vtmkhoi/Muscular-Atrophy-Measurement-System/docs/meetings/Chart.pptx

DDS
(AD9834)

Sin-wave generator

V_tissue

V_ref

Tetrapolar electrodes

Vp

Differential Amplifier

V_out

Single-Ended

LPF + HPF

V(sin_filt)

Voltage Controlled Current Source
(VCCS)

I(sin_filt)

Vn

SPI

MCU
STM32F411

DAC

Vmag_DC~ |Z|

Gain/Phase Detector
(AD8302 )

Vphs_DC

LOAD

## Power block

12V battery
input

+5V_Pre

Output +3v3 for MCLK and DVDD AD9834

ADP2303-5.0

ADP7118-3.3

TPS7A2033

ADP5070

MCU power

-5V Raw

ADP7182

-5V Analog

ADP7142-5.0

+5V_Analog

## Slide 3

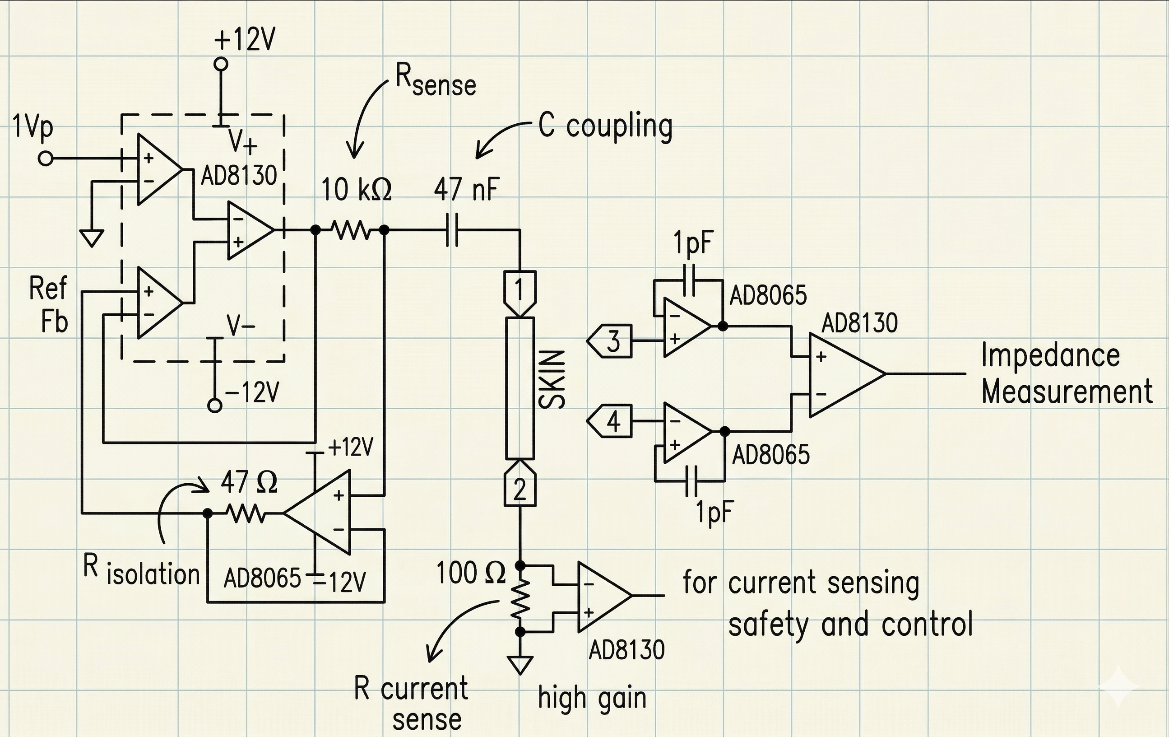
[picture p1: figure]

## Slide 4
