vtmkhoi/Muscular-Atrophy-Measurement-System/docs/meetings/weekly-meeting_29-03-2026.pptx

## BÁO CÁO TIẾN ĐỘ

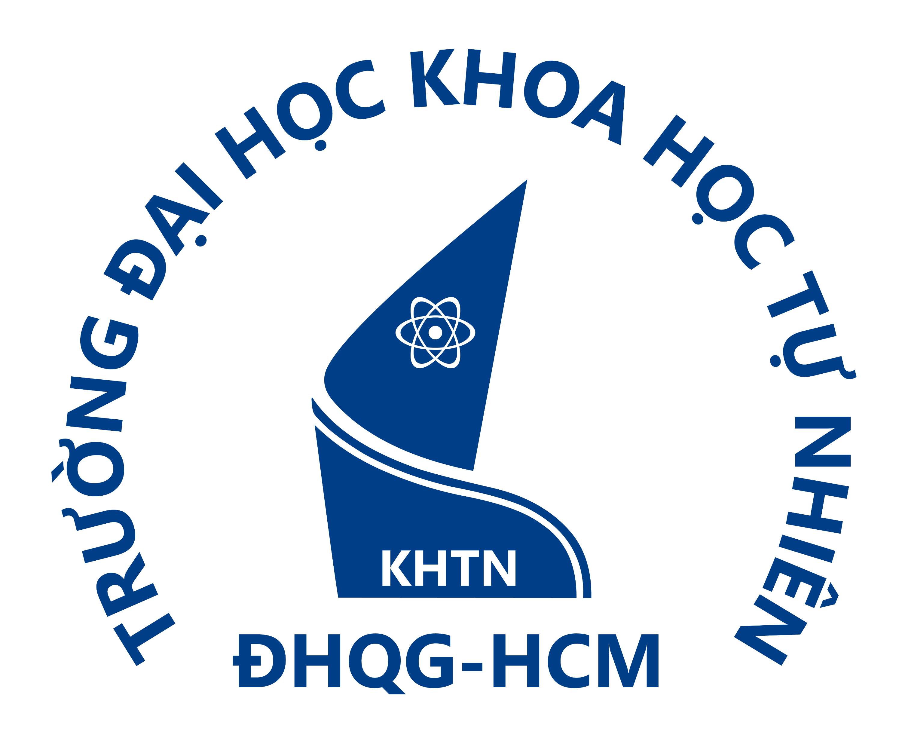
[picture p2: figure]

ĐẠI HỌC QUỐC GIA THÀNH PHỐ HỒ CHÍ MINH
ĐẠI HỌC KHOA HỌC TỰ NHIÊN

Khoa Điện tử - Viễn thông

CBHD: PGS. TS. Nguyễn Văn Hiếu
TS. Phan Thiện Luân
HVCH: Võ Tấn Minh Khôi

TP. HỒ CHÍ MINH, 2026

## Tiến độ

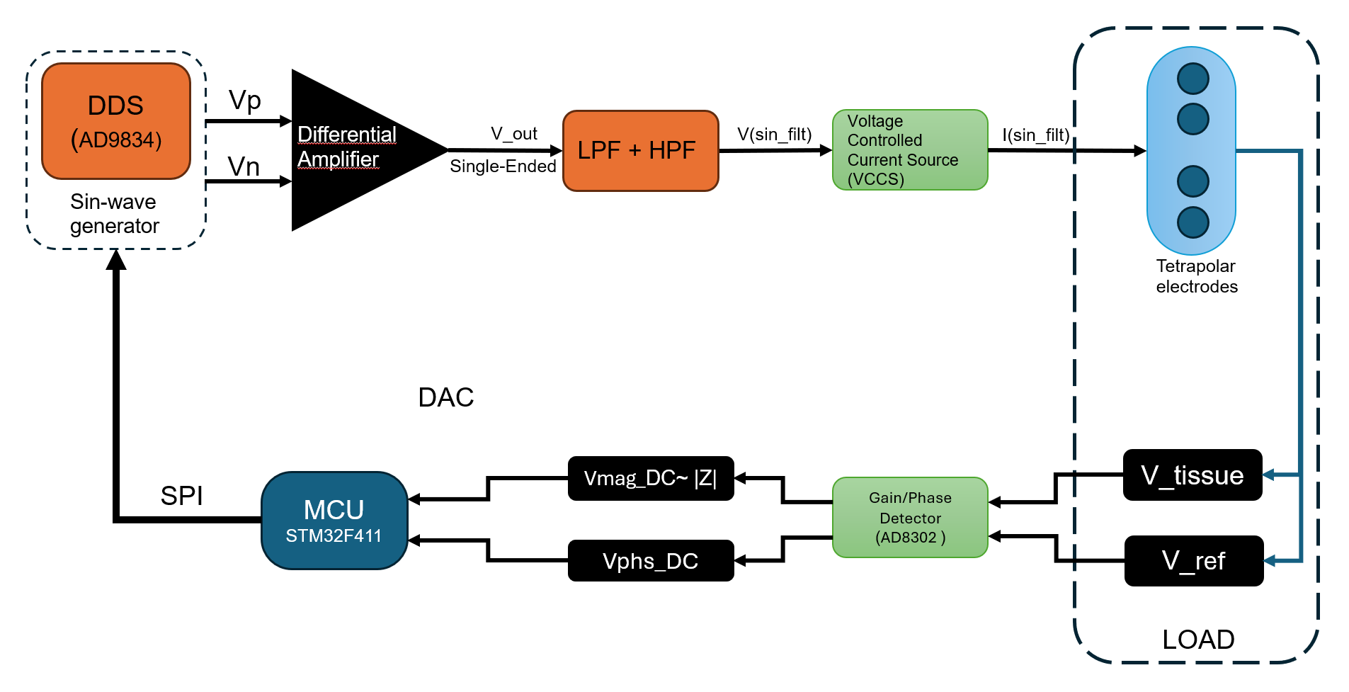
[picture p3: figure]

## Tiến độ

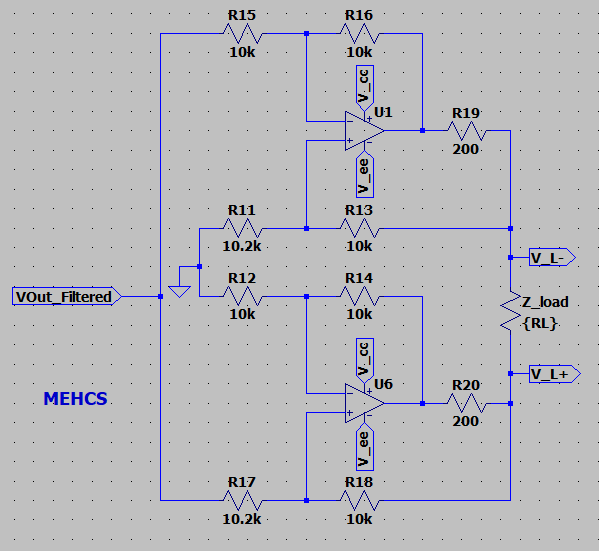
[picture p4: figure]
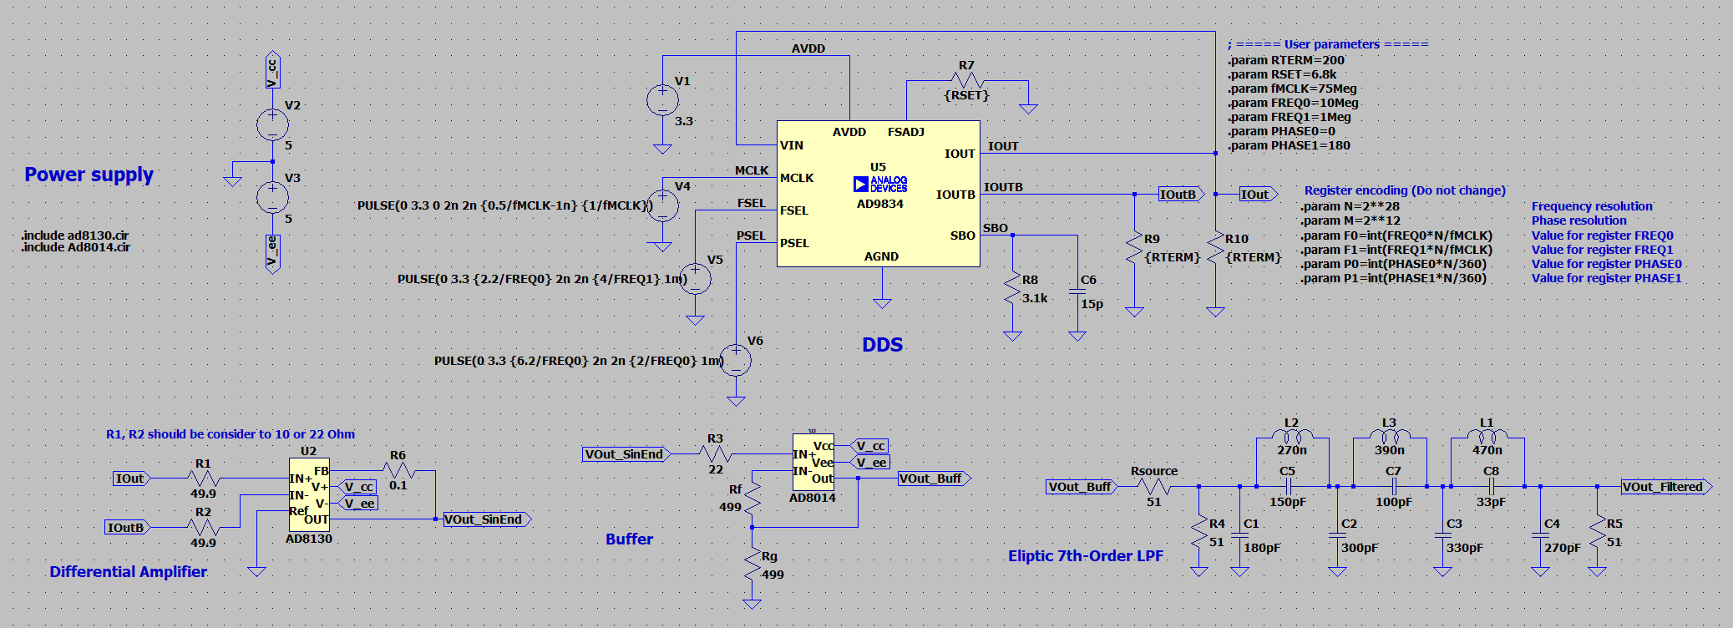
[picture p5: figure]

## Tiến độ

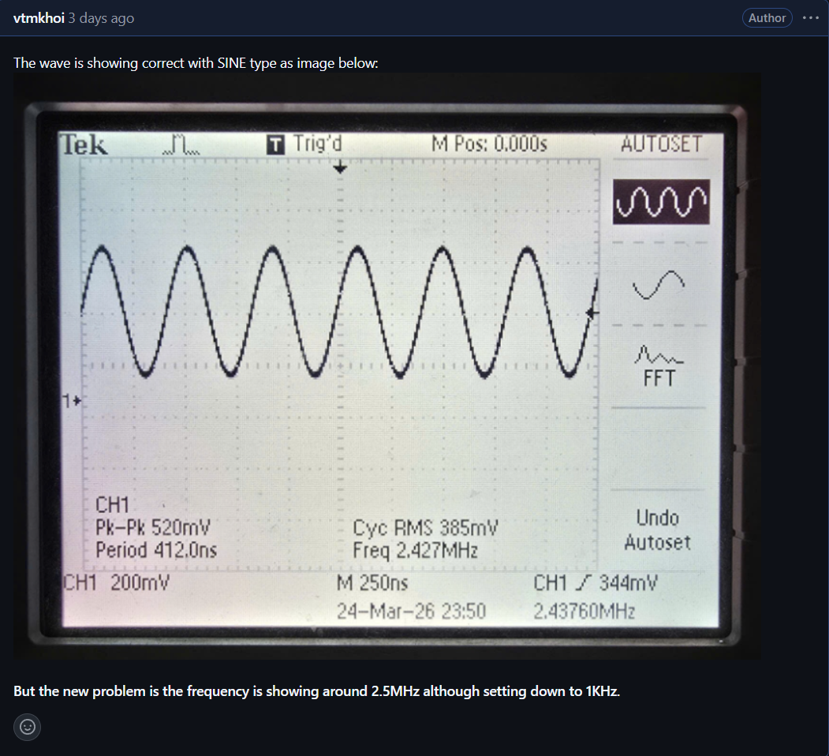
[picture p6: figure]
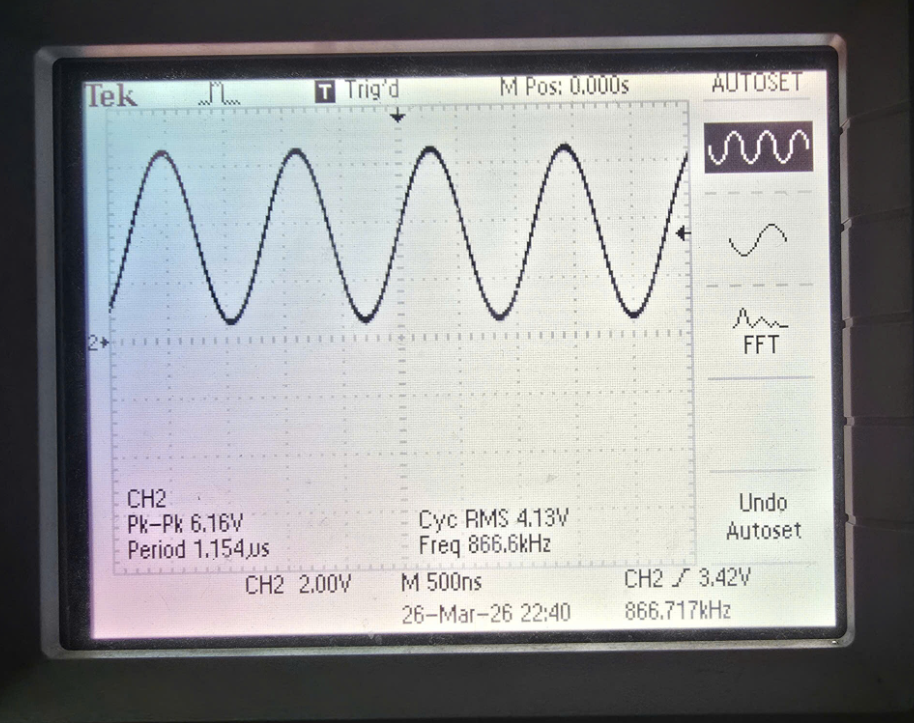
[picture p7: figure]

Analyze output Sine wave from prototype · MAMS (https://github.com/users/vtmkhoi/projects/1/views/1?pane=issue&itemId=168317257)

## Tiến độ

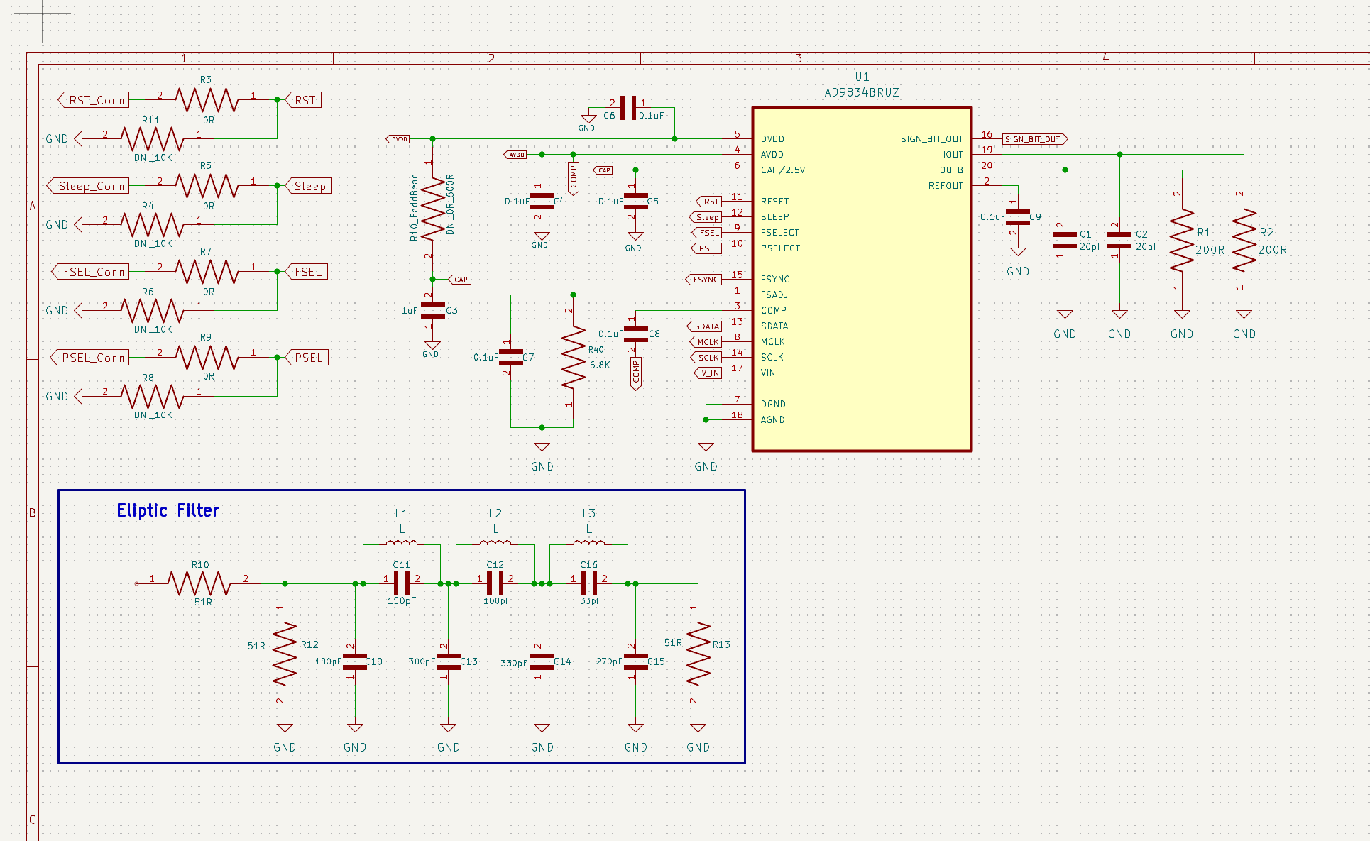
[picture p8: figure]

## Kế hoạch

- Hoàn thiện Schematic
- Layout PCB
- Mua lại module AD9834 để test waveform
