vtmkhoi/Muscular-Atrophy-Measurement-System/docs/AD9834 to AD8130 Differential-to-Single Interface for a 1–15 MHz EIM Signal Source.pdf

# AD9834 to AD8130 Differential-to-Single Interface for a 1–15 MHz EIM Signal Source

## Executive summary

For a 1–15 MHz Electrical Impedance Measurement (EIM) thesis signal source, the most robust, reference-backed way to connect AD9834 (DDS) to AD8130 (diff→single receiver amp) is to treat the AD9834 outputs exactly as a complementary current-output DAC and apply the same principles used in AN-1214 (AD8130 as receiver) and CN-0304 (AD9834 reconstruction filter + buffer) in a single chain.

The key implementation decisions are:

Convert AD9834 IOUT/IOUTB to two matched voltages with load resistors placed at the pins: AD9834 explicitly recommends 200 Ω from IOUT→AGND and preferably 200 Ω from IOUTB→AGND, plus ~20 pF to AGND to suppress clock feedthrough.
Use AD8130 as a true differential receiver: feed the two voltages into +IN (Pin 1) and −IN (Pin 8); set gain with RF/RG and set output common-mode with REF (Pin 4). The datasheet explicitly states gain is G = 1 + RF/RG, unity gain uses RF = 0 and remove RG.
Prefer ± rails for the AD8130 stage if possible: AD8130 supports wide total supply (down to ±2.25 V total, up to ±12.6 V total) and gives wide common-mode range on split supplies (e.g., ±5 V). This avoids the complexity of input level shifting.
Don’t drive the 50 Ω terminated elliptic LC filter directly from AD8130 at high swing: AD8130 guidance warns against directly driving heavy loads at high supply voltages and recommends a second stage where needed. Add a buffer/driver after AD8130.
Use a proven anti-imaging LPF: CN-0304’s 7th-order elliptic, 50 Ω terminated, −3 dB ≈ 18 MHz filter is validated for 15 MHz output and suppresses the largest image at 60 MHz by ~52 dB.
Add an HPF / AC-coupling stage before the VCCS to remove DC for electrode safety and to prevent DC offsets from biasing the current source.
Simulation is still worth doing even if the full AD8130 model is missing: you can import the official AD8130 macro-model from Analog Devices (license-gated), or use a behavioral diff-amp fallback to validate gain/filters.

## Primary sources and authoritative references

Prioritized primary sources (use these first)

AD9834 data sheet (pin-level requirements for IOUT/IOUTB loading, compliance, decoupling, grounding).
AD8129/AD8130 data sheet (true differential receiver behavior, gain networks, common-mode limits, layout rules around FB node).

•

1 (https://www.analog.com/media/en/technical-documentation/data-sheets/ad9834.pdf)
•

2 (https://www.analog.com/media/en/technical-documentation/data-sheets/ad8129_8130.pdf)
•
3 (https://www.analog.com/media/en/technical-documentation/data-sheets/ad8129_8130.pdf) | 4 (https://www.analog.com/media/en/technical-documentation/data-sheets/ad8129_8130.pdf)

•

5 (https://www.analog.com/media/en/technical-documentation/data-sheets/ad8129_8130.pdf)
•

6 (https://www.analog.com/media/en/reference-design-documentation/reference-designs/cn0304.pdf)
•

•

7
8 (https://www.analog.com/en/products/ad8130.html)

•

9 (https://www.analog.com/media/en/technical-documentation/data-sheets/ad9834.pdf)
•

10 (https://www.analog.com/media/en/technical-documentation/data-sheets/ad8129_8130.pdf)

AN-1214 (authoritative ADI reference showing AD8130 used specifically for complementary current-output DAC → single-ended conversion; includes input series resistors guidance and gain examples).

CN-0304 (authoritative end-to-end DDS output conditioning for bioimpedance/impedance spectroscopy use case; includes validated LPF values + measured image suppression).
Supporting, highly relevant references

UG-266 (EVAL-CN0304): shows AD9834 used in biomedical/impedance contexts and points to board-level practices and evaluation approach.
MT-085 (DDS fundamentals and image behavior) – referenced by CN-0304.
MT-031 / MT-101 (grounding mixed-signal converters + decoupling techniques) – explicitly cited by CN-0304 and consistent with AD9834 layout guidance.
TI SBOA436 (“Improved” Howland current pump) + TI AN-1515 (high-impedance VCCS fundamentals + stability/resistor-matching/reactive-load cautions that matter at MHz). User-uploaded copies (same primary documents, local to this chat)

AD9834 datasheet (uploaded).
AD8129/AD8130 datasheet (uploaded).
EVAL-CN0304 user guide (uploaded).

## Electrical interface: converting AD9834 IOUT/IOUTB into a clean differential voltage

What AD9834 expects at IOUT/IOUTB

AD9834’s DAC outputs are high-impedance current sources. The datasheet is unusually explicit about the recommended termination:

IOUT: connect a ~200 Ω load resistor to AGND.
IOUTB: preferably also connect ~200 Ω to AGND (or it may be tied directly to AGND if unused).
Add ~20 pF to AGND to reduce clock feedthrough.

This recommendation is reinforced by CN-0304, which uses RSET = 6.8 kΩ to set full-scale current near 3 mA, then chooses 200 Ω to stay inside compliance and produce about 0.6 V at full-scale.

RSET and amplitude math (why 200 Ω is “right” for AD9834)

AD9834 defines the full-scale DAC current as:

IOUT_FS = 18 × (FSADJUST / RSET) with FSADJUST ≈ 1.15 V and RSET ≈ 6.8 kΩ typical.

CN-0304 computes the same: IFS ≈ 3 mA, and with 200 Ω you get ~0.6 V output without exceeding DAC compliance.

The AD9834 specification table also indicates typical IOUT full scale ≈ 3.0 mA, VOUT max ≈ 0.6 V, and output compliance ≈ 0.8 V (so larger RLOAD risks distortion).

•

11 (https://www.analog.com/media/en/technical-documentation/app-notes/an-1214.pdf)
•

12 (https://www.analog.com/media/en/reference-design-documentation/reference-designs/cn0304.pdf)

•

13 (https://www.analog.com/media/en/technical-documentation/user-guides/ug-266.pdf)
- 14 (https://www.analog.com/media/en/training-seminars/tutorials/MT-085.pdf)
•

15 (https://www.analog.com/media/en/training-seminars/tutorials/MT-031.pdf)
•

16 (https://www.ti.com/lit/pdf/sboa436)

•
•
•

•
•
- 17 (https://www.analog.com/media/en/technical-documentation/data-sheets/ad9834.pdf)

18 (https://www.analog.com/media/en/reference-design-documentation/reference-designs/cn0304.pdf)

- 19 (https://www.analog.com/media/en/technical-documentation/data-sheets/ad9834.pdf)

20 (https://www.analog.com/media/en/reference-design-documentation/reference-designs/cn0304.pdf)

21 (https://www.analog.com/media/en/technical-documentation/data-sheets/ad9834.pdf)

Creating differential voltage for the AD8130 inputs

With two 200 Ω resistors to AGND:

Node Vp = IOUT × 200 Ω
Node Vn = IOUTB × 200 Ω

Because the currents are complementary, these voltages are approximately 180° out of phase, and the differential input to the AD8130 is:

Vdiff = Vp − Vn, which is about 2× the single-ended amplitude (minus any mismatch / DAC nonidealities).

This is exactly the mechanism described in AN-1214 for a complementary current-output DAC: each output develops a voltage across its load resistor that is opposing phase and forms a differential input for the AD8130.

Placement, matching, and parasitics (critical at 10–15 MHz)

At 10–15 MHz, the “small” details determine whether you get clean spectra and stable gain:

Place RLOAD and the 20 pF capacitors right at the AD9834 IOUT pins (short return to AGND). AD9834’s own grounding/decoupling section emphasizes close placement of decoupling and careful mixed-signal layout.
Match the two channels: use the same package size for both RLOAD and both Cfeedthrough; keep traces from IOUT and IOUTB to the load components symmetric in length and geometry.
Use low-parasitic passives: CN-0304 warns that at these frequencies passive components must have low parasitics and low tolerances to match simulated response.
If you will later measure phase precisely (EIM), even small mismatches create phase skew. That becomes “measurement error,” not just “signal conditioning error.”
DC biasing and AC-coupling options

You have two viable philosophies; choose based on your available power rails.

Option A: use split supplies at AD8130 (simplest, best fidelity)
- Keep AD9834 load resistors to AGND as recommended.
- Run AD8130 on ±2.5 V to ±5 V (total supply meets spec).
- Tie REF (Pin 4) = 0 V to generate a ground-referenced single-ended output (then later you can AC-couple before electrodes).
This avoids any input level shifting and keeps the AD9834 output compliance referenced correctly to AGND.

Option B: single +5 V only (works, but requires AC coupling into AD8130)
AD8130’s common-mode range on single supply is limited (example shown in specs).
Because AD9834’s output voltage sits near ground (0–0.6 V typical), the clean approach is: - Keep AD9834 loads to AGND (compliance-safe).
- AC-couple Vp and Vn into AD8130 inputs, then bias both inputs to mid-supply (2.5 V) with equal resistors.
- Set REF = 2.5 V so the output is biased mid-supply.

•
•

•

22 (https://www.analog.com/media/en/technical-documentation/app-notes/an-1214.pdf)

•

23 (https://www.analog.com/media/en/technical-documentation/data-sheets/ad9834.pdf)
•

•

24 (https://www.analog.com/media/en/reference-design-documentation/reference-designs/cn0304.pdf)
•

25 (https://www.analog.com/media/en/technical-documentation/data-sheets/ad9834.pdf)
26

4 (https://www.analog.com/media/en/technical-documentation/data-sheets/ad8129_8130.pdf)

A practical starting point (for 1 MHz minimum): - CIN+ = CIN− = 100 pF to 1 nF (C0G/NP0)
- RBIAS+ = RBIAS− = 10 kΩ to VREF = 2.5 V
This yields fc between ~160 kHz (100 pF & 10 kΩ) and ~16 kHz (1 nF & 10 kΩ), comfortably below 1 MHz while avoiding huge bias resistors.

## AD8130 hookup details and a complete recommended chain

AD8130 pins you will actually use

From the AD8129/AD8130 datasheet pin diagram:

Pin 1: +IN
Pin 8: −IN
Pin 4: REF (output reference / level shifting) Pin 5: FB (feedback node for gain setting) Pin 6: OUT
Pin 7: +VS, Pin 2: −VS
Pin 3: PD (power-down control)

Power-down thresholds are specified relative to +VS (VIH ≈ +VS − 1.5 V, VIL ≈ +VS − 2.5 V).

Core topology (recommended for AD9834 differential drive)

Use the datasheet Basic Gain Circuit (Figure 132), which explicitly supports differential input and states:

“The input signal can be applied either differentially or in a single-ended fashion—all that matters is the magnitude of the differential signal between the two inputs.”

Gain is:

G = 1 + RF/RG, with unity gain achieved by RF = 0 and remove RG.

Recommended values (two practical gain targets)

Gain = 1 (unity, best linearity and stability margin in many layouts) - RF = 0 Ω (short OUT→FB)
- RG omitted
This exactly matches datasheet guidance for AD8130 unity gain.

Gain ≈ 3.5 (use when you need to overcome 50 Ω filter insertion loss and still drive VCCS) - Option 1 (E96-friendly): RG = 499 Ω, RF = 1.24 kΩ → G ≈ 1 + 1240/499 ≈ 3.49
- Option 2 (common values): RG = 402 Ω, RF = 1.00 kΩ → G ≈ 3.49

AN-1214 provides a canonical mid-level example for Gain = 2 using RF = RG = 499 Ω, which validates this resistor scale for high-speed use.

•
•
•
•
•
•
- 27

3 (https://www.analog.com/media/en/technical-documentation/data-sheets/ad8129_8130.pdf)

•

28 (https://www.analog.com/media/en/technical-documentation/data-sheets/ad8129_8130.pdf)

- 2

2 (https://www.analog.com/media/en/technical-documentation/data-sheets/ad8129_8130.pdf)

29 (https://www.analog.com/media/en/technical-documentation/app-notes/an-1214.pdf)

Input series resistors (strongly recommended)

AN-1214 explicitly states that series resistors at the AD8130 input pins improve distortion performance (they used 49.9 Ω).

For AD9834, start with: - RIN+ = RIN− = 49.9 Ω (0402/0603, 1%) placed at the AD8130 pins.

If you are fighting amplitude loss or bandwidth peaking, you can sweep 10–49.9 Ω in lab.

REF pin usage (level shifting)

With ± rails, use REF = 0 V for a ground-referenced output.
With single-supply, use REF = VREF = mid-supply (e.g., 2.5 V).

The datasheet provides multiple “output offset/level translator” examples showing that the REF pin controls output level.

Why you should add a buffer/driver after AD8130

CN-0304’s architecture is DDS → buffer → 50 Ω terminated LC LPF because: - DDS current output and compliance are limited, and the buffer provides isolation and converts the loaded DDS impedance to 50 Ω for a terminated filter.

Similarly, AD8130 is a fast receiver but its datasheet cautions that at high supply voltages and heavy load it is better to use a second stage, and that some gain can be shifted to this stage.

So, treat AD8130 primarily as your diff→SE + gain/level stage, then use a dedicated driver to: - drive the reactive LC filter, - provide a known source impedance (50 Ω environment), - protect AD8130’s FB node from load-induced instability.

Full end-to-end chain wiring (explicit values + rationale)

The following chain is “thesis-safe” because every stage is supported by a primary reference design or datasheet rule.

Download the one-page schematic diagram (PNG)

Stage 1 — AD9834 DAC outputs to voltage

RSET = 6.8 kΩ (FS current setpoint; typical).
RLOAD_IOUT = 200 Ω to AGND.
RLOAD_IOUTB = 200 Ω to AGND (preferred).
CFT_IOUT = 20 pF to AGND; CFT_IOUTB = 20 pF to AGND (clock feedthrough suppression).

22 (https://www.analog.com/media/en/technical-documentation/app-notes/an-1214.pdf)

•
•

30 (https://www.analog.com/media/en/technical-documentation/data-sheets/ad8129_8130.pdf)

31 (https://www.analog.com/media/en/reference-design-documentation/reference-designs/cn0304.pdf)

5 (https://www.analog.com/media/en/technical-documentation/data-sheets/ad8129_8130.pdf)

One-page chain schematic

- 32 (https://www.analog.com/media/en/technical-documentation/data-sheets/ad9834.pdf)
- 25 (https://www.analog.com/media/en/technical-documentation/data-sheets/ad9834.pdf)
- 17 (https://www.analog.com/media/en/technical-documentation/data-sheets/ad9834.pdf)
- 17 (https://www.analog.com/media/en/technical-documentation/data-sheets/ad9834.pdf)

Rationale: This keeps the DAC within its compliance limits and yields a predictable amplitude (~0.6 V scale) validated in CN-0304.

Stage 2 — AD8130 differential receiver (diff→single + gain)

RIN+ = RIN− = 49.9 Ω series into +IN and −IN (distortion aid).
Gain network:
Unity: RF = 0, RG omitted.
Gain≈3.49: RG=499 Ω, RF=1.24 kΩ (or RG=402 Ω, RF=1.00 kΩ). Gain law is from datasheet. REF (Pin 4):
± rails: REF = 0 V
single-supply: REF = 2.5 V (filtered Vref node).
Output: start with ROUT = 22 Ω in series at the AD8130 output before the driver input (stability/edge control).

Supply notes: - AD8130 supports from single +5 V up to ±12 V class supplies.
- Its common-mode range depends on supply; check your chosen mode.

Layout notes: - Keep ground away from FB (Pin 5) to reduce stray capacitance and preserve gain flatness; bypass supplies with 0.01–0.1 µF close and 10 µF farther.

Stage 3 — Buffer/driver (choose one)

Baseline choice (closest to CN-0304): AD8014
CN-0304 uses AD8014 as the buffer to drive a high-quality 50 Ω filter, operating AD8014 on +4.5 V while AD9834 is on +3.3 V.

For single-supply drivers, use the same biasing idea as CN-0304 (AC coupling + mid-supply bias) and the single-supply biasing principles from AN-581.

Alternative driver options (all credible at 15 MHz; pick based on supply/current/noise needs): - AD8057 (VFB): wide supply range and high-speed VFB option.
- OPA695 (CFB): extremely high bandwidth and high output current, can serve as a strong 50 Ω driver.
- LMH6702 (CFB): designed as a wideband low-distortion driver/buffer.

Rationale: CN-0304 explicitly justifies using a buffer to provide isolation and 50 Ω drive for a terminated filter.

Stage 4 — 7th-order elliptic 50 Ω LPF (anti-imaging)

Use the exact CN-0304 LC network (validated at 15 MHz output with 75 MSPS clock):

Terminations: R22 = 51 Ω, R24 = 51 Ω
L1 = 270 nH, C18 = 180 pF, C19 = 150 pF
C21 = 300 pF, L2 = 390 nH, C17 = 100 pF
C22 = 330 pF, L3 = 470 nH, C23 = 33 pF, C24 = 270 pF

33 (https://www.analog.com/media/en/reference-design-documentation/reference-designs/cn0304.pdf)

- 34 (https://www.analog.com/media/en/technical-documentation/app-notes/an-1214.pdf)
•
- 2 (https://www.analog.com/media/en/technical-documentation/data-sheets/ad8129_8130.pdf)
- 2 (https://www.analog.com/media/en/technical-documentation/data-sheets/ad8129_8130.pdf)
•
•
•
•

35
4

36 (https://www.analog.com/media/en/technical-documentation/data-sheets/ad8129_8130.pdf)

37

38 (https://www.analog.com/media/en/reference-design-documentation/reference-designs/cn0304.pdf)

39 (https://www.analog.com/media/en/technical-documentation/data-sheets/ad8057_8058.pdf)
40 (https://www.ti.com/lit/ds/symlink/opa695.pdf)
41 (https://www.ti.com/lit/gpn/LMH6702)

42 (https://www.analog.com/media/en/reference-design-documentation/reference-designs/cn0304.pdf)

•
•
•
- 43 (https://www.analog.com/media/en/reference-design-documentation/reference-designs/cn0304.pdf)

What you should expect if implemented correctly: - −3 dB bandwidth ≈ 18 MHz,
- passband loss ≈ 6 dB due to source/load termination,
- image at 60 MHz suppressed by ~52 dB vs unfiltered (CN-0304 measurement).

Stage 5 — HPF / AC coupling before VCCS

Place this after the LPF and before the VCCS:

Example: CAC = 47 pF, RBIAS = 10 kΩ → fc ≈ 1/(2π·10k·47p) ≈ 339 kHz (well below 1 MHz).

Rationale: removes DC offsets and helps keep electrode injection safe and repeatable.

Stage 6 — VCCS (Improved Howland) to electrodes

At 1–15 MHz this is typically the hardest block. Two authoritative cautions apply:

Resistor mismatch reduces CMRR and causes gain error; reactive loads need special precautions.

Stability and output impedance trimming are practical issues even at low frequencies; at MHz they become dominant.

If your VCCS op-amp cannot sustain loop gain at 15 MHz into a capacitive electrode model, you’ll see current droop and/or oscillation regardless of how perfect the DDS chain is.

## Simulation approach in LTspice

Using the official AD8130 macro-model

The official AD8130 product page provides an “AD8130 SPICE Macro Model” download under Tools & Simulations.
It is license-gated when accessed directly.
LTspice import workflow (recommended) 1. Download the macro-model ( | ad8130.cir | ) from the
AD8130 page (accept license).
2. Follow ADI’s official LTspice guide for importing third-party | .SUBCKT | models.
3. Open the | .cir | file and find the | .SUBCKT AD8130 ... | line; the pin order listed there is the netlist
order you must match (either by building a custom symbol or mapping pins correctly). 4. In your
schematic, add: - a SPICE directive: | .include ad8130.cir | - a symbol using Prefix = X (subcircuit call)
referencing the correct subckt name.

ADI’s LTspice guidance emphasizes that intrinsic symbols can only be reused if the pin/port order matches
the | .SUBCKT | definition.

Behavioral model fallback (when you only need architecture validation)

If your goal is to validate: - amplitude vs frequency, - LPF image suppression, - gross stability of the chain,

44
45 (https://www.analog.com/media/en/reference-design-documentation/reference-designs/cn0304.pdf)

•

•

16 (https://www.ti.com/lit/pdf/sboa436)
•

46 (https://www.ti.com/lit/pdf/snoa474)

47 (https://www.analog.com/en/products/ad8130.html)
48 (https://www.analog.com/media/en/simulation-models/spice-models/ad8130.cir)

49 (https://www.analog.com/en/products/ad8130.html)
50 (https://www.analog.com/en/resources/technical-articles/ltspice-how-to-import-third-party-models.html)

51 (https://www.analog.com/en/resources/technical-articles/ltspice-using-an-intrinsic-symbol-for-a-third-party-model.html)

you can use a simplified behavioral differential amplifier:

Vout = Vref + G·(Vp − Vn)
Add a single-pole rolloff near 150–250 MHz to approximate bandwidth limits (AD8130 is ~270 MHz at small output).

Example LTspice-style snippet (conceptual):

* Behavioral AD8130 (simplified)
.subckt AD8130_BEH VP VN VMIN REF FB OUT VPLUS PD .param G=3.49
* ideal diff gain + reference
BID n_id 0 V = { V(REF) + G*(V(VP)-V(VN)) }
* 1-pole bandwidth limit (e.g., 200 MHz)
EOUT OUT 0 LAPLACE {V(n_id)} = { 1 / (1 + s/(2*pi*200Meg)) }
.ends

This will not match distortion or overload recovery, but it is enough to decide: - whether your gain plan is correct, - whether the elliptic filter values meet the 15 MHz passband, - whether you have enough headroom into the VCCS load model.

Recommended simulation sequence for your thesis chain

AC analysis: From AD8130 output → through driver → through elliptic LPF, verify −3 dB ≈ 18 MHz and observe stopband attenuation near 60 MHz. CN-0304’s measured vs simulated response is your benchmark.
Transient + FFT at 15 MHz: Confirm image locations (DDS is sampled-data; requires anti-imaging).

Step through 1 MHz → 15 MHz: track amplitude flatness and phase shift.
Add electrode load model (R || C) and validate VCCS stability per TI guidance (reactive load precautions).

## PCB/layout best practices, failure modes, and verification plan

PCB/layout practices that matter most at 10–15 MHz

Grounding and planes - AD9834 recommends strong decoupling and careful AGND/DGND strategy (connect at a single point / star near the device in multi-device systems).
- For AD8130, use a solid ground plane but pull back copper around FB to reduce stray capacitance.

Decoupling - AD9834: decouple both analog and digital supplies, keep caps close; use AVDD supply strategy if shared.
- AD8130: 0.01–0.1 µF close per rail, 10 µF farther per rail.

Symmetry - Route IOUT and IOUTB networks symmetrically: equal trace lengths, same via count, same component packages. This directly improves phase accuracy for EIM.

•
•

52 (https://www.analog.com/media/en/technical-documentation/data-sheets/ad8129_8130.pdf)

•

53 (https://www.analog.com/media/en/reference-design-documentation/reference-designs/cn0304.pdf)
•

54 (https://www.analog.com/media/en/reference-design-documentation/reference-designs/cn0304.pdf)
•
•

16 (https://www.ti.com/lit/pdf/sboa436)

23 (https://www.analog.com/media/en/technical-documentation/data-sheets/ad9834.pdf)
36 (https://www.analog.com/media/en/technical-documentation/data-sheets/ad8129_8130.pdf)

55 (https://www.analog.com/media/en/technical-documentation/data-sheets/ad9834.pdf)
36 (https://www.analog.com/media/en/technical-documentation/data-sheets/ad8129_8130.pdf)

Test points - Add test nodes (or u.FL/SMA) at: - Vp and Vn (after 200 Ω loads), - AD8130 output, - driver output, - LPF output, - VCCS output current-sense resistor.

Common failure modes to watch at 10–15 MHz

DAC compliance violation (RLOAD too large or bias shifted incorrectly) → heavy distortion/spurs.

AD8130 FB node parasitics → peaking/flatness loss/oscillation; datasheet warns FB node stray C must be minimized.
Trying to drive the LC filter directly from AD8130 at large swing → thermals/stability; datasheet suggests using a second stage in heavy-load cases.
Reactive VCCS load instability (electrodes are not pure resistors) → oscillation or current droop; TI explicitly warns special precautions are needed for reactive loads in Howland pumps.
Measurement and verification plan (bench)

A practical thesis verification sequence:

Step 1: verify AD9834 output amplitude and symmetry

Measure Vp and Vn (after the 200 Ω loads). Expect complementary waveforms with amplitude consistent with RSET and compliance.

Step 2: verify AD8130 diff→single conversion

Confirm gain = 1 + RF/RG and output reference set by REF.

Sweep amplitude to ensure no clipping; compare to differential clipping guidance.

Step 3: confirm LPF frequency response

If you have access to a network analyzer, reproduce CN-0304’s key targets: ~18 MHz −3 dB, ~6 dB passband loss in 50 Ω environment.

Step 4: spectral image suppression at 15 MHz output

Measure spectrum at LPF output. CN-0304 reports the 60 MHz image is reduced ~52 dB relative to unfiltered output. Your pass/fail target should be “same order,” assuming proper layout and component Q.

Step 5: VCCS verification with dummy loads

Use resistor and resistor||capacitor loads before electrodes; verify current amplitude flatness and check for oscillation. TI Howland references highlight resistor mismatch and reactive-load risk.

•

21 (https://www.analog.com/media/en/technical-documentation/data-sheets/ad9834.pdf)
•

36 (https://www.analog.com/media/en/technical-documentation/data-sheets/ad8129_8130.pdf)
•

5 (https://www.analog.com/media/en/technical-documentation/data-sheets/ad8129_8130.pdf)
•

16 (https://www.ti.com/lit/pdf/sboa436)

•

•

56 (https://www.analog.com/media/en/technical-documentation/data-sheets/ad9834.pdf)

•

- 57 (https://www.analog.com/media/en/technical-documentation/data-sheets/ad8129_8130.pdf)
- 4 (https://www.analog.com/media/en/technical-documentation/data-sheets/ad8129_8130.pdf)

•

•

53 (https://www.analog.com/media/en/reference-design-documentation/reference-designs/cn0304.pdf)

•

•

45 (https://www.analog.com/media/en/reference-design-documentation/reference-designs/cn0304.pdf)

•

•

16 (https://www.ti.com/lit/pdf/sboa436)

## Comparison table of recommended values and parts (with procurement links)

Stage Item

Recommended
value

Suggested MPN

(package) | Why / notes | Example
link
DDS | DDS IC | —

AD9834BRUZ
(TSSOP-20)

AD9834 complete
DDS; outputs
require proper
loading/filters

DDS→V

Load resistors
(x2)

200 Ω, 1%
(0402/0603)

Any low-parasitic
200 Ω (thick film
or thin film)

Per AD9834, 200 Ω
keeps compliance
& provides
amplitude

DDS→V

Feedthrough
caps (x2)

20 pF C0G

Any 20 pF NP0/
C0G

Per AD9834:
suppress clock
feedthrough
Diff→SE | Receiver amp | —

AD8130ARZ
(SOIC-8) or
AD8130ARMZ
(MSOP-8)

Differential
receiver; high
CMRR; gain set by
RF/RG

Diff→SE

Input series
resistors (x2)

49.9 Ω Any 49.9 Ω 1%

AN-1214: series
resistors improve
distortion
Diff→SE | Gain set | RF/RG

RG=499 Ω,
RF=1.24 kΩ →
G≈3.49

G=1+RF/RG per
datasheet

Driver
(option)
CFB buffer | —

AD8014ARZ
(SOIC-8)

CN-0304 proven as
DDS buffer to drive
50 Ω filter

Driver
(option)
VFB buffer | —

AD8057ARZ
(SOIC-8)

Alternative high-speed VFB
amplifier

Driver
(option)

Ultra-
wideband CFB | —

OPA695 (various
packages)

Very high
bandwidth/current
for 50 Ω driving

Driver
(option)

Wideband low
distortion | —

LMH6702 (various
packages)

High-fidelity
wideband driver/
buffer

58 (https://www.digikey.com/en/products/detail/analog-devices-inc/AD9834BRUZ/621882)

25

17 (https://www.analog.com/media/en/technical-documentation/data-sheets/ad9834.pdf)

59 (https://www.digikey.com/en/products/detail/analog-devices-inc/AD8130ARZ/751140)

60 (https://www.analog.com/media/en/technical-documentation/app-notes/an-1214.pdf)

2 (https://www.analog.com/media/en/technical-documentation/data-sheets/ad8129_8130.pdf)

61 (https://www.digikey.com/en/products/detail/analog-devices-inc/AD8014ARZ/620459)

62 (https://www.digikey.com/en/products/detail/analog-devices-inc/AD8057ARZ/620675)

63 (https://www.ti.com/lit/ds/symlink/opa695.pdf)

64 (https://www.ti.com/lit/gpn/LMH6702)

Stage Item

Recommended
value

Suggested MPN

(package) | Why / notes | Example link

LPF

Elliptic filter

values | (see list) | L/C high-Q RF
| | passives

CN-0304 validated:
fc≈18 MHz, image
suppression

VCCS

Howland

reference | — | (depends on your
| | VCCS op-amp
| | choice)

Match resistors;
reactive loads
need precautions

Practical implementation checklist for your thesis build

Implement exactly the AD9834 output loading rule (200 Ω + 20 pF at the pins).
Build AD8130 as Figure 132 “basic gain circuit,” drive it differentially, and obey FB-node layout rules.

Use a dedicated driver stage before the 50 Ω elliptic LPF; CN-0304’s buffer+filter is the correct “known-good” reference for 15 MHz.
Validate LPF response + image suppression on the bench before integrating the VCCS, using CN-0304’s measured results as acceptance targets.
Treat the VCCS as a separate high-speed control-loop problem; include reactive load models and follow Howland stability cautions.

AD9834 (Rev. D)
https://www.analog.com/media/en/technical-documentation/data-sheets/ad9834.pdf
https://www.analog.com/media/en/technical-documentation/data-sheets/ad8129_8130.pdf
https://www.analog.com/media/en/technical-documentation/data-sheets/ad8129_8130.pdf
CN-0304
https://www.analog.com/media/en/reference-design-documentation/reference-designs/cn0304.pdf
https://www.analog.com/en/products/ad8130.html
https://www.analog.com/en/products/ad8130.html
AN-1214 (Rev. A)
https://www.analog.com/media/en/technical-documentation/app-notes/an-1214.pdf
UG-266 (Rev.C)
https://www.analog.com/media/en/technical-documentation/user-guides/ug-266.pdf
https://www.analog.com/media/en/training-seminars/tutorials/MT-085.pdf
https://www.analog.com/media/en/training-seminars/tutorials/MT-085.pdf
https://www.analog.com/media/en/training-seminars/tutorials/MT-031.pdf
https://www.analog.com/media/en/training-seminars/tutorials/MT-031.pdf
https://www.ti.com/lit/pdf/sboa436
https://www.ti.com/lit/pdf/sboa436

65 (https://www.analog.com/media/en/reference-design-documentation/reference-designs/cn0304.pdf)

16 (https://www.ti.com/lit/pdf/sboa436)

- 17 (https://www.analog.com/media/en/technical-documentation/data-sheets/ad9834.pdf)
•

66 (https://www.analog.com/media/en/technical-documentation/data-sheets/ad8129_8130.pdf)
•

67 (https://www.analog.com/media/en/reference-design-documentation/reference-designs/cn0304.pdf)
•

45 (https://www.analog.com/media/en/reference-design-documentation/reference-designs/cn0304.pdf)
•

16 (https://www.ti.com/lit/pdf/sboa436)

1 (https://www.analog.com/media/en/technical-documentation/data-sheets/ad9834.pdf) | 9 (https://www.analog.com/media/en/technical-documentation/data-sheets/ad9834.pdf) | 17 (https://www.analog.com/media/en/technical-documentation/data-sheets/ad9834.pdf) 19 (https://www.analog.com/media/en/technical-documentation/data-sheets/ad9834.pdf) 21 (https://www.analog.com/media/en/technical-documentation/data-sheets/ad9834.pdf) 23 (https://www.analog.com/media/en/technical-documentation/data-sheets/ad9834.pdf) 25 (https://www.analog.com/media/en/technical-documentation/data-sheets/ad9834.pdf) 32 (https://www.analog.com/media/en/technical-documentation/data-sheets/ad9834.pdf) 55 (https://www.analog.com/media/en/technical-documentation/data-sheets/ad9834.pdf) 56 (https://www.analog.com/media/en/technical-documentation/data-sheets/ad9834.pdf)
2 (https://www.analog.com/media/en/technical-documentation/data-sheets/ad8129_8130.pdf) | 3 (https://www.analog.com/media/en/technical-documentation/data-sheets/ad8129_8130.pdf) | 4 (https://www.analog.com/media/en/technical-documentation/data-sheets/ad8129_8130.pdf) | 5 (https://www.analog.com/media/en/technical-documentation/data-sheets/ad8129_8130.pdf) | 10 (https://www.analog.com/media/en/technical-documentation/data-sheets/ad8129_8130.pdf) 26 (https://www.analog.com/media/en/technical-documentation/data-sheets/ad8129_8130.pdf) 27 (https://www.analog.com/media/en/technical-documentation/data-sheets/ad8129_8130.pdf) 28 (https://www.analog.com/media/en/technical-documentation/data-sheets/ad8129_8130.pdf) 30 (https://www.analog.com/media/en/technical-documentation/data-sheets/ad8129_8130.pdf) 35 (https://www.analog.com/media/en/technical-documentation/data-sheets/ad8129_8130.pdf) 36 (https://www.analog.com/media/en/technical-documentation/data-sheets/ad8129_8130.pdf) 52 (https://www.analog.com/media/en/technical-documentation/data-sheets/ad8129_8130.pdf) 57 (https://www.analog.com/media/en/technical-documentation/data-sheets/ad8129_8130.pdf) 66 (https://www.analog.com/media/en/technical-documentation/data-sheets/ad8129_8130.pdf)
6 (https://www.analog.com/media/en/reference-design-documentation/reference-designs/cn0304.pdf) | 12 (https://www.analog.com/media/en/reference-design-documentation/reference-designs/cn0304.pdf) 18 (https://www.analog.com/media/en/reference-design-documentation/reference-designs/cn0304.pdf) 20 (https://www.analog.com/media/en/reference-design-documentation/reference-designs/cn0304.pdf) 24 (https://www.analog.com/media/en/reference-design-documentation/reference-designs/cn0304.pdf) 31 (https://www.analog.com/media/en/reference-design-documentation/reference-designs/cn0304.pdf) 33 (https://www.analog.com/media/en/reference-design-documentation/reference-designs/cn0304.pdf) 37 (https://www.analog.com/media/en/reference-design-documentation/reference-designs/cn0304.pdf) 38 (https://www.analog.com/media/en/reference-design-documentation/reference-designs/cn0304.pdf) 42 (https://www.analog.com/media/en/reference-design-documentation/reference-designs/cn0304.pdf) 43 (https://www.analog.com/media/en/reference-design-documentation/reference-designs/cn0304.pdf) 44 (https://www.analog.com/media/en/reference-design-documentation/reference-designs/cn0304.pdf) 45 (https://www.analog.com/media/en/reference-design-documentation/reference-designs/cn0304.pdf) 53 (https://www.analog.com/media/en/reference-design-documentation/reference-designs/cn0304.pdf) 54 (https://www.analog.com/media/en/reference-design-documentation/reference-designs/cn0304.pdf) 65 (https://www.analog.com/media/en/reference-design-documentation/reference-designs/cn0304.pdf) 67 (https://www.analog.com/media/en/reference-design-documentation/reference-designs/cn0304.pdf)
7 (https://www.analog.com/en/products/ad8130.html) | 8 (https://www.analog.com/en/products/ad8130.html) | 47 (https://www.analog.com/en/products/ad8130.html) 49 (https://www.analog.com/en/products/ad8130.html)

11 (https://www.analog.com/media/en/technical-documentation/app-notes/an-1214.pdf) 22 (https://www.analog.com/media/en/technical-documentation/app-notes/an-1214.pdf) 29 (https://www.analog.com/media/en/technical-documentation/app-notes/an-1214.pdf) 34 (https://www.analog.com/media/en/technical-documentation/app-notes/an-1214.pdf) 60 (https://www.analog.com/media/en/technical-documentation/app-notes/an-1214.pdf)

13 (https://www.analog.com/media/en/technical-documentation/user-guides/ug-266.pdf)

14 (https://www.analog.com/media/en/training-seminars/tutorials/MT-085.pdf)

15 (https://www.analog.com/media/en/training-seminars/tutorials/MT-031.pdf)

16 (https://www.ti.com/lit/pdf/sboa436)

https://www.analog.com/media/en/technical-documentation/data-sheets/ad8057_8058.pdf
https://www.analog.com/media/en/technical-documentation/data-sheets/ad8057_8058.pdf
https://www.ti.com/lit/ds/symlink/opa695.pdf
https://www.ti.com/lit/ds/symlink/opa695.pdf
https://www.ti.com/lit/gpn/LMH6702
https://www.ti.com/lit/gpn/LMH6702
https://www.ti.com/lit/pdf/snoa474
https://www.ti.com/lit/pdf/snoa474
https://www.analog.com/media/en/simulation-models/spice-models/ad8130.cir
https://www.analog.com/media/en/simulation-models/spice-models/ad8130.cir
https://www.analog.com/en/resources/technical-articles/ltspice-how-to-import-third-party-models.html
https://www.analog.com/en/resources/technical-articles/ltspice-how-to-import-third-party-models.html
https://www.analog.com/en/resources/technical-articles/ltspice-using-an-intrinsic-symbol-for-a-third-party-model.html
https://www.analog.com/en/resources/technical-articles/ltspice-using-an-intrinsic-symbol-for-a-third-party-model.html
https://www.digikey.com/en/products/detail/analog-devices-inc/AD9834BRUZ/621882
https://www.digikey.com/en/products/detail/analog-devices-inc/AD9834BRUZ/621882
https://www.digikey.com/en/products/detail/analog-devices-inc/AD8130ARZ/751140
https://www.digikey.com/en/products/detail/analog-devices-inc/AD8130ARZ/751140
https://www.digikey.com/en/products/detail/analog-devices-inc/AD8014ARZ/620459
https://www.digikey.com/en/products/detail/analog-devices-inc/AD8014ARZ/620459
https://www.digikey.com/en/products/detail/analog-devices-inc/AD8057ARZ/620675
https://www.digikey.com/en/products/detail/analog-devices-inc/AD8057ARZ/620675

39 (https://www.analog.com/media/en/technical-documentation/data-sheets/ad8057_8058.pdf)

40 (https://www.ti.com/lit/ds/symlink/opa695.pdf) | 63 (https://www.ti.com/lit/ds/symlink/opa695.pdf)
41 (https://www.ti.com/lit/gpn/LMH6702) | 64 (https://www.ti.com/lit/gpn/LMH6702)

46 (https://www.ti.com/lit/pdf/snoa474)

48 (https://www.analog.com/media/en/simulation-models/spice-models/ad8130.cir)

50 (https://www.analog.com/en/resources/technical-articles/ltspice-how-to-import-third-party-models.html)

51 (https://www.analog.com/en/resources/technical-articles/ltspice-using-an-intrinsic-symbol-for-a-third-party-model.html)

58 (https://www.digikey.com/en/products/detail/analog-devices-inc/AD9834BRUZ/621882)

59 (https://www.digikey.com/en/products/detail/analog-devices-inc/AD8130ARZ/751140)

61 (https://www.digikey.com/en/products/detail/analog-devices-inc/AD8014ARZ/620459)

62 (https://www.digikey.com/en/products/detail/analog-devices-inc/AD8057ARZ/620675)
