vtmkhoi/Muscular-Atrophy-Measurement-System/hardware/pins-configuration.xlsx

STT | Port-Pin | Mapping | Description | Module
1 | PE11 | AD9833_FSYNC |  | EIM
2 | PE12 | SPI4_SCK |  | EIM
3 | PE14 | SPI4_MOSI |  | EIM
