vtmkhoi/Muscular-Atrophy-Measurement-System/docs/presentation.pdf

TỔNG QUAN ĐỀ TÀI:
THIẾT KẾ VÀ CHẾ TẠO THIẾT BỊ ĐÁNH GIÁ CƠ BẮP ĐA THÔNG SỐ ỨNG DỤNG TRONG ĐO ĐỘ DÀY, ĐỘ XƠ VÀ ĐỘ CỨNG CƠ ĐỂ PHÁT HIỆN SỚM BỆNH LÝ THẦN KINH - CƠ
1. GIỚI THIỆU CHUNG
Bệnh lý về cơ, đặc biệt là các bệnh lý thần kinh-cơ và chứng teo cơ do lão hóa/bất động, đang ngày càng gia tăng, gây ảnh hưởng nghiêm trọng đến chất lượng cuộc sống. Việc chẩn đoán sớm và theo dõi khách quan sự tiến triển của bệnh là vô cùng quan trọng. Các phương pháp lâm sàng hiện tại thường tập trung vào một thông số hoặc có tính xâm lấn/chi phí cao. Đề tài này đề xuất thiết kế và chế tạo một thiết bị đa thông số cầm tay, không xâm lấn, tích hợp bốn công nghệ đo lường cốt lõi để cung cấp một bức tranh toàn diện và định lượng về tình trạng cơ bắp.
2. MỤC TIÊU VÀ PHẠM VI ĐỀ TÀI
* Mục tiêu tổng quát: Chế tạo thành công một thiết bị đo lường đa thông số, có khả năng tích hợp và xử lý dữ liệu từ bốn đầu dò (Siêu âm, NIR, EIM, Indentometer) để đánh giá đồng thời các chỉ số sinh học của cơ.
* Mục tiêu cụ thể:
* Đo lường định lượng: Cung cấp các giá trị chính xác về Độ dày cơ (mm), Độ xơ cơ (trở kháng/phổ NIR) và Độ cứng cơ (N/mm).
* Phát triển thuật toán: Xây dựng mô hình xử lý và tích hợp dữ liệu (ví dụ: Học máy) để phân loại và cảnh báo nguy cơ bệnh lý cơ dựa trên sự kết hợp của các thông số.
* Thẩm định: Kiểm tra tính chính xác và độ tin cậy của thiết bị so với các tiêu chuẩn vàng lâm sàng.
3. CƠ SỞ KỸ THUẬT VÀ NGUYÊN LÝ HOẠT ĐỘNG
Thiết bị được cấu thành từ bốn module cảm biến chính, mỗi module tập trung vào một khía cạnh sinh lý của cơ:
Module cảm biến | Thông số đo | Ý nghĩa sinh học
Siêu âm | Độ dày cơ | Khối lượng cơ và cấu trúc cơ học
Cận hồng ngoại | Phổ hấp thụ ánh sáng | Thành phần cơ mỡ, nồng độ oxi, sức khỏe chuyển hóa
Điện trở kháng cơ | Trở kháng điện môcơ | Độ sơ hóa phụ nề và tính toàn vẹn tế bào

Indentometer | Lực/Độ sâu lún | Độ cứng cơ liên quan đến sơ hóa và trương lực

* Nguyên lý tích hợp: Tất cả các đầu dò sẽ được thiết kế để có thể lấy dữ liệu từ cùng một khu vực cơ bắp một cách nhanh chóng. Dữ liệu thô được truyền về một Bộ xử lý trung tâm (MCU/SBC), nơi các thuật toán lọc nhiễu, chuẩn hóa và tổng hợp sẽ tạo ra một Chỉ số Sức khỏe Cơ bắp Tổng thể (Overall Muscle Health Index).
4. Ý NGHĨA KHOA HỌC VÀ ỨNG DỤNG
Đề tài có ý nghĩa đột phá trong chẩn đoán và theo dõi bệnh cơ, cụ thể:
* Y học Lâm sàng: Cung cấp một công cụ không xâm lấn, di động và chi phí thấp thay thế hoặc bổ sung cho các phương pháp đắt tiền (như MRI, sinh thiết cơ) trong việc sàng lọc và theo dõi.
* Độ dày cơ (Siêu âm): Phục vụ theo dõi teo cơ trong bệnh lý thần kinh-cơ (ví dụ: ALS, Dystrophy).
* Độ xơ cơ (EIM, NIR): Đánh giá định lượng sự tích tụ mô xơ, dấu hiệu của bệnh cơ mãn tính.
* Độ cứng (Indentometer): Cung cấp thông tin về trương lực và tính đàn hồi của cơ, quan trọng trong phục hồi chức năng.
* Khoa học Thể thao & Dinh dưỡng: Giúp vận động viên, người cao tuổi theo dõi hiệu quả tập luyện và tình trạng dinh dưỡng cơ bắp.
* Tiềm năng phát triển: Nền tảng thiết bị này có thể mở rộng để tích hợp thêm các cảm biến khác (ví dụ: nhiệt độ bề mặt, EMG) và kết nối không dây (IoT) để theo dõi sức khỏe cơ từ xa.
5. PHƯƠNG PHÁP THỰC HIỆN
