vtmkhoi/Muscular-Atrophy-Measurement-System/docs/BOM_MAMS.xlsx

Sheet: KhoiVTM
No. | DigiKey Part Number | Manufacturer Product Number | Description | Link DigiKey | Qty | Price per Unit ($) | Total Price ($) | Total Price (VND) | Value | Unit | Tolerance (%) | Package | Category | status | System | Note
1 | AD9834BRUZ-REEL7TR-ND | AD9834BRUZ-REEL7 | IC DDS 50MHZ 10BIT 20TSSOP | https://www.digikey.com/en/products/detail/analog-devices-inc/AD9834BRUZ-REEL7/994992 | 4 | $17.9200 | $71.6800 | 1877299.2 ₫ | NaN | N/A | NaN | 20-TSSOP | IC | Done | EIM |  | Total cost USDT | $823.4228
2 | 505-AD8302ARUZ-ND | AD8302ARUZ | IC RF DETECT 2.7GHZ 14TSSOP | https://www.mouser.vn/ProductDetail/Analog-Devices/AD8302ARUZ-RL7?qs=%2FtpEQrCGXCxf7u2FSUHSPQ%3D%3D | 4 | $34.6400 | $138.5600 | 3628886.4 ₫ | NaN | N/A | NaN | 14-TSSOP | IC | Done | EIM |  | Tocal Cost VND | 21505204.82 ₫
3 | 497-14909-ND | STM32F411RET6 | IC MCU 32BIT 512KB FLASH 64LQFP | https://www.digikey.com/en/products/detail/stmicroelectronics/STM32F411RET6/4935722 | 2 | $6.6900 | $13.3800 | 350422.2 ₫ | NaN | N/A |  | 64-LQFP | uC | Done | EIM |  | Total Cost Taiwan | ¥26044.86158
4 | 505-AD8130ARMZ-REELTR-ND | AD8130ARMZ-REEL | IC OPAMP DIFF 1 CIRCUIT 8MSOP | https://www.digikey.com/en/products/detail/analog-devices-inc/AD8130ARMZ-REEL/994072 | 6 | $5.1800 | $31.0800 | 813985.2 ₫ | NaN | N/A | NaN | 8-TSSOP | IC | Done | EIM
5 | 541-3194-2-ND | TNPW06036K80BEEA | RES 6.8K OHM 0.1% 0.21W 0603 | https://www.digikey.com/en/products/detail/vishay-dale/TNPW06036K80BEEA/1606862 | 25 | $0.2300 | $5.7500 | 150592.5 ₫ | 6.8K | Ohm (Ω) | 0.1% | 0603 | Resistor | Done | EIM
6 | 541-3049-2-ND | TNPW0603200RBEEA | RES 200 OHM 0.1% 0.21W 0603 | https://www.digikey.com/en/products/detail/vishay-dale/TNPW0603200RBEEA/1606685 | 25 | $0.2300 | $5.7500 | 150592.5 ₫ | 200 | Ohm (Ω) | 0.1% | 0603 | Resistor | Done | EIM
7 | 541-3634-2-ND | TNPW0603280RBEEA | RES 280 OHM 0.1% 0.21W 0603 | https://www.digikey.com/en/products/detail/vishay-dale/tnpw0603280rbeea/1606702 | 25 | $0.2300 | $5.7500 | 150592.5 ₫ | 280 | Ohm (Ω) | 0.1% | 0603 | Resistor | Done | EIM
8 | TNPW06031K00BEEA | TNP1.00KAATR-ND | RES 1K OHM 0.1% 0.21W 0603 | https://www.digikey.com/en/products/detail/vishay-dale/TNPW06031K00BEEA/1606767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 | 25 | $0.2300 | $5.7500 | 150592.5 ₫ | 1K | Ohm (Ω) | 0.1% | 0603 | Resistor | Done | EIM
9 | 311-22.0HRTR-ND | RC0603FR-0722RL | RES 22 OHM 1% 1/10W 0603 | https://www.digikey.com/en/products/detail/yageo/RC0603FR-0722RL/727055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 | 25 | $0.1000 | $2.5000 | 65475 ₫ | 22 | Ohm (Ω) | 1% | 0603 | Resistor | Done | EIM
10 | RC0603JR-070RL | RC0603JR-070RL | RES 0 OHM JUMPER 1/10W 0603 | https://www.digikey.com/en/products/detail/yageo/RC0603JR-070RL/726675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 | 25 | $0.1000 | $2.5000 | 65475 ₫ | 0 | Ohm (Ω) | N/A | 0603 | Resistor | Done | EIM
11 | 541-2030-2-ND | TNPW0603499RBEEA | RES 499 OHM 0.1% 0.21W 0603 | https://www.digikey.com/en/products/detail/vishay-dale/tnpw0603499rbeea/1606732 | 25 | $0.2300 | $5.7500 | 150592.5 ₫ | 499 | Ohm (Ω) | 0.1% | 0603 | Resistor | Done | EIM
12 | TNPW06031K78BEEA | 541-TNPW06031K78BEEATR-ND | RES 1.78K OHM 0.1% 0.21W 0603 | https://www.digikey.cn/en/products/detail/vishay-dale/tnpw06031k78beea/1606793 | 25 | $0.2300 | $5.7500 | 150592.5 ₫ | 1.78K | Ohm (Ω) | 0.1% | 0603 | Resistor | Done | EIM
13 | 311-510HRTR-ND | RC0603FR-07510RL | RES 510 OHM 1% 1/10W 0603 | https://www.digikey.com/en/products/detail/yageo/rc0603fr-07510rl/727285 | 25 | $0.1000 | $2.5000 | 65475 ₫ | 510 | Ohm (Ω) | 1% | 0603 | Resistor | Done | EIM
14 | 2266-RC0603FR-072K67LTR-ND | RC0603FR-072K67L | RES 2.67K OHM 1% 0.1W, 1/10W 0603 | https://www.digikey.com/en/products/detail/yageo-america/rc0603fr-072k67l/22283163 | 25 | $0.0020 | $0.0500 | 1309.5 ₫ | 2.67K | Ohm (Ω) | 1% | 0603 | Resistor | Done | EIM
15 | 311-51.0HRTR-ND | RC0603FR-0751RL | RES 51 OHM 1% 1/10W 0603 | https://www.digikey.com/en/products/detail/yageo/rc0603fr-0751rl/727281 | 25 | $0.1000 | $2.5000 | 65475 ₫ | 51 | Ohm (Ω) | 1% | 0603 | Resistor | Done | EIM
16 | 311-10.0KHRTR-ND | RC0603FR-0710KL | RES 10K OHM 1% 1/10W 0603 | https://www.digikey.com/en/products/detail/yageo/rc0603fr-0710kl/726880 | 25 | $0.1000 | $2.5000 | 65475 ₫ | 10K | Ohm (Ω) | 1% | 0603 | Resistor | Done | EIM
17 | TNP10.0AATR-ND | TNPW060310R0BEEA | RES 10 OHM 0.1% 0.21W 0603 | https://www.digikey.com/en/products/detail/vishay-dale/tnpw060310r0beea/1606539 | 25 | $0.3100 | $7.7500 | 202972.5 ₫ | 10 | Ohm (Ω) | 0.1% | 0603 | Resistor | Done | EIM
18 | 490-1410-2-ND | GRM1885C1H200JA01D | CAP CER 20PF 50V C0G/NP0 0603 | https://www.digikey.com/en/products/detail/murata-electronics/GRM1885C1H200JA01D/586920 | 25 | $0.1200 | $3.0000 | 78570 ₫ | 20P | Farad (F) |  | 0603 | Capacitor | Done | EIM
19 | 490-10700-2-ND | GRM155R71H104KE14D | CAP CER 0.1UF 50V X7R 0603 | https://www.digikey.com/en/products/detail/kemet/C0603C104K5RACTU/1465594 | 25 | $0.0800 | $2.0000 | 52380 ₫ | 0.1U | Farad (F) |  | 0603 | Capacitor | Done | EIM
20 | 399-C0603C105K3RACTUTR-ND | C0603C105K3RACTU | CAP CER 1UF 25V X7R 0603 | https://www.digikey.com/en/products/detail/kemet/C0603C105K3RACTU/3317410 | 25 | $0.4100 | $10.2500 | 268447.5 ₫ | 1U | Farad (F) |  | 0603 | Capacitor | Done | EIM
21 | GRM1555C1H1R0WA01J-ND | GRM1555C1H1R0WA01J | CAP CER 1PF 50V C0G/NP0 0402 | https://www.digikey.com/en/products/detail/murata-electronics/grm1555c1h1r0wa01j/4904825 | 25 | $0.0148 | $0.3700 | 9690.3 ₫ | 1P | Farad (F) |  | 0402 | Capacitor | Done | EIM
22 | 311-1873-2-ND | CC0805KKX5R9BB225 | CAP CER 2.2UF 50V X5R 0805 | https://www.digikey.com/en/products/detail/yageo/CC0805KKX5R9BB225/5195775 | 25 | $0.0250 | $0.6250 | 16368.75 ₫ | 2.2U | Farad (F) |  | 0805 | Capacitor | Done | EIM
23 | 490-16772-2-ND | GRM1885C1H181JA01J | CAP CER 180PF 50V C0G/NP0 0603 | https://www.digikey.com/en/products/detail/murata-electronics/grm1885c1h181ja01j/2611094 | 25 | $0.0182 | $0.4555 | 11929.545 ₫ | 180P | Farad (F) |  | 0603 | Capacitor | Done | EIM
24 | 490-1438-2-ND | GRM1885C1H301JA01D | CAP CER 300PF 50V C0G/NP0 0603 | https://www.digikey.com/en/products/detail/murata-electronics/grm1885c1h301ja01d/586964 | 25 | $0.1300 | $3.2500 | 85117.5 ₫ | 300P | Farad (F) |  | 0603 | Capacitor | Done | EIM
25 | 490-16776-2-ND | GRM1885C1H331JA01J | CAP CER 330PF 50V C0G/NP0 0603 | https://www.digikey.com/en/products/detail/murata-electronics/grm1885c1h331ja01j/2611160 | 25 | $0.1100 | $2.7500 | 72022.5 ₫ | 330P | Farad (F) |  | 0603 | Capacitor | Done | EIM
26 | 490-11457-2-ND | GRM1885C1H271JA01J | CAP CER 270PF 50V C0G/NP0 0603 | https://www.digikey.com/en/products/detail/murata-electronics/grm1885c1h271ja01j/2611130 | 25 | $0.0250 | $0.6252 | 16375.2975 ₫ | 270P | Farad (F) |  | 0603 | Capacitor | Done | EIM
27 | 490-1419-2-ND | GRM1885C1H470JA01D | CAP CER 47PF 50V C0G/NP0 0603 | https://www.digikey.com/en/products/detail/murata-electronics/GRM1885C1H470JA01D/586904 | 25 | $0.1200 | $3.0000 | 78570 ₫ | 47P | Farad (F) |  | 0603 | Capacitor | Done | EIM
28 | 490-3285-2-ND | GRM188R72A104KA35D | CAP CER 0.1UF 100V X7R 0603 | https://www.digikey.com/en/products/detail/murata-electronics/GRM188R72A104KA35D/702826 | 25 | $0.1400 | $3.5000 | 91665 ₫ | 0.1U | Farad (F) |  | 0603 | Capacitor | Done | EIM
29 | 490-GRM188R72A103KA01DTR-ND | GRM188R72A103KA01D | CAP CER 10000PF 100V X7R 0603 | https://www.digikey.com/en/products/detail/murata-electronics/GRM188R72A103KA01D/3845635 | 25 | $0.1000 | $2.5000 | 65475 ₫ | 10000P | Farad (F) |  | 0603 | Capacitor | Done | EIM
30 | P49.9HTR-ND | ERJ-3EKF49R9V | RES SMD 49.9 OHM 1% 1/10W 0603 | ERJ-3EKF49R9V Panasonic Electronic Components | Resistors | DigiKey (https://www.digikey.com/en/products/detail/panasonic-electronic-components/ERJ-3EKF49R9V/196378) | 25 | $0.1000 | $2.5000 | 65475 ₫ | 49.9 | Ohm (Ω) | 1% | 0603 | Resistor | Done | EIM
31 | 505-AD8014ARZ-ND | AD8014ARZ | IC OPAMP CFA 1 CIRCUIT 8SOIC | https://www.digikey.com/en/products/detail/analog-devices-inc/ad8014arz/620459 | 4 | $4.5900 | $18.3600 | 480848.4 ₫ | NaN | N/A | NaN | 8SOIC | IC | Done | EIM
32 | 490-1181-1-ND | LQW18ANR27J00D | FIXED IND 270NH 0603 (Murata LQW18, high-Q) | https://www.digikey.com/en/products/detail/murata-electronics/LQW18ANR27J00D/584389 | 25 | $0.1100 | $2.7500 | 72022.5 ₫ | 270n | Henry (H) |  | 0603 | Inductor | Done | EIM
33 | 490-1183-1-ND | LQW18ANR39J00D | FIXED IND 390NH 0603 (Murata LQW18, high-Q) | https://www.digikey.com/en/products/detail/murata-electronics/LQW18ANR39J00D/584391 | 25 | $0.1100 | $2.7500 | 72022.5 ₫ | 390n | Henry (H) |  | 0603 | Inductor | Done | EIM
34 | 490-1184-1-ND | LQW18ANR47J00D | FIXED IND 470NH 0603 (Murata LQW18, high-Q) | https://www.digikey.com/en/products/detail/murata-electronics/LQW18ANR47J00D/584392 | 25 | $0.1100 | $2.7500 | 72022.5 ₫ | 470n | Henry (H) |  | 0603 | Inductor | Done | EIM
35 | 535-11201-1-ND | ASDMB-75.000MHZ-LY-T | MEMS OSC XO 75.0000MHZ LVCMOS (AD9834 MCLK) | https://www.digikey.com/en/products/detail/abracon-llc/ASDMB-75-000MHZ-LY-T/2624314 | 4 | $3.8500 | $15.4000 | 403326 ₫ | 75M | Hertz (Hz) |  | 4-SMD | Ocsillator | Done | EIM
36 | 296-50411-1-ND | TLV75533PDBVR | IC REG LINEAR 3.3V 500MA | https://www.digikey.com/en/products/detail/texas-instruments/TLV75533PDBVR/9356541 | 10 | $0.2500 | $2.5000 | 65475 ₫ | NaN | N/A | NaN | SOT-23-5 | IC-Power | Done | EIM
37 | F3733CT-ND | 1206L050/15YR | PTC RESET FUSE 15V 500MA 1206 (input protection) | https://www.digikey.com/en/products/detail/littelfuse-inc/1206L050-15YR/1211396 | 10 | $0.4260 | $4.2600 | 111569.4 ₫ | NaN | N/A |  | 1206 | FUSE | Done | EIM
38 | 4878-SMF5.0ACT-ND | SMF5.0A | TVS DIODE 5VWM 9.2VC SOD-123F (5V rail surge/ESD) | https://www.digikey.com/en/products/detail/diotec-semiconductor/SMF5-0A/13163545 | 10 | $0.2500 | $2.5000 | 65475 ₫ |  |  |  | SOD-123F | Diode | Done | EIM
40 | 1801-SS24CT-ND | SS24 | DIODE SCHOTTKY 40V 2A DO214AA | https://www.digikey.sg/en/products/detail/taiwan-semiconductor-corporation/SS24/7369395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 | 10 | $0.3460 | $3.4600 | 90617.4 ₫ |  |  |  |  | Diode | Done | EIM
41 | 490-5313-1-ND | GRM32ER71E226KE15L | CAP CER 22UF 25V X7R 1210 | https://www.digikey.sg/en/products/detail/murata-electronics/grm32er71e226ke15l/2039040 | 10 | $1.0000 | $10.0000 | 261900 ₫ | 22U | Farad (F) |  | 1210 | Capacitor | Done | EIM
42 | 490-10700-1-ND | GRM155R71H104KE14D | CAP CER 0.1UF 50V X7R 0402 | https://www.digikey.sg/en/products/detail/murata-electronics/grm155r71h104ke14d/4906220 | 30 | $0.1400 | $4.2000 | 109998 ₫ | 0.1U | Farad (F) |  | 0402 | Capacitor | Done | EIM
43 | 505-ADP5070AREZ-ND | ADP5070AREZ | IC REG BST SEPIC ADJ DL 20TSSOP | https://www.digikey.sg/en/products/detail/analog-devices-inc/ADP5070AREZ/5408965 | 4 | $10.7500 | $43.0000 | 1126170 ₫ |  | N/A | NaN |  | IC-Power | Done | EIM
44 | DFLS240-7DICT-ND | DFLS240-7 | DIODE SCHOTTK 40V 2A POWERDI 123 | https://www.digikey.sg/en/products/detail/diodes-incorporated/DFLS240-7/1934953 | 30 | $0.4760 | $14.2800 | 373993.2 ₫ |  |  |  |  | Diode | Done | EIM
45 | 1712-CPF0603B604KE1CT-ND | CPF0603B604KE1 | RES 604 KOHM 0.1% 1/16W 0603 | https://www.digikey.sg/en/products/detail/te-connectivity-passive-product/CPF0603B604KE1/7493601 | 30 | $0.2400 | $7.2000 | 188568 ₫ | 604 | Ohm (Ω) | 0.1% | 0603 | Resistor | Done | EIM
46 | 311-100KHRCT-ND | RC0603FR-07100KL | RES 100K OHM 1% 1/10W 0603 | https://www.digikey.sg/en/products/detail/vishay-dale/TNPW0603100KBEEN/1610202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 | 30 | $0.1000 | $3.0000 | 78570 ₫ | 100K | Ohm (Ω) | 1% | 0603 | Resistor | Done | EIM
47 | 311-649KHRCT-ND | RC0603FR-07649KL | RES 649K OHM 1% 1/10W 0603 | https://www.digikey.sg/en/products/detail/yageo/rc0603fr-07649kl/727346 | 30 | $0.1000 | $3.0000 | 78570 ₫ | 649K | Ohm (Ω) | 1% | 0603 | Resistor | Done | EIM
48 | 490-3886-1-ND | GRM21BR61C106KE15L | CAP CER 10UF 16V X5R 0805 | https://www.digikey.sg/en/products/detail/murata-electronics/GRM21BR61C106KE15L/965900 | 30 | $0.1200 | $3.6000 | 94284 ₫ | 10U | Farad (F) |  | 0805 | Capacitor | Done | EIM
49 | 311-12.0KHRCT-ND | RC0603FR-0712KL | RES 12K OHM 1% 1/10W 0603 | https://www.digikey.sg/en/products/detail/yageo/rc0603fr-0712kl/726913 | 30 | $0.1000 | $3.0000 | 78570 ₫ | 12K | Ohm (Ω) | 1% | 0603 | Resistor | Done | EIM
50 | 490-5854-1-ND | GCJ188R71H473KA12D | CAP CER 0.047UF 50V X7R 0603 | https://www.digikey.sg/en/products/detail/murata-electronics/GCJ188R71H473KA12D/2785873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 | 30 | $0.1300 | $3.9000 | 102141 ₫ | 0.047U | Farad (F) | 10.00% | 0603 | Capacitor | Done | EIM
51 | 311-15.0KHRCT-ND | RC0603FR-0715KL | RES 15K OHM 1% 1/10W 0603 | https://www.digikey.sg/en/products/detail/yageo/RC0603FR-0715KL/726953 | 30 | $0.1000 | $3.0000 | 78570 ₫ | 15K | Ohm (Ω) | 1% | 0603 | Resistor | Done | EIM
52 | 490-5799-1-ND | GCJ188R71H683KA12D | CAP CER 0.068UF 50V X7R 0603 | https://www.digikey.sg/en/products/detail/murata-electronics/gcj188r71h683ka12d/2783812 | 30 | $0.1500 | $4.5000 | 117855 ₫ | 0.068U | Farad (F) |  | 0603 | Capacitor | Done | EIM
53 | 490-1427-1-ND | GRM1885C1H101JA01D | CAP CER 100PF 50V C0G/NP0 0603 | https://www.digikey.sg/en/products/detail/murata-electronics/grm1885c1h101ja01d/586921 | 30 | $0.0800 | $2.4000 | 62856 ₫ | 100P | Farad (F) |  | 0603 | Capacitor | Done | EIM
54 | 505-ADP7142AUJZ-5.0-R7CT-ND | ADP7142AUJZ-5.0-R7 | IC REG LINEAR 5V 200MA TSOT-23-5 | https://www.digikey.sg/en/products/detail/analog-devices-inc/adp7142aujz-5-0-r7/5056896 | 4 | $4.0500 | $16.2000 | 424278 ₫ | NaN | N/A | NaN |  | IC-Power | Done | EIM
55 | 505-ADP7182AUJZ-5.0-R7CT-ND | ADP7182AUJZ-5.0-R7 | IC REG LINEAR -5V 200MA TSOT-23-5 | https://www.digikey.sg/en/products/detail/analog-devices-inc/adp7182aujz-5-0-r7/4901224 | 4 | $5.0500 | $20.2000 | 529038 ₫ | NaN | N/A | NaN |  | IC-Power | Done | EIM
56 | 296-TPS7A2033PDBVRCT-ND | TPS7A2033PDBVR | IC REG LINEAR 3.3V 300MA SOT23-5 | https://www.digikey.sg/en/products/detail/texas-instruments/tps7a2033pdbvr/13566866 | 10 | $0.3200 | $3.2000 | 83808 ₫ | NaN | N/A | NaN |  | IC-Power | Done | EIM
57 | 296-50411-1-ND | TLV75533PDBVR | IC REG LINEAR 3.3V 500MA SOT23-5 | https://www.digikey.sg/en/products/detail/texas-instruments/tlv75533pdbvr/9356541 | 10 | $0.3600 | $3.6000 | 94284 ₫ | NaN | N/A | NaN |  | IC-Power | Done | EIM
58 | 490-5258-1-ND | BLM18KG601SN1D | FERRITE BEAD 600 OHM 0603 1LN | https://www.digikey.sg/en/products/detail/murata-electronics/blm18kg601sn1d/1982766 | 25 | $0.1000 | $2.5000 | 65475 ₫ | 600 | Ohm (Ω) |  | 0603 | Ferrite bead | Done | EIM
59 | 490-1543-1-ND | GRM188R61A105KA61D | CAP CER 1UF 10V X5R 0603 | https://www.digikey.sg/en/products/detail/murata-electronics/GRM188R61A105KA61D/587071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 | 30 | $0.1100 | $3.3000 | 86427 ₫ | 1U | Farad (F) |  | 0603 | Capacitor | Done | EIM
60 | 541-2.61KHCT-ND | CRCW06032K61FKEA | RES SMD 2.61K OHM 1% 1/8W 0603 | https://www.digikey.com/en/products/detail/vishay-dale/CRCW06032K61FKEA/1174713 | 25 | $0.1000 | $2.5000 | 65475 ₫ | 2.61K | Ohm (Ω) | 1% | 0603 | Resistor | Done | EIM
61 | 399-C0402C151K5RACTUCT-ND | C0402C151K5RACTU | CAP CER 150PF 50V X7R 0402 | https://www.digikey.com/en/products/detail/kemet/C0402C151K5RACTU/1933627 | 25 | $0.3400 | $8.5000 | 222615 ₫ | 150P | Farad (F) |  | 0402 | Capacitor | Done | EIM
62 | 1276-1070-1-ND | CL10C330JB8NNNC | CAP CER 33PF 50V C0G/NP0 0603 | https://www.digikey.com/en/products/detail/samsung-electro-mechanics/CL10C330JB8NNNC/3886728 | 25 | $0.1000 | $2.5000 | 65475 ₫ | 33P | Farad (F) |  | 0603 | Capacitor | Done | EIM
63 | 738-RNCF0603TKY49R9CT-ND | RNCF0603TKY49R9 | RES 49.9 OHM 0.01% 1/10W 0603 | https://www.digikey.com/en/products/detail/stackpole-electronics-inc/RNCF0603TKY49R9/4072345 | 12 | $1.1760 | $14.1120 | 369593.28 ₫ | 49.9 | Ohm (Ω) | 0.01% | 0603 | Resistor | Ordering | EIM
64 | RNCF0603TKY1K00CT-ND | RNCF0603TKY1K00 | RES SMD 1K OHM 0.01% 1/10W 0603 | https://www.digikey.com/en/products/detail/stackpole-electronics-inc/RNCF0603TKY1K00/2269697 | 10 | $1.1760 | $11.7600 | 307994.4 ₫ | 1K | Ohm (Ω) | 0.01% | 0603 | Resistor | Ordering | EIM
65 | 738-RNCF0603TKY499RCT-ND | RNCF0603TKY499R | RES SMD 499 OHM 0.01% 1/10W 0603 | https://www.digikey.com/en/products/detail/stackpole-electronics-inc/RNCF0603TKY499R/4072346 | 10 | $1.1760 | $11.7600 | 307994.4 ₫ | 499 | Ohm (Ω) | 0.01% | 0603 | Resistor | Ordering | EIM
66 | RG20N51WCT-ND | RG2012N-510-W-T1 | RES SMD 51 OHM 0.05% 1/8W 0805 | https://www.digikey.com/en/products/detail/susumu/RG2012N-510-W-T1/600657 | 10 | $0.4816 | $4.8160 | 126131.04 ₫ | 51 | Ohm (Ω) | 0.05% | 0805 | Resistor | Ordering | EIM
67 | P100KBECT-ND | ERA-3ARW104V | RES SMD 100K OHM 0.05% 1/10W 0603 | https://www.digikey.com/en/products/detail/panasonic-industry/ERA-3ARW104V/3073685 | 10 | $0.3412 | $3.4120 | 89360.28 ₫ | 100K | Ohm (Ω) | 0.05% | 0603 | Resistor | Ordering | EIM
68 | 408-RG1608N-103-W-T5CT-ND | RG1608N-103-W-T5 | RES SMD 10K OHM 0.05% 1/10W 0603 | https://www.digikey.com/en/products/detail/susumu/RG1608N-103-W-T5/1257543 | 20 | $0.4208 | $8.4160 | 220415.04 ₫ | 10K | Ohm (Ω) | 0.05% | 0603 | Resistor | Ordering | EIM
69 | RG16N47WCT-ND | RG1608N-470-W-T1 | RES SMD 47 OHM 0.05% 1/10W 0603 | https://www.digikey.com/en/products/detail/susumu/RG1608N-470-W-T1/600565 | 10 | $0.4404 | $4.4040 | 115340.76 ₫ | 47 | Ohm (Ω) | 0.05% | 0603 | Resistor | Ordering | EIM
70 | RNCF0603AKT10R0CT-ND | RNCF0603AKT10R0 | RES SMD 10 OHM 0.05% 1/10W 0603 | https://www.digikey.com/en/products/detail/stackpole-electronics-inc/RNCF0603AKT10R0/4928378 | 15 | $0.6500 | $9.7500 | 255352.5 ₫ | 10 | Ohm (Ω) | 0.05% | 0603 | Resistor | Ordering | EIM
71 | 490-16342-1-ND | GRM1885C1H1R0WA01D | CAP CER 1PF 50V C0G/NP0 0603 | https://www.digikey.com/en/products/detail/murata-electronics/GRM1885C1H1R0WA01D/7363086 | 25 | $0.1090 | $2.7250 | 71367.75 ₫ | 1P | Farad (F) | 5.00% | 0603 | Capacitor | Ordering | EIM
72 | 505-AD8066ARZ-R7CT-ND | AD8066ARZ-R7 | IC VOLTAGE FEEDBACK 2 CIRC 8SOIC | https://www.digikey.com/en/products/detail/analog-devices-inc/AD8066ARZ-R7/654014 | 4 | $8.0100 | $32.0400 | 839127.6 ₫ | NaN | N/A | NaN | 8SOIC | IC | Ordering | EIM
73 | 505-ADP2303ARDZ-5.0-R7CT-ND | ADP2303ARDZ-5.0-R7 | IC REG BUCK 5V 3A 8SOIC | https://www.digikey.com/en/products/detail/analog-devices-inc/ADP2303ARDZ-5-0-R7/2606549 | 3 | $4.1900 | $12.5700 | 329208.3 ₫ | NaN | N/A | NaN |  | IC-Power | Ordering | EIM
74 | 505-ADP7118AUJZ-3.3-R7CT-ND | ADP7118AUJZ-3.3-R7 | IC REG LIN 3.3V 200MA TSOT-23-5 | https://www.digikey.com/en/products/detail/analog-devices-inc/ADP7118AUJZ-3-3-R7/5056890 | 3 | $2.9400 | $8.8200 | 230995.8 ₫ | NaN | N/A | NaN |  | IC-Power | Ordering | EIM
75 | 478-KGM15ACG1H102FTCT-ND | KGM15ACG1H102FT | CAP CER 1000PF 50V C0G/NP0 0603 | https://www.digikey.com/en/products/detail/kemet/c0402c102k5ractu/411034 | 10 | $0.0260 | $0.2600 | 6809.4 ₫ | 1000P | Farad (F) | 1.00% | 0603 | Capacitor | Ordering | EIM
76 | 2019-RN73R1JTTD22R0B25CT-ND | RN73R1JTTD22R0B25 | RES 22 OHM 0.1% 1/10W 0603 | https://www.digikey.com/en/products/detail/koa-speer-electronics-inc/RN73R1JTTD22R0B25/10013029 | 10 | $0.0700 | $0.7000 | 18333 ₫ | 22 | Ohm (Ω) | 0.1% | 0603 | Resistor | Ordering | EIM
77 | 490-GCM1885C2A561FA16DCT-ND | GCM1885C2A561FA16D | CAP CER 560PF 100V C0G/NP0 0603 | https://www.digikey.com/en/products/detail/murata-electronics/GCM1885C2A561FA16D/11618566 | 25 | $0.0820 | $2.0500 | 53689.5 ₫ | 560P | Farad (F) | 1.00% | 0603 | Capacitor | Ordering | EIM | Replace 720p
78 | 399-14491-1-ND | C0603C161F5GACTU | CAP CER 160PF 50V C0G/NP0 0603 | https://www.digikey.com/en/products/detail/kemet/C0603C161F5GACTU/2200035 | 20 | $0.7130 | $14.2600 | 373469.4 ₫ | 160P | Farad (F) | 1.00% | 0603 | Capacitor | Ordering | EIM
79 | 311-3897-1-ND | CC0603FRNPO9BN390 | CAP CER 39PF 50V C0G/NPO 0603 | https://www.digikey.sg/en/products/detail/yageo/CC0603FRNPO9BN390/5883506 | 10 | $0.1180 | $1.1800 | 30904.2 ₫ | 39P | Farad (F) | 1.00% | 0603 | Capacitor | Ordering | EIM
80 | 399-C0603C681F5GACTUCT-ND | C0603C681F5GACTU | CAP CER 680PF 50V C0G/NP0 0603 | https://www.digikey.com/en/products/detail/kemet/C0603C681F5GACTU/2201080 | 10 | $0.5920 | $5.9200 | 155044.8 ₫ | 680P | Farad (F) | 1.00% | 0603 | Capacitor | Ordering | EIM
81 | 445-MLF1608A1R0JT000CT-ND | MLF1608A1R0JT000 | FIXED IND 1UH 50MA 500 MOHM SMD | https://www.digikey.com/en/products/detail/tdk/MLF1608A1R0JT000/612989 | 10 | $0.1150 | $1.1500 | 30118.5 ₫ | 1u | Henry (H) | 5.00% | 0603 | Inductor | Ordering | EIM
82 | 445-175367-1-ND | MLF1608A1R5JT000 | FIXED IND 1.5UH 50MA 700 MOHM | https://www.digikey.com/en/products/detail/tdk/MLF1608A1R5JT000/612991 | 10 | $0.1150 | $1.1500 | 30118.5 ₫ | 1.5u | Henry (H) | 5.00% | 0603 | Inductor | Ordering | EIM
83 | 445-MLF1608A1R8JT000CT-ND | MLF1608A1R8JT000 | FIXED IND 1.8UH 50MA 850 MOHM | https://www.digikey.com/en/products/detail/tdk/MLF1608A1R8JT000/612992 | 10 | $0.1150 | $1.1500 | 30118.5 ₫ | 1.8u | Henry (H) | 5.00% | 0603 | Inductor | Ordering | EIM
84 | 13-CC0603FRNPO9BN201CT-ND | CC0603FRNPO9BN201 | CAP CER 200PF 50V C0G/NPO 0603 | https://www.digikey.com/en/products/detail/yageo/CC0603FRNPO9BN201/11490449 | 10 | $0.1360 | $1.3600 | 35618.4 ₫ | 200P | Farad (F) | 1.00% | 0603 | Capacitor | Ordering | EIM
85 | 399-C0603C391F5GACTUCT-ND | C0603C391F5GACTU | CAP CER 390PF 50V C0G/NP0 0603 | https://www.digikey.com/en/products/detail/kemet/C0603C391F5GACTU/2200659 | 5 | $1.1400 | $5.7000 | 149283 ₫ | 390P | Farad (F) | 1.00% | 0603 | Capacitor | Ordering | EIM | Replace 400pF
86 | 1276-1069-1-ND | CL10C100CB8NNNC | CAP CER 10PF 50V C0G/NP0 0603 | https://www.digikey.com/en/products/detail/samsung-electro-mechanics/CL10C100CB8NNNC/3886727 | 50 | $0.0192 | $0.9600 | 25142.4 ₫ | 10P | Farad (F) | 0.25% | 0603 | Capacitor | Ordering | EIM
87 | 490-8120-1-ND | GQM1875C2E120GB12D | CAP CER 12PF 250V C0G/NP0 0603 | https://www.digikey.com/en/products/detail/murata-electronics/GQM1875C2E120GB12D/2593381 | 10 | $0.23 | $2.30 | 60,237 ₫ | 12P | Farad (F) | 2.00% | 603 | Capacitor | Ordering | EIM | Replace 132pF
88 | 399-C0603C121F5GACTUCT-ND | C0603C121F5GACTU | CAP CER 120PF 50V C0G/NP0 0603 | https://www.digikey.com/en/products/detail/kemet/c0603c121f5gactu/2199842 | 10 | $1.0100 | $10.1000 | 264519 ₫ | 120P | Farad (F) | 1.00% | 0603 | Capacitor | Ordering | EIM
89 | 311-3906-1-ND | CC0603FRNPO9BN820 | CAP CER 82PF 50V C0G/NPO 0603 | https://www.digikey.com/en/products/detail/yageo/CC0603FRNPO9BN820/5883518 | 10 | $0.0860 | $0.8600 | 22523.4 ₫ | 82P | Farad (F) | 1.00% | 0603 | Capacitor | Ordering | EIM
90 | 478-KGM15ACG1H221FTCT-ND | KGM15ACG1H221FT | CAP CER 220PF 50V C0G/NP0 0603 | https://www.digikey.sg/en/products/detail/kyocera-avx/KGM15ACG1H221FT/1116245 | 10 | $0.3220 | $3.2200 | 84331.8 ₫ | 220P | Farad (F) | 1.00% | 0603 | Capacitor | Ordering | EIM
91 | 399-C0805C473J3GACTUCT-ND | C0805C473J3GACTU | CAP CER 0.047UF 25V C0G/NP0 0805 | https://www.digikey.com/en/products/detail/kemet/C0805C473J3GACTU/2212853 | 10 | $0.7700 | $7.7000 | 201663 ₫ | 0.047U | Farad (F) | 1.00% | 0805 | Capacitor | Ordering | EIM
92 | RNCF0603TKY100RCT-ND | RNCF0603TKY100R | RES SMD 100 OHM 0.01% 1/10W 0603 | https://www.digikey.com/en/products/detail/stackpole-electronics-inc/RNCF0603TKY100R/2269696 | 10 | $1.3340 | $13.3400 | 349374.6 ₫ | 100 | Ohm (Ω) | 0.01% | 0603 | Resistor | Ordering | EIM
93 | 712-QSCP251Q1R0A1GV001TCT-ND | QSCP251Q1R0A1GV001T | CAP CER 1PF 250V NP0 0603 | https://www.digikey.com/en/products/detail/johanson-technology-inc/QSCP251Q1R0A1GV001T/1919340 | 25 | $0.2220 | $5.5500 | 145354.5 ₫ | 1P | Farad (F) | 0.05% | 0603 | Capacitor | Ordering | EIM
94 | 490-GRT1885C1E103FA02DCT-ND | GRT1885C1E103FA02D | CAP CER 10000PF 25V C0G/NP0 0603 | https://www.digikey.com/en/products/detail/murata-electronics/GRT1885C1E103FA02D/16033576 | 10 | $0.1270 | $1.2700 | 33261.3 ₫ | 10000P | Farad (F) | 1% | 0603 | Capacitor | Ordering | EIM | 0.01uF
95 | P2.0KBECT-ND | ERA-3ARW202V | RES SMD 2K OHM 0.05% 1/10W 0603 | https://www.digikey.com/en/products/detail/panasonic-industry/ERA-3ARW202V/3073698 | 10 | $0.3892 | $3.8920 | 101931.48 ₫ | 2K | Ohm (Ω) | 0.05% | 0603 | Resistor | Ordering | EIM
96 | 10-ERA-3AEB52R3VCT-ND | ERA-3AEB52R3V | RES SMD 52.3 OHM 0.1% 1/10W 0603 | https://www.digikey.sg/en/products/detail/panasonic-industry/ERA-3AEB52R3V/2026633 | 25 | $0.0888 | $2.2200 | 58141.8 ₫ | 52.3 | Ohm (Ω) | 0.1% | 0603 | Resistor | Ordering | EIM
97 | 490-GCM31C5C1H104FA16LCT-ND | GCM31C5C1H104FA16L | CAP CER 0.1UF 50V C0G/NP0 1206 | https://www.digikey.com/en/products/detail/murata-electronics/GCM31C5C1H104FA16L/11618865 | 10 | $0.6700 | $6.7000 | 175473 ₫ | 0.1U | Farad (F) | 1% | 1206 | Capacitor | Ordering | EIM | C44, C54, C4, C1, C9
98 | RMCF0805FT60K4CT-ND | RMCF0805FT60K4 | RES 60.4K OHM 1% 1/8W 0805 | https://www.digikey.com/en/products/detail/texas-instruments/TLV75533PDBVR/9356541 | 10 | $0.2580 | $2.5800 | 67570.2 ₫ | 60.4K | Ohm (Ω) | 1% | 0805 | Resistor | Ordering | EIM
99 | 311-24.3KCRCT-ND | RC0805FR-0724K3L | RES 24.3K OHM 1% 1/8W 0805 | https://www.digikey.sg/en/products/detail/yageo/RC0805FR-0724K3L/727758 | 25 | $0.0440 | $1.1000 | 28809 ₫ | 24.3K | Ohm (Ω) | 1% | 0805 | Resistor | Ordering | EIM
100 | RMCF0805FT150KCT-ND | RMCF0805FT150K | RES 150K OHM 1% 1/8W 0805 | https://www.digikey.sg/en/products/detail/stackpole-electronics-inc/RMCF0805FT150K/1760472 | 25 | $0.0370 | $0.9250 | 24225.75 ₫ | 150K | Ohm (Ω) | 1% | 0805 | Resistor | Ordering | EIM
101 | 1276-1040-1-ND | CL10A225KO8NNNC | CAP CER 2.2UF 16V X5R 0603 | https://www.digikey.sg/en/products/detail/samsung-electro-mechanics/CL10A225KO8NNNC/3886698 | 20 | $0.0660 | $1.3200 | 34570.8 ₫ | 2.2U | Farad (F) | 10% | 0603 | Capacitor | Ordering | EIM
102 | 490-3886-1-ND | GRM21BR61C106KE15L | CAP CER 10UF 16V X5R 0805 | https://www.digikey.sg/en/products/detail/murata-electronics/GRM21BR61C106KE15L/965900 | 15 | $0.1200 | $1.8000 | 47142 ₫ | 10U | Farad (F) |  | 0805 | Capacitor | Ordering | EIM
103 | 399-C0603C223K5RACTUCT-ND | 399-C0603C223K5RACTUCT-ND | CAP CER 0.022UF 50V X7R 0603 | https://www.digikey.com/en/products/detail/kemet/C0603C223K5RACTU/416043 | 15 | $0.0470 | $0.7050 | 18463.95 ₫ | 0.022U | Farad (F) |  | 0603 | Capacitor | Ordering | EIM
104 | 490-6508-1-ND | GRM31CR60J476KE19L | CAP CER 47UF 6.3V X5R 1206 | https://www.digikey.sg/en/products/detail/murata-electronics/GRM31CR60J476KE19L/2548176 | 10 | $0.2940 | $2.9400 | 76998.6 ₫ | 47U | Farad (F) | 20% | 1206 | Capacitor | Ordering | EIM
105 | SMBJ12A-E3/52GICT-ND | SMBJ12A-E3/52 | TVS DIODE 12VWM 19.9VC DO214AA | https://www.digikey.com/en/products/detail/vishay-general-semiconductor-diodes-division/smbj12a-e3-52/1091513 | 4 | $0.5000 | $2.0000 | 52380 ₫ | NaN | N/A | NaN | DO-214AA | Diode | Ordering | EIM
106 | SMBJ8.5ALFCT-ND | SMBJ8.5A | TVS DIODE 8.5VWM 14.4V DO214AA | https://www.digikey.com/en/products/detail/littelfuse-inc/smbj8-5a/688268 | 4 | $0.4900 | $1.9600 | 51332.4 ₫ | NaN | N/A | NaN | DO-214AA | Diode | Ordering | EIM
107 | SK54A-LTPMSCT-ND | SK54A-LTP | DIODE SCHOTTKY 40V 5A DO214AC | https://www.digikey.com/en/products/detail/mcc-micro-commercial-components/SK54A-LTP/5114132 | 4 | $0.5700 | $2.2800 | 59713.2 ₫ | NaN | N/A | NaN | DO-214AC | Diode | Ordering | EIM
108 | SK34A-LTPMSCT-ND | SK34A-LTP | DIODE SCHOTTKY 40V 3A DO214AC | https://www.digikey.com/en/products/detail/mcc-micro-commercial-components/SK34A-LTP/2642021 | 4 | $0.4300 | $1.7200 | 45046.8 ₫ | NaN | N/A | NaN | DO-214AC | Diode | Ordering | EIM
109 | SRR1260-4R7YCT-ND | SRR1260-4R7Y | FIXED IND 4.7UH 6.8A 15.5 MOHM | https://www.digikey.com/en/products/detail/bourns-inc/SRR1260-4R7Y/2352901 | 4 | $1.0500 | $4.2000 | 109998 ₫ | NaN | N/A | NaN | SMD | Inductor | Ordering | EIM
110 | 490-18407-1-ND | DFE322520FD-4R7M=P2 | FIXED IND 4.7UH 2A 98 MOHM SMD | https://www.digikey.com/en/products/detail/murata-electronics/DFE322520FD-4R7M-P2/10135198 | 4 | $0.7400 | $2.9600 | 77522.4 ₫ | NaN | N/A | NaN | 1210 | Inductor | Ordering | EIM
111 | 587-3462-1-ND | NRS5030T6R8MMGJ | FIXED IND 6.8UH 2.3A 52 MOHM SMD | https://www.digikey.com/en/products/detail/taiyo-yuden/NRS5030T6R8MMGJ/4157850 | 10 | $0.2040 | $2.0400 | 53427.6 ₫ | NaN | N/A | NaN |  | Inductor | Ordering | EIM
112 | AD8130ARMZ-REEL7CT-ND | AD8130ARMZ-REEL7 | IC OPAMP DIFF 1 CIRCUIT 8MSOP | https://www.digikey.com/en/products/detail/analog-devices-inc/AD8130ARMZ-REEL7/996145 | 2 | $5.3400 | $10.6800 | 279709.2 ₫ | NaN | N/A | NaN | 8MSOP | IC | Ordering | EIM

Sheet: EIM_Tracker
No. (1st sheet) | MPN | Description | Value | Package | Qty Ordered | Qty Required | Qty Used | Remaining (= Ordered − Used) | Category | Status | Remarks / Notes | Validate with order | Validate with schematic
1 | AD9834BRUZ-REEL7 | IC DDS 50MHZ 10BIT 20TSSOP | — | 20-TSSOP | 4 | 1 | 0 | 4 | Other | Done |  | Partial
2 | AD8302ARUZ | IC RF DETECT 2.7GHZ 14TSSOP | — | 14-TSSOP | 4 | 1 | 0 | 4 | Other | Done |  | Partial
3 | STM32F411RET6 | IC MCU 32BIT 512KB FLASH 64LQFP | — | 64-LQFP | 2 | 0 | 0 | 2 | Other | Done |  | Partial
4 | AD8130ARMZ-REEL | IC OPAMP DIFF 1 CIRCUIT 8MSOP | — | 8-TSSOP | 6 | 4 | 0 | 6 | Other | Ordering |  | Partial
5 | TNPW06036K80BEEA | RES 6.8K OHM 0.1% 0.21W 0603 | 6.8K | 0603 | 25 | 1 | 0 | 25 | Resistor | Done |  | Match
6 | TNPW0603200RBEEA | RES 200 OHM 0.1% 0.21W 0603 | 200 | 0603 | 25 | 2 | 0 | 25 | Resistor | Done |  | Match
7 | TNPW0603280RBEEA | RES 280 OHM 0.1% 0.21W 0603 | 280 | 0603 | 25 | 0 | 0 | 25 | Resistor | Done |  | Match
8 | TNP1.00KAATR-ND | RES 1K OHM 0.1% 0.21W 0603 | 1K | 0603 | 25 | 2 | 0 | 25 | Resistor | Done |  | Match
9 | RC0603FR-0722RL | RES 22 OHM 1% 1/10W 0603 | 22 | 0603 | 25 | 3 | 0 | 25 | Resistor | Done |  | Match
10 | RC0603JR-070RL | RES 0 OHM JUMPER 1/10W 0603 | 0 | 0603 | 25 | 6 | 0 | 25 | Resistor | Done |  | Match
11 | TNPW0603499RBEEA | RES 499 OHM 0.1% 0.21W 0603 | 499 | 0603 | 25 | 6 | 0 | 25 | Resistor | Done |  | Match
12 | 541-TNPW06031K78BEEATR-ND | RES 1.78K OHM 0.1% 0.21W 0603 | 1.78K | 0603 | 25 | 0 | 0 | 25 | Resistor | Done |  | Match
13 | RC0603FR-07510RL | RES 510 OHM 1% 1/10W 0603 | 510 | 0603 | 25 | 0 | 0 | 25 | Resistor | Done |  | Match
14 | RC0603FR-072K67L | RES 2.67K OHM 1% 0.1W, 1/10W 0603 | 2.67K | 0603 | 25 | 0 | 0 | 25 | Resistor | Done |  | Match
15 | RC0603FR-0751RL | RES 51 OHM 1% 1/10W 0603 | 51 | 0603 | 25 | 0 | 0 | 25 | Resistor | Done |  | Match
16 | RC0603FR-0710KL | RES 10K OHM 1% 1/10W 0603 | 10K | 0603 | 25 | 8 | 0 | 25 | Resistor | Done |  | Match
17 | TNPW060310R0BEEA | RES 10 OHM 0.1% 0.21W 0603 | 10 | 0603 | 25 | 0 | 0 | 25 | Resistor | Done |  | Match
18 | GRM1885C1H200JA01D | CAP CER 20PF 50V C0G/NP0 0603 | 20P | 0603 | 25 | 2 | 0 | 25 | Capacitor | Done |  | Match
19 | GRM155R71H104KE14D | CAP CER 0.1UF 50V X7R 0603 | 0.1U | 0603 | 25 | 27 | 0 | 25 | Capacitor | Done |  | Match
20 | C0603C105K3RACTU | CAP CER 1UF 25V X7R 0603 | 1U | 0603 | 25 | 0 | 0 | 25 | Capacitor | Done |  | Match
21 | GRM1555C1H1R0WA01J | CAP CER 1PF 50V C0G/NP0 0402 | 1P | 0402 | 25 | 0 | 0 | 25 | Capacitor | Done |  | Match
22 | CC0805KKX5R9BB225 | CAP CER 2.2UF 50V X5R 0805 | 2.2U | 0805 | 25 | 0 | 0 | 25 | Capacitor | Done |  | Match
23 | GRM1885C1H181JA01J | CAP CER 180PF 50V C0G/NP0 0603 | 180P | 0603 | 25 | 0 | 0 | 25 | Capacitor | Done |  | Match
24 | GRM1885C1H301JA01D | CAP CER 300PF 50V C0G/NP0 0603 | 300P | 0603 | 25 | 0 | 0 | 25 | Capacitor | Done |  | Match
25 | GRM1885C1H331JA01J | CAP CER 330PF 50V C0G/NP0 0603 | 330P | 0603 | 25 | 0 | 0 | 25 | Capacitor | Done |  | Match
26 | GRM1885C1H271JA01J | CAP CER 270PF 50V C0G/NP0 0603 | 270P | 0603 | 25 | 0 | 0 | 25 | Capacitor | Done |  | Match
27 | GRM1885C1H470JA01D | CAP CER 47PF 50V C0G/NP0 0603 | 47P | 0603 | 25 | 0 | 0 | 25 | Capacitor | Done |  | Match
28 | GRM188R72A104KA35D | CAP CER 0.1UF 100V X7R 0603 | 0.1U | 0603 | 25 | 27 | 0 | 25 | Capacitor | Done |  | Match
29 | GRM188R72A103KA01D | CAP CER 10000PF 100V X7R 0603 | 10000P | 0603 | 25 | 3 | 0 | 25 | Capacitor | Done |  | Match
30 | ERJ-3EKF49R9V | RES SMD 49.9 OHM 1% 1/10W 0603 | 49.9 | 0603 | 25 | 4 | 0 | 25 | Resistor | Done |  | Match
31 | AD8014ARZ | IC OPAMP CFA 1 CIRCUIT 8SOIC | — | 8SOIC | 4 | 1 | 0 | 4 | Other | Done |  | Partial
32 | LQW18ANR27J00D | FIXED IND 270NH 0603 (Murata LQW18, high-Q) | 270n | 0603 | 25 | 0 | 0 | 25 | Other | Done |  | Match
33 | LQW18ANR39J00D | FIXED IND 390NH 0603 (Murata LQW18, high-Q) | 390n | 603 | 25 | 0 | 0 | 25 | Other | Done |  | Match
34 | LQW18ANR47J00D | FIXED IND 470NH 0603 (Murata LQW18, high-Q) | 470n | 603 | 25 | 0 | 0 | 25 | Other | Done |  | Match
35 | ASDMB-75.000MHZ-LY-T | MEMS OSC XO 75.0000MHZ LVCMOS (AD9834 MCLK) | 75M | 4-SMD | 4 | 1 | 0 | 4 | Other | Done |  | Match
36 | TLV75533PDBVR | IC REG LINEAR 3.3V 500MA | — | SOT-23-5 | 10 | 0 | 0 | 10 | Other | Done |  | Partial
37 | 1206L050/15YR | PTC RESET FUSE 15V 500MA 1206 (input protection) | — | 1206 | 10 | 0 | 0 | 10 | Other | Done |  | Partial
38 | SMF5.0A | TVS DIODE 5VWM 9.2VC SOD-123F (5V rail surge/ESD) | — | SOD-123F | 10 | 0 | 0 | 10 | Other | Done |  | Partial
#REF! | #REF! | #REF! | — | — | #REF! | 0 | 0 | #REF! | #REF! | Removed |  | Not Found
40 | SS24 | DIODE SCHOTTKY 40V 2A DO214AA | — | — | 10 | 0 | 0 | 10 | Other | Done |  | Mismatch
41 | GRM32ER71E226KE15L | CAP CER 22UF 25V X7R 1210 | 22U | 1210 | 10 | 0 | 0 | 10 | Capacitor | Done |  | Match
42 | GRM155R71H104KE14D | CAP CER 0.1UF 50V X7R 0402 | 0.1U | 0402 | 30 | 0 | 0 | 30 | Capacitor | Done |  | Mismatch
43 | ADP5070AREZ | IC REG BST SEPIC ADJ DL 20TSSOP | — | — | 4 | 0 | 0 | 4 | Other | Done |  | Mismatch
44 | DFLS240-7 | DIODE SCHOTTK 40V 2A POWERDI 123 | — | — | 30 | 0 | 0 | 30 | Other | Done |  | Mismatch
45 | CPF0603B604KE1 | RES 604 KOHM 0.1% 1/16W 0603 | 604 | 0603 | 30 | 0 | 0 | 30 | Resistor | Done |  | Match
46 | RC0603FR-07100KL | RES 100K OHM 1% 1/10W 0603 | 100K | 0603 | 30 | 0 | 0 | 30 | Resistor | Done |  | Match
47 | RC0603FR-07649KL | RES 649K OHM 1% 1/10W 0603 | 649K | 0603 | 30 | 0 | 0 | 30 | Resistor | Done |  | Match
48 | GRM21BR61C106KE15L | CAP CER 10UF 16V X5R 0805 | 10U | 0805 | 30 | 19 | 0 | 30 | Capacitor | Done |  | Match
49 | RC0603FR-0712KL | RES 12K OHM 1% 1/10W 0603 | 12K | 0603 | 30 | 0 | 0 | 30 | Resistor | Done |  | Match
50 | GCJ188R71H473KA12D | CAP CER 0.047UF 50V X7R 0603 | 0.047U | 0603 | 30 | 0 | 0 | 30 | Capacitor | Done |  | Match
51 | RC0603FR-0715KL | RES 15K OHM 1% 1/10W 0603 | 15K | 0603 | 30 | 0 | 0 | 30 | Resistor | Done |  | Match
52 | GCJ188R71H683KA12D | CAP CER 0.068UF 50V X7R 0603 | 0.068U | 0603 | 30 | 0 | 0 | 30 | Capacitor | Done |  | Match
53 | GRM1885C1H101JA01D | CAP CER 100PF 50V C0G/NP0 0603 | 100P | 0603 | 30 | 1 | 0 | 30 | Capacitor | Done |  | Match
54 | ADP7142AUJZ-5.0-R7 | IC REG LINEAR 5V 200MA TSOT-23-5 | — | — | 4 | 0 | 0 | 4 | Other | Done |  | Mismatch
55 | ADP7182AUJZ-5.0-R7 | IC REG LINEAR -5V 200MA TSOT-23-5 | — | — | 4 | 0 | 0 | 4 | Other | Done |  | Mismatch
56 | TPS7A2033PDBVR | IC REG LINEAR 3.3V 300MA SOT23-5 | — | — | 10 | 0 | 0 | 10 | Other | Done |  | Mismatch
57 | TLV75533PDBVR | IC REG LINEAR 3.3V 500MA SOT23-5 | — | — | 10 | 0 | 0 | 10 | Other | Done |  | Mismatch
58 | BLM18KG601SN1D | FERRITE BEAD 600 OHM 0603 1LN | 600 | 603 | 25 | 0 | 0 | 25 | Other | Done |  | Match
59 | GRM188R61A105KA61D | CAP CER 1UF 10V X5R 0603 | 1U | 0603 | 30 | 0 | 0 | 30 | Capacitor | Done |  | Match
60 | CRCW06032K61FKEA | RES SMD 2.61K OHM 1% 1/8W 0603 | 2.61K | 0603 | 25 | 0 | 0 | 25 | Resistor | Done |  | Match
61 | C0402C151K5RACTU | CAP CER 150PF 50V X7R 0402 | 150P | 0402 | 25 | 0 | 0 | 25 | Capacitor | Done |  | Match
62 | CL10C330JB8NNNC | CAP CER 33PF 50V C0G/NP0 0603 | 33P | 0603 | 25 | 0 | 0 | 25 | Capacitor | Done |  | Match
63 | RNCF0603TKY49R9 | RES 49.9 OHM 0.01% 1/10W 0603 | 49.9 | 0603 | 12 | 4 | 0 | 12 | Resistor | Ordering |  | Match
64 | RNCF0603TKY1K00 | RES SMD 1K OHM 0.01% 1/10W 0603 | 1K | 0603 | 10 | 2 | 0 | 10 | Resistor | Ordering |  | Match
65 | RNCF0603TKY499R | RES SMD 499 OHM 0.01% 1/10W 0603 | 499 | 0603 | 10 | 6 | 0 | 10 | Resistor | Ordering |  | Match
66 | RG2012N-510-W-T1 | RES SMD 51 OHM 0.05% 1/8W 0805 | 51 | 0805 | 10 | 3 | 0 | 10 | Resistor | Ordering |  | Match
67 | ERA-3ARW104V | RES SMD 100K OHM 0.05% 1/10W 0603 | 100K | 0603 | 10 | 0 | 0 | 10 | Resistor | Ordering |  | Match
68 | RG1608N-103-W-T5 | RES SMD 10K OHM 0.05% 1/10W 0603 | 10K | 0603 | 20 | 8 | 0 | 20 | Resistor | Ordering |  | Match
69 | RG1608N-470-W-T1 | RES SMD 47 OHM 0.05% 1/10W 0603 | 47 | 0603 | 10 | 1 | 0 | 10 | Resistor | Ordering |  | Match
70 | RNCF0603AKT10R0 | RES SMD 10 OHM 0.05% 1/10W 0603 | 10 | 0603 | 15 | 0 | 0 | 15 | Resistor | Ordering |  | Match
71 | GRM1885C1H1R0WA01D | CAP CER 1PF 50V C0G/NP0 0603 | 1P | 0603 | 25 | 0 | 0 | 25 | Capacitor | Ordering |  | Match
72 | AD8066ARZ-R7 | IC VOLTAGE FEEDBACK 2 CIRC 8SOIC | — | — | 4 | 3 | 0 | 4 | Other | Ordering |  | Mismatch
73 | ADP2303ARDZ-5.0-R7 | IC REG BUCK 5V 3A 8SOIC | — | — | 3 | 0 | 0 | 3 | Other | Ordering |  | Mismatch
74 | ADP7118AUJZ-3.3-R7 | IC REG LIN 3.3V 200MA TSOT-23-5 | — | — | 3 | 0 | 0 | 3 | Other | Ordering |  | Mismatch
75 | KGM15ACG1H102FT | CAP CER 1000PF 50V C0G/NP0 0603 | 1000P | 0603 | 10 | 3 | 0 | 10 | Capacitor | Ordering |  | Match
76 | RN73R1JTTD22R0B25 | RES 22 OHM 0.1% 1/10W 0603 | 22 | 0603 | 10 | 3 | 0 | 10 | Resistor | Ordering |  | Match
77 | GCM1885C2A561FA16D | CAP CER 560PF 100V C0G/NP0 0603 | 560P | 0603 | 25 | 0 | 0 | 25 | Capacitor | Ordering | Replace 720p | Match
78 | C0603C161F5GACTU | CAP CER 160PF 50V C0G/NP0 0603 | 160P | 0603 | 20 | 0 | 0 | 20 | Capacitor | Ordering |  | Match
79 | CC0603FRNPO9BN390 | CAP CER 39PF 50V C0G/NPO 0603 | 39P | 0603 | 10 | 1 | 0 | 10 | Capacitor | Ordering |  | Match
80 | C0603C681F5GACTU | CAP CER 680PF 50V C0G/NP0 0603 | 680P | 0603 | 10 | 2 | 0 | 10 | Capacitor | Ordering |  | Match
81 | MLF1608A1R0JT000 | FIXED IND 1UH 50MA 500 MOHM SMD | 1u | 603 | 10 | 1 | 0 | 10 | Other | Ordering |  | Match
82 | MLF1608A1R5JT000 | FIXED IND 1.5UH 50MA 700 MOHM | 1.5u | 603 | 10 | 1 | 0 | 10 | Other | Ordering |  | Match
83 | MLF1608A1R8JT000 | FIXED IND 1.8UH 50MA 850 MOHM | 1.8u | 603 | 10 | 1 | 0 | 10 | Other | Ordering |  | Match
84 | CC0603FRNPO9BN201 | CAP CER 200PF 50V C0G/NPO 0603 | 200P | 0603 | 10 | 1 | 0 | 10 | Capacitor | Ordering |  | Match
85 | C0603C391F5GACTU | CAP CER 390PF 50V C0G/NP0 0603 | 390P | 0603 | 5 | 1 | 0 | 5 | Capacitor | Ordering | Replace 400pF | Match
86 | CL10C100CB8NNNC | CAP CER 10PF 50V C0G/NP0 0603 | 10P | 0603 | 50 | 1 | 0 | 50 | Capacitor | Ordering |  | Match
87 | GQM1875C2E120GB12D | CAP CER 12PF 250V C0G/NP0 0603 | 12P | 0603 | 10 | 1 | 0 | 10 | Capacitor | Ordering | Replace 132pF | Match
88 | C0603C121F5GACTU | CAP CER 120PF 50V C0G/NP0 0603 | 120P | 0603 | 10 | 1 | 0 | 10 | Capacitor | Ordering |  | Match
89 | CC0603FRNPO9BN820 | CAP CER 82PF 50V C0G/NPO 0603 | 82P | 0603 | 10 | 1 | 0 | 10 | Capacitor | Ordering |  | Match
90 | KGM15ACG1H221FT | CAP CER 220PF 50V C0G/NP0 0603 | 220P | 0603 | 10 | 1 | 0 | 10 | Capacitor | Ordering |  | Match
91 | C0805C473J3GACTU | CAP CER 0.047UF 25V C0G/NP0 0805 | 0.047U | 0805 | 10 | 1 | 0 | 10 | Capacitor | Ordering |  | Match
92 | RNCF0603TKY100R | RES SMD 100 OHM 0.01% 1/10W 0603 | 100 | 0603 | 10 | 2 | 0 | 10 | Resistor | Ordering |  | Match
93 | QSCP251Q1R0A1GV001T | CAP CER 1PF 250V NP0 0603 | 1P | 0603 | 25 | 0 | 0 | 25 | Capacitor | Ordering |  | Match
94 | GRT1885C1E103FA02D | CAP CER 10000PF 25V C0G/NP0 0603 | 10000P | 0603 | 10 | 3 | 0 | 10 | Capacitor | Ordering | 0.01uF | Match
95 | ERA-3ARW202V | RES SMD 2K OHM 0.05% 1/10W 0603 | 2K | 0603 | 10 | 1 | 0 | 10 | Resistor | Ordering |  | Match
96 | ERA-3AEB52R3V | RES SMD 52.3 OHM 0.1% 1/10W 0603 | 52.3 | 0603 | 25 | 2 | 0 | 25 | Resistor | Ordering |  | Match
97 | GCM31C5C1H104FA16L | CAP CER 0.1UF 50V C0G/NP0 1206 | 0.1U | 1206 | 10 | 5 | 0 | 10 | Capacitor | Ordering |  | Match
98 | RMCF0805FT60K4 | RES 60.4K OHM 1% 1/8W 0805 |  |  | 10 |  | 0 | 10 | Resistor | Ordering |  | Mismatch
99 | RC0805FR-0724K3L | RES 24.3K OHM 1% 1/8W 0805 |  |  | 25 |  | 0 | 25 | Resistor | Ordering |  | Mismatch
100 | RMCF0805FT150K | RES 150K OHM 1% 1/8W 0805 |  |  | 25 |  | 0 | 25 | Resistor | Ordering |  | Mismatch
101 | CL10A225KO8NNNC | CAP CER 2.2UF 16V X5R 0603 |  |  | 20 |  | 0 | 20 | Capacitor | Ordering |  | Mismatch
102 | GRM21BR61C106KE15L | CAP CER 10UF 16V X5R 0805 |  |  | 15 |  | 0 | 15 | Capacitor | Ordering |  | Mismatch
103 | 399-C0603C223K5RACTUCT-ND | CAP CER 0.022UF 50V X7R 0603 |  |  | 15 |  | 0 | 15 | Capacitor | Ordering |  | Mismatch
104 | GRM31CR60J476KE19L | CAP CER 47UF 6.3V X5R 1206 |  |  | 10 |  | 0 | 10 | Capacitor | Ordering |  | Mismatch
105 | SMBJ12A-E3/52 | TVS DIODE 12VWM 19.9VC DO214AA |  |  | 4 |  | 0 | 4 | Other | Ordering |  | Mismatch
106 | SMBJ8.5A | TVS DIODE 8.5VWM 14.4V DO214AA |  |  | 4 |  | 0 | 4 | Other | Ordering |  | Mismatch
107 | SK54A-LTP | DIODE SCHOTTKY 40V 5A DO214AC |  |  | 4 |  | 0 | 4 | Other | Ordering |  | Mismatch

Sheet: Kicad_Extract
Reference | Value | Size | Qty | Description | DNP
C5,C8,C12,C13,C15,C17,C34,C36,C38,C39,C41,C43,C47,C48,C51,C52,C58,C59,C61,C68,C69,C70 | 0.1u | 0603 | 27 | Unpolarized capacitor, small symbol
C44, C54, C4, C1, C9 | 0.1u | 1206 | 5 | Unpolarized capacitor, small symbol
C2,C33 | 20p | 0603 | 2 | Unpolarized capacitor, small symbol | DNP
C3,C6,C7,C11,C14,C16,C18,C35,C37,C40,C42,C45,C46,C49,C50,C53,C55,C57,C62 | 10u | 0805 | 19 | Unpolarized capacitor, small symbol
C10,C66,C67 | 0.01u | 0603 | 3 | Unpolarized capacitor, small symbol
C19,C21 | 680p | 0603 | 2 | Unpolarized capacitor
C20 | 39p | 0603 | 1 | Unpolarized capacitor
C22,C26,C31 | 1n | 0603 | 3 | Unpolarized capacitor
C23 | 200p | 0603 | 1 | Unpolarized capacitor
C24 | 390p | 0603 | 1 | Unpolarized capacitor
C25 | 10p | 0603 | 1 | Unpolarized capacitor
C27 | 220p | 0603 | 1 | Unpolarized capacitor
C28 | 100p | 0603 | 1 | Unpolarized capacitor
C29 | 12p | 0603 | 1 | Unpolarized capacitor
C30 | 120p | 0603 | 1 | Unpolarized capacitor
C32 | 82p | 0603 | 1 | Unpolarized capacitor
C56 | 0.047u | 0805 | 1 | Unpolarized capacitor, small symbol | DNP
H1,H2,H3,H4 | M3 |  | 4
J1 | ADC |  | 1 | Generic connector, single row, 01x02, script generated (kicad-library-utils/schlib/autogen/connector/)
J2 | CURRENT_PUMP_2 |  | 1 | coaxial connector (BNC, SMA, SMB, SMC, Cinch/RCA, LEMO, ...)
J3 | VOLTAGE_MEASUREMENT_1 |  | 1 | coaxial connector (BNC, SMA, SMB, SMC, Cinch/RCA, LEMO, ...)
J4 | VOLTAGE_MEASUREMENT_2 |  | 1 | coaxial connector (BNC, SMA, SMB, SMC, Cinch/RCA, LEMO, ...)
J5 | PROG |  | 1 | Generic connector, double row, 02x04, odd/even pin numbering scheme (row 1 odd numbers, row 2 even numbers), script generated (kicad-library-utils/schlib/autogen/connector/)
J6 | Dual power supply |  | 1 | Generic connector, single row, 01x03, script generated
J7 | Single power supply |  | 1 | Generic connector, single row, 01x02, script generated
J8 | CURRENT_PUMP_1 |  | 1 | coaxial connector (BNC, SMA, SMB, SMC, Cinch/RCA, LEMO, ...)
L1 | 1.0uH | 0603 | 1 | Inductor
L2 | 1.5uH | 0603 | 1 | Inductor
L3 | 1.8uH | 0603 | 1 | Inductor
R1,R2 | 200 | 0603 | 2 | Resistor
R3,R8,R13,R24,R25,R26 | 499 | 0603 | 6 | Resistor | DNP
R4,R17,R19,R23,R29,R35 | 0 | 0603 | 6 | Resistor | DNP
R5,R6,R16,R21,R28,R31,R33,R34 | 10K | 0603 | 8 | Resistor
R7 | 6.8K | 0603 | 1 | Resistor
R9,R11,R36,R37 | 49.9 | 0603 | 4 | Resistor
R10,R12,R18 | 22 | 0603 | 3 | Resistor | DNP
R14,R15,R27 | 51 | 0805 | 3 | Resistor
R20,R22 | 1 | 0603 | 2 | Resistor | DNP
R30 | 47 | 0603 | 1 | Resistor | DNP
R32,R44 | 100 | 0603 | 2 | Resistor
R38,R39 | 52.3 | 0603 | 2 | Resistor
R40 | 2K | 0603 | 1 | Resistor
TP1 | TP_REFOUT |  | 1 | test point
TP2 | TP_IOUT |  | 1 | test point
TP3 | TP_IOUTB |  | 1 | test point
TP4 | TP_RESET |  | 1 | test point
TP5 | TP_SDATA |  | 1 | test point
TP6 | TP_SCLK |  | 1 | test point
TP7 | TP_FSYNC |  | 1 | test point
TP8 | TP_MCLK |  | 1 | test point
TP9,TP19,TP20,TP28,TP30,TP31 | TP_GND |  | 6 | test point
TP10 | TP_DIF_SIN |  | 1 | test point
TP11 | +3.3V_TP |  | 1 | test point
TP12 | +5V_TP |  | 1 | test point
TP13 | -5V_TP |  | 1 | test point
TP14,TP15 | GND_TP |  | 2 | test point
TP16,TP21,TP22 | VOUT_FILTERED |  | 3 | test point
TP17,TP23,TP26 | VOUT_BUFFER |  | 3 | test point
TP18,TP24,TP27 | VIN_DiffToSingle |  | 3 | test point
TP25 | GND |  | 1 | test point
U1 | AD9834BRUZ |  | 1
U2,U4,U6,U8 | AD8130ARZ |  | 4
U3 | AD8014ARZ |  | 1
U5,U7,U10 | AD8066ARZ-R7 |  | 3
U9 | AD8302ARUZ |  | 1
Y2 | 75MHz | 2.5x2.0mm | 1 | HCMOS Crystal Clock Oscillator, 2.5x2.0 mm SMD

Sheet: BienNH
No. | DigiKey Part Number | Manufacturer Product Number | Description | Link DigiKey | Quant. | Price per Unit ($) | Total Price ($) | Total Price (VND) | Value | Unit | Tolerance (%) | Package | Category | status | System | Note
1 | 475-SFH4253-RCT-ND | SFH 4253-R | TOPLED |  | 12 | 0.506 | 6.07 | 158973.3 ₫ |  |  |  |  |  | Ordering |  | Biên
2 | 732-150283FS73103CT-ND | 150283FS73103 | LED IR 730NM 3528 |  | 12 | 1.148 | 13.78 | 360898.2 ₫ |  |  |  |  |  | Ordering |  | Biên
3 | 535-9542-1-ND | ABS07-32.768KHZ-T | CRYSTAL 32.7680KHZ 12.5PF SMD |  | 6 | 0.61 | 3.66 | 95855.4 ₫ |  |  |  |  |  | Ordering |  | Biên
4 | 535-10630-1-ND | ABM3-8.000MHZ-D2Y-T | CRYSTAL 8.0000MHZ 18PF SMD |  | 6 | 0.67 | 4.02 | 105283.8 ₫ |  |  |  |  |  | Ordering |  | Biên
5 | 296-14273-1-ND | CD4052BPWR | IC SWITCH SP4TX2 240OHM 16TSSOP |  | 6 | 0.46 | 2.76 | 72284.4 ₫ |  |  |  |  |  | Ordering |  | Biên
6 | 296-11993-1-ND | CD4051BPWR | IC MUX 8:1 240OHM 16TSSOP |  | 6 | 0.46 | 2.76 | 72284.4 ₫ |  |  |  |  |  | Ordering |  | Biên
7 | 296-19547-1-ND | OPA333AIDCKR | IC OPAMP ZERO-DRIFT 1CIRC SC70-5 |  | 15 | 1.2624 | 37.87 | 991815.3 ₫ |  |  |  |  |  | Ordering |  | Biên
8 | 296-16859-5-ND | OPA380AID | IC TRANSIMPEDANCE 1 CIRC 8SOIC |  | 15 | 4.768 | 71.52 | 1873108.8 ₫ |  |  |  |  |  | Ordering |  | Biên
9 | 5399-AMS1117-3.3SOT-223CT-ND | AMS1117-3.3 SOT-223 | IC REG LINEAR 3.3V 1A SOT-223 |  | 10 | 0.054 | 0.54 | 14142.6 ₫ |  |  |  |  |  | Ordering |  | Biên
10 | 1276-2867-1-ND | CL10A226KQ8NRNE | CAP CER 22UF 6.3V X5R 0603 |  | 20 | 0.276 | 5.52 | 144568.8 ₫ |  |  |  |  |  | Ordering |  | Biên
11 | CR0603-FX-1002ELFCT-ND | CR0603-FX-1002ELF | RES SMD 10K OHM 1% 1/10W 0603 |  | 50 | 0.016 | 0.8 | 20952 ₫ |  |  |  |  |  | Ordering |  | Biên
12 | 13-RC0603FR-0733RLCT-ND | RC0603FR-0733RL | RES 33 OHM 1% 1/10W 0603 |  | 50 | 0.0138 | 0.69 | 18071.1 ₫ |  |  |  |  |  | Ordering |  | Biên
13 | RMCF0603FT10R0CT-ND | RMCF0603FT10R0 | RES 10 OHM 1% 1/10W 0603 |  | 50 | 0.012 | 0.6 | 15714 ₫ |  |  |  |  |  | Ordering |  | Biên
14 | RMCF0603FT4K70CT-ND | RMCF0603FT4K70 | RES 4.7K OHM 1% 1/10W 0603 |  | 50 | 0.012 | 0.6 | 15714 ₫ |  |  |  |  |  | Ordering |  | Biên
15 | RMCF0603FT1K00CT-ND | RMCF0603FT1K00 | RES 1K OHM 1% 1/10W 0603 |  | 50 | 0.012 | 0.6 | 15714 ₫ |  |  |  |  |  | Ordering |  | Biên
16 | 311-10.0KHRCT-ND | RC0603FR-0710KL | RES 10K OHM 1% 1/10W 0603 |  | 50 | 0.0138 | 0.69 | 18071.1 ₫ |  |  |  |  |  | Ordering |  | Biên
17 | 13-RC0603FR-0733RLCT-ND | RC0603FR-0733RL | RES 33 OHM 1% 1/10W 0603 |  | 50 | 0.0138 | 0.69 | 18071.1 ₫ |  |  |  |  |  | Ordering |  | Biên
18 | 13-CC0603FRNPO9BN200CT-ND | CC0603FRNPO9BN200 | CAP CER 20PF 50V C0G/NPO 0603 |  | 50 | 0.0778 | 3.89 | 101879.1 ₫ |  |  |  |  |  | Ordering |  | Biên
19 | 1276-1033-1-ND | CL10B104JB8NNNC | CAP CER 0.1UF 50V X7R 0603 |  | 50 | 0.0234 | 1.17 | 30642.3 ₫ |  |  |  |  |  | Ordering |  | Biên
20 | 490-3886-1-ND | GRM21BR61C106KE15L | CAP CER 10UF 16V X5R 0805 |  | 50 | 0.047 | 2.35 | 61546.5 ₫ |  |  |  |  |  | Ordering |  | Biên
21 | 311-3485-1-ND | CC0603JRX7R7BB105 | CAP CER 1UF 16V X7R 0603 |  | 50 | 0.0866 | 4.33 | 113402.7 ₫ |  |  |  |  |  | Ordering |  | Biên
22 | 13-PA0603FRP070R001LCT-ND | PA0603FRP070R001L | RES 0.001 OHM 1% 1/10W 0603 |  | 30 | 0.482 | 14.46 | 378707.4 ₫ |  |  |  |  |  | Ordering |  | Biên
23 | 1276-2867-1-ND | CL10A226KQ8NRNE | CAP CER 22UF 6.3V X5R 0603 |  | 20 | 0.276 | 5.52 | 144568.8 ₫ |  |  |  |  |  | Ordering |  | Biên
24 | 5407-ESP32-S3-WROOM-1-N8R2CT-ND | ESP32-S3-WROOM-1-N8R2 | SMD MODULE, ESP32-S3R2 WITH 2 MB |  | 5 | 5.88 | 17.64 | 461991.6 ₫ |  |  |  |  |  | Ordering |  | Biên
 |  |  |  |  |  | total (USD) | 202.53

Sheet: NgaDTL
No. | DigiKey Part Number | Manufacturer Product Number | Description | Link DigiKey | Quant. | Price per Unit ($) | Total Price ($) | Total Price (VND) | Value | Unit | Tolerance (%) | Package | Category | status | System | Note
1 | 505-LT8300IS5#TRMPBFCT-ND | LT8300IS5#TRMPBF | IC REG FLYBACK 260MA TSOT23-5 | https://www.digikey.tw/zh/products/detail/analog-devices-inc/lt8300is5-trmpbf/3676957 | 3 | 10.39 | $31.1700 | 816342.3 ₫ | NaN | N/A | NaN | TSOT23-5 | IC | Ordering
2 | TYS6045220M-10 | TYS6045220M-10 | FIXED IND 22UH 1.8A 89 MOHM SMD | https://www.digikey.tw/en/products/detail/laird-signal-integrity-products/TYS6045220M-10/4733498 | 10 | 0.43 | $4.3000 | 112617 ₫ | 22u | H | ±20% |  | Fixed Inductors | OOS
3 | 1727-PMEG100T10ELRXTR-ND | PMEG100T10ELRX | DIODE SCHOTTKY 100V 1A SOD123W | https://www.digikey.tw/en/products/detail/nexperia-usa-inc/PMEG100T10ELRX/15777950 | 10 | 0.46 | $4.6000 | 120474 ₫ | NaN | N/A | NaN | DO-214AC, SMA | Diode |  |  | SMA ??
4 | 2019-RK73G2ATTD1004FCT-ND | RK73G2ATTD1004F | 1 MOhms ±1% 0.125W, 1/8W Chip Resistor 0805 | https://www.digikey.tw/zh/products/detail/koa-speer-electronics-inc/RK73G2ATTD1004F/13576138 | 10 | 0.22 | $2.2000 | 57618 ₫ | 1M | Ohm | 1% | 0805 | Resistor | Ordering
5 | P20.5KDBCT-ND | ERA-3AEB2052V | RES SMD 20.5KOHM 0.1% 1/10W 0603 | https://www.digikey.tw/zh/products/detail/panasonic-industry/ERA-3AEB2052V/2026864 | 10 | 0.1 | $1.0000 | 26190 ₫ | 20.5k | Ohm | 0.1% | 0603 | Resistor
6 | TMK212AB7475KG-T | TMK212AB7475KG-T | CAP CER 4.7UF 25V X7R 0805 | https://www.digikey.tw/en/products/detail/taiyo-yuden/TMK212AB7475KG-T/2714168 | 10 | 0.1403 | $1.4030 | 36744.57 ₫ | 4.7u | F | ±10% | 0805 | Ceramic Capacitors
7 | 1276-1184-2-ND | CL10B105KA8NNNC | CAP CER 1UF 25V X7R 0603 | https://www.digikey.tw/en/products/detail/samsung-electro-mechanics/CL10B105KA8NNNC/3886842 | 10 | 0.1 | $1.0000 | 26190 ₫ | 1u | F | ±10% | 0603 | Ceramic Capacitors
8 | 478-KAM32LR72A475KUTR-ND | 12101C475K4T2A | CAP CER 4.7UF 100V X7R 1210 | https://www.digikey.tw/en/products/detail/kyocera-avx/12101C475K4T2A/9374708 | 10 | 0.59 | $5.9000 | 154521 ₫ | 4.7u | F | ±10% | 1210 | Ceramic Capacitors
9 | 1763-1206B104J101N-ND | 1206B104J101N | MLCC 1206 100V 100NF X7R | https://www.digikey.tw/en/products/detail/knowles-novacap/1206B104J101N/22208472 | 10 | 1.37 | $13.7000 | 358803 ₫ | 100n | F | ±5% | 1206 | Ceramic Capacitors
10 | 296-30203-2-ND | C0603C104K3RACTU | IC REG LIN POS ADJ 100MA 8HVSSOP | https://www.digikey.tw/en/products/detail/texas-instruments/TPS7A1601DGNR/2811171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 | 10 | 2.86 | $28.6000 | 749034 ₫
11 | RT0603BRD072K32L | RT0603BRD072K32L | RES SMD 2.32KOHM 0.1% 1/10W 0603 | https://www.digikey.tw/en/products/detail/yageo/RT0603BRD072K32L/1072431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 | 10 | 0.07 | $0.7000 | 18333 ₫ | 2.32 | Ohm | 0.1% | 0603 | Resistor
12 | RT0603BRD071KL | RT0603BRD071KL | RES SMD 1K OHM 0.1% 1/10W 0603 | https://www.digikey.tw/en/products/detail/yageo/RT0603BRD071KL/1072344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 | 10 | 0.07 | $0.7000 | 18333 ₫ | 1K | Ohm | 0.1% | 0603 | Resistor
13 | 1276-1184-2-ND | CL10B105KA8NNNC | CAP CER 1UF 25V X7R 0603 | https://www.digikey.tw/en/products/detail/samsung-electro-mechanics/CL10B105KA8NNNC/3886842 | 10 | 0.04 | $0.4000 | 10476 ₫ | 1u | F |  | 0603 | Ceramic Capacitors
14 | 490-GRM21BZ71E106KE15LTR-ND | GRM21BZ71E106KE15L | CAP CER 10UF 25V X7R 0805 | https://www.digikey.tw/en/products/detail/murata-electronics/GRM21BZ71E106KE15L/13904911 | 10 | 0.2 | $2.0000 | 52380 ₫ | 10u | F |  | 0805 | Ceramic Capacitors
15 | AMS1117-3.3 | AMS1117-3.3 | IC REG LINEAR 3.3V 1A SOT-223-3L | https://www.digikey.tw/en/products/detail/evvo/AMS1117-3-3/22482148 | 10 | 0.3 | $3.0000 | 78570 ₫
16 | GRM21BZ71A226ME15L | GRM21BZ71A226ME15L | CAP CER 22UF 10V X7R 0805 | https://www.digikey.tw/en/products/detail/murata-electronics/GRM21BZ71A226ME15L/13904953 | 10 | 0.2 | $2.0000 | 52380 ₫ | 22u | F |  | 0805 | Ceramic Capacitors
17 | LT6375AHMS#PBF | LT6375AHMS#PBF | Precision diff amp (Howland core) | https://www.digikey.tw/en/products/detail/analog-devices-inc/LT6375AHMS-PBF/5825341 | 3 | 15.25 | $45.7500 | 1198192.5 ₫
18 | LTC6090CS8E-5#PBF | LTC6090CS8E-5#PBF | High-voltage op-amp 140V | https://www.digikey.tw/en/products/detail/analog-devices-inc/LTC6090CS8E-5-PBF/4864140 | 3 | 10.7 | $32.1000 | 840699 ₫
19 | ERA-3AEB4990V | ERA-3AEB4990V | Resistor 499R 0.1% 0603 | https://www.digikey.tw/en/products/detail/panasonic-industry/ERA-3AEB4990V/2026721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 | 10 | 0.1 | $1.0000 | 26190 ₫ | 499 | Ohm | 0.1% | 0805 | Resistor
20 | GRM1885C1H103JA01D | GRM1885C1H103JA01D | Cap 10nF 50V C0G 0603 | https://www.digikey.tw/en/products/detail/murata-electronics/GRM1885C1H103JA01D/4421555 | 10 | 0.07 | $0.7000 | 18333 ₫ | 10n | F |  | 0805 | Ceramic Capacitors
21 | GRM1885C1H100JA01D | GRM1885C1H100JA01D | Cap 10pF 50V C0G 0603 | https://www.digikey.tw/en/products/detail/murata-electronics/GRM1885C1H100JA01D/586930 | 10 | 0.07 | $0.7000 | 18333 ₫ | 10p | F |  | 0805 | Ceramic Capacitors
22 | HIP4081AIBZ | HIP4081AIBZ | Full-bridge gate driver 80V | https://www.digikey.tw/en/products/detail/renesas-electronics-corporation/HIP4081AIBZ/821444 | 5 | 8.14 | $40.7000 | 1065933 ₫
23 | DMN6040SSD-13 | DMN6040SSD-13 | MOSFET 2N-CH 60V 5A 8SO | https://www.digikey.tw/en/products/detail/diodes-incorporated/DMN6040SSD-13/3481129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 | 10 | 1 | $10.0000 | 261900 ₫
24 | GRM188R71E104KA01D | C0603C104K3RACTU | CAP CER 0.1UF 25V X7R 0603 | https://www.digikey.tw/en/products/detail/kemet/C0603C104K3RACTU/416044 | 10 | 0.1 | $1.0000 | 26190 ₫ | 0.1u | F |  | 0603 | Ceramic Capacitors
25 | ERA-3AEB104V | ERA-3AEB104V | Resistor 100k 0.5% 0603 | https://www.digikey.tw/en/products/detail/panasonic-industry/ERA-3AEB104V/1465902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 | 10 | 0.1 | $1.0000 | 26190 ₫ | 100k | Ohm | 0.5% | 0603 | Resistor
26 | ERA-3AEB103V | ERA-3AEB103V | Resistor 10k 0.5% 0603 | https://www.digikey.tw/en/products/detail/panasonic-industry/ERA-3AEB103V/1465878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 | 10 | 0.1 | $1.0000 | 26190 ₫ | 10k | Ohm | 0.5% | 0603 | Resistor
27 | ESP32-WROOM-32E-N4 | ESP32-WROOM-32E-N4 | ESP32 module (has internal DAC) | https://www.digikey.tw/en/products/detail/espressif-systems/ESP32-WROOM-32E-N4/11613125 | 3 | 5 | $15.0000 | 392850 ₫
28 | ERA-3AEB472V | ERA-3AEB472V | RES SMD 4.7K OHM 0.1% 1/10W 0603 | https://www.digikey.tw/en/products/detail/panasonic-industry/ERA-3AEB472V/1465870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 | 10 | 0.1 | $1.0000 | 26190 ₫ | 4.7k | Ohm | 0.1% | 0603 | Resistor
29 | ERFSM050162RZ | ERFSM050162RZ | PTC polyfuse 500mA hold | https://www.digikey.tw/en/products/detail/excel-cell-electronic-co-ltd/ERFSM050162RZ/25813160 | 5 | 0.2 | $1.0000 | 26190 ₫
30 | SMAJ15CA | SMAJ15CA | TVS bidirectional 15V | https://www.digikey.tw/en/products/detail/littelfuse-inc/SMAJ15CA/762277 | 10 | 0.46 | $4.6000 | 120474 ₫
31 | ERJ-8ENF1001V | ERJ-8ENF1001V | Resistor 1k 1% 1/4W 1206 | https://www.digikey.tw/en/products/detail/panasonic-industry/ERJ-8ENF1001V/86206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 | 10 | 0.2 | $2.0000 | 52380 ₫ | 1k | Ohm | 1% | 1206 | Resistor
32 | RMCF0603FT27K4 | RMCF0603FT27K4 | RES 27.4K OHM 1% 1/10W 0603 | https://www.digikey.tw/en/products/detail/stackpole-electronics-inc/RMCF0603FT27K4/1760994 | 10 | 0.46 | $4.6000 | 120474 ₫ | 27.4k | Ohm | 0.1% | 0603 | Resistor
33 | ERA-3AEB101V | ERA-3AEB101V | RES SMD 100 OHM 0.1% 1/10W 0603 | https://www.digikey.tw/en/products/detail/panasonic-industry/ERA-3AEB101V/1465830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 | 10 | 0.1 | $1.0000 | 26190 ₫ | 100 | Ohm | 0.1% | 0603 | Resistor

Sheet: Order
No. | DigiKey Part Number | Manufacturer Product Number | Description | Link DigiKey | Qty | Price per Unit ($) | Total Price ($) | Total Price (VND) | Value | Unit | Tolerance (%) | Package | Category | status | System |  |  |  | Manufacturer Product Number
1 | 738-RNCF0603TKY49R9CT-ND | RNCF0603TKY49R9 | RES 49.9 OHM 0.01% 1/10W 0603 | https://www.digikey.com/en/products/detail/stackpole-electronics-inc/RNCF0603TKY49R9/4072345 | 12 | $1.1760 | $14.1120 | 369593.28 ₫ | 49.9 | Ohm (Ω) | 0.01% | 0603 | Resistor | Ordering | Khôi |  | Total cost USDT | $709.3870 | RNCF0603TKY49R9
2 | RNCF0603TKY1K00CT-ND | RNCF0603TKY1K00 | RES SMD 1K OHM 0.01% 1/10W 0603 | https://www.digikey.com/en/products/detail/stackpole-electronics-inc/RNCF0603TKY1K00/2269697 | 10 | $1.1760 | $11.7600 | 307994.4 ₫ | 1K | Ohm (Ω) | 0.01% | 0603 | Resistor | Ordering | Khôi |  | Tocal Cost VND | 18578845.53 ₫ | RNCF0603TKY1K00
3 | 738-RNCF0603TKY499RCT-ND | RNCF0603TKY499R | RES SMD 499 OHM 0.01% 1/10W 0603 | https://www.digikey.com/en/products/detail/stackpole-electronics-inc/RNCF0603TKY499R/4072346 | 10 | $1.1760 | $11.7600 | 307994.4 ₫ | 499 | Ohm (Ω) | 0.01% | 0603 | Resistor | Ordering | Khôi |  | Total Cost Taiwan | ¥22437.91081 | RNCF0603TKY499R
4 | RG20N51WCT-ND | RG2012N-510-W-T1 | RES SMD 51 OHM 0.05% 1/8W 0805 | https://www.digikey.com/en/products/detail/susumu/RG2012N-510-W-T1/600657 | 10 | $0.4816 | $4.8160 | 126131.04 ₫ | 51 | Ohm (Ω) | 0.05% | 0805 | Resistor | Ordering | Khôi |  |  |  | RG2012N-510-W-T1
5 | P100KBECT-ND | ERA-3ARW104V | RES SMD 100K OHM 0.05% 1/10W 0603 | https://www.digikey.com/en/products/detail/panasonic-industry/ERA-3ARW104V/3073685 | 10 | $0.3412 | $3.4120 | 89360.28 ₫ | 100K | Ohm (Ω) | 0.05% | 0603 | Resistor | Ordering | Khôi |  |  |  | ERA-3ARW104V
6 | 408-RG1608N-103-W-T5CT-ND | RG1608N-103-W-T5 | RES SMD 10K OHM 0.05% 1/10W 0603 | https://www.digikey.com/en/products/detail/susumu/RG1608N-103-W-T5/1257543 | 20 | $0.4208 | $8.4160 | 220415.04 ₫ | 10K | Ohm (Ω) | 0.05% | 0603 | Resistor | Ordering | Khôi |  |  |  | RG1608N-103-W-T5
7 | RG16N47WCT-ND | RG1608N-470-W-T1 | RES SMD 47 OHM 0.05% 1/10W 0603 | https://www.digikey.com/en/products/detail/susumu/RG1608N-470-W-T1/600565 | 10 | $0.4404 | $4.4040 | 115340.76 ₫ | 47 | Ohm (Ω) | 0.05% | 0603 | Resistor | Ordering | Khôi |  |  |  | RG1608N-470-W-T1
8 | RNCF0603AKT10R0CT-ND | RNCF0603AKT10R0 | RES SMD 10 OHM 0.05% 1/10W 0603 | https://www.digikey.com/en/products/detail/stackpole-electronics-inc/RNCF0603AKT10R0/4928378 | 15 | $0.6500 | $9.7500 | 255352.5 ₫ | 10 | Ohm (Ω) | 0.05% | 0603 | Resistor | Ordering | Khôi |  |  |  | RNCF0603AKT10R0
9 | 490-16342-1-ND | GRM1885C1H1R0WA01D | CAP CER 1PF 50V C0G/NP0 0603 | https://www.digikey.com/en/products/detail/murata-electronics/GRM1885C1H1R0WA01D/7363086 | 25 | $0.1090 | $2.7250 | 71367.75 ₫ | 1P | Farad (F) | 5.00% | 0603 | Capacitor | Ordering | Khôi |  |  |  | GRM1885C1H1R0WA01D
10 | 505-AD8066ARZ-R7CT-ND | AD8066ARZ-R7 | IC VOLTAGE FEEDBACK 2 CIRC 8SOIC | https://www.digikey.com/en/products/detail/analog-devices-inc/AD8066ARZ-R7/654014 | 4 | $8.0100 | $32.0400 | 839127.6 ₫ | NaN | N/A | NaN |  | IC | Ordering | Khôi |  |  |  | AD8066ARZ-R7
11 | 505-ADP2303ARDZ-5.0-R7CT-ND | ADP2303ARDZ-5.0-R7 | IC REG BUCK 5V 3A 8SOIC | https://www.digikey.com/en/products/detail/analog-devices-inc/ADP2303ARDZ-5-0-R7/2606549 | 3 | $4.1900 | $12.5700 | 329208.3 ₫ | NaN | N/A | NaN |  | IC-Power | Ordering | Khôi |  |  |  | ADP2303ARDZ-5.0-R7
12 | 505-ADP7118AUJZ-3.3-R7CT-ND | ADP7118AUJZ-3.3-R7 | IC REG LIN 3.3V 200MA TSOT-23-5 | https://www.digikey.com/en/products/detail/analog-devices-inc/ADP7118AUJZ-3-3-R7/5056890 | 3 | $2.9400 | $8.8200 | 230995.8 ₫ | NaN | N/A | NaN |  | IC-Power | Ordering | Khôi |  |  |  | ADP7118AUJZ-3.3-R7
13 | 478-KGM15ACG1H102FTCT-ND | KGM15ACG1H102FT | CAP CER 1000PF 50V C0G/NP0 0603 | https://www.digikey.com/en/products/detail/kemet/c0402c102k5ractu/411034 | 10 | $0.0260 | $0.2600 | 6809.4 ₫ | 1000P | Farad (F) | 1.00% | 0603 | Capacitor | Ordering | Khôi |  |  |  | KGM15ACG1H102FT
14 | 2019-RN73R1JTTD22R0B25CT-ND | RN73R1JTTD22R0B25 | RES 22 OHM 0.1% 1/10W 0603 | https://www.digikey.com/en/products/detail/koa-speer-electronics-inc/RN73R1JTTD22R0B25/10013029 | 10 | $0.0700 | $0.7000 | 18333 ₫ | 22 | Ohm (Ω) | 0.1% | 0603 | Resistor | Ordering | Khôi |  |  |  | RN73R1JTTD22R0B25
15 | 490-GCM1885C2A561FA16DCT-ND | GCM1885C2A561FA16D | CAP CER 560PF 100V C0G/NP0 0603 | https://www.digikey.com/en/products/detail/murata-electronics/GCM1885C2A561FA16D/11618566 | 25 | $0.0820 | $2.0500 | 53689.5 ₫ | 560P | Farad (F) | 1.00% | 0603 | Capacitor | Ordering | Khôi |  |  |  | GCM1885C2A561FA16D
16 | 399-14491-1-ND | C0603C161F5GACTU | CAP CER 160PF 50V C0G/NP0 0603 | https://www.digikey.com/en/products/detail/kemet/C0603C161F5GACTU/2200035 | 20 | $0.7130 | $14.2600 | 373469.4 ₫ | 160P | Farad (F) | 1.00% | 0603 | Capacitor | Ordering | Khôi |  |  |  | C0603C161F5GACTU
17 | 311-3897-1-ND | CC0603FRNPO9BN390 | CAP CER 39PF 50V C0G/NPO 0603 | https://www.digikey.sg/en/products/detail/yageo/CC0603FRNPO9BN390/5883506 | 10 | $0.1180 | $1.1800 | 30904.2 ₫ | 39P | Farad (F) | 1.00% | 0603 | Capacitor | Ordering | Khôi |  |  |  | CC0603FRNPO9BN390
18 | 399-C0603C681F5GACTUCT-ND | C0603C681F5GACTU | CAP CER 680PF 50V C0G/NP0 0603 | https://www.digikey.com/en/products/detail/kemet/C0603C681F5GACTU/2201080 | 10 | $0.5920 | $5.9200 | 155044.8 ₫ | 680P | Farad (F) | 1.00% | 0603 | Capacitor | Ordering | Khôi |  |  |  | C0603C681F5GACTU
19 | 445-MLF1608A1R0JT000CT-ND | MLF1608A1R0JT000 | FIXED IND 1UH 50MA 500 MOHM SMD | https://www.digikey.com/en/products/detail/tdk/MLF1608A1R0JT000/612989 | 10 | $0.1150 | $1.1500 | 30118.5 ₫ | 1u | Henry (H) | 5.00% | 0603 | Inductor | Ordering | Khôi |  |  |  | MLF1608A1R0JT000
20 | 445-175367-1-ND | MLF1608A1R5JT000 | FIXED IND 1.5UH 50MA 700 MOHM | https://www.digikey.com/en/products/detail/tdk/MLF1608A1R5JT000/612991 | 10 | $0.1150 | $1.1500 | 30118.5 ₫ | 1.5u | Henry (H) | 5.00% | 0603 | Inductor | Ordering | Khôi |  |  |  | MLF1608A1R5JT000
21 | 445-MLF1608A1R8JT000CT-ND | MLF1608A1R8JT000 | FIXED IND 1.8UH 50MA 850 MOHM | https://www.digikey.com/en/products/detail/tdk/MLF1608A1R8JT000/612992 | 10 | $0.1150 | $1.1500 | 30118.5 ₫ | 1.8u | Henry (H) | 5.00% | 0603 | Inductor | Ordering | Khôi |  |  |  | MLF1608A1R8JT000
22 | 13-CC0603FRNPO9BN201CT-ND | CC0603FRNPO9BN201 | CAP CER 200PF 50V C0G/NPO 0603 | https://www.digikey.com/en/products/detail/yageo/CC0603FRNPO9BN201/11490449 | 10 | $0.1360 | $1.3600 | 35618.4 ₫ | 200P | Farad (F) | 1.00% | 0603 | Capacitor | Ordering | Khôi |  |  |  | CC0603FRNPO9BN201
23 | 399-C0603C391F5GACTUCT-ND | C0603C391F5GACTU | CAP CER 390PF 50V C0G/NP0 0603 | https://www.digikey.com/en/products/detail/kemet/C0603C391F5GACTU/2200659 | 5 | $1.1400 | $5.7000 | 149283 ₫ | 390P | Farad (F) | 1.00% | 0603 | Capacitor | Ordering | Khôi |  |  |  | C0603C391F5GACTU
24 | 1276-1069-1-ND | CL10C100CB8NNNC | CAP CER 10PF 50V C0G/NP0 0603 | https://www.digikey.com/en/products/detail/samsung-electro-mechanics/CL10C100CB8NNNC/3886727 | 50 | $0.0192 | $0.9600 | 25142.4 ₫ | 10P | Farad (F) | 0.25% | 0603 | Capacitor | Ordering | Khôi |  |  |  | CL10C100CB8NNNC
25 | 490-8120-1-ND | GQM1875C2E120GB12D | CAP CER 12PF 250V C0G/NP0 0603 | https://www.digikey.com/en/products/detail/johanson-technology-inc/QSCP251Q120G1GV001T/1561602 | 10 | $0.1840 | $1.8400 | 48189.6 ₫ | 12P | Farad (F) | 1.00% | 0603 | Capacitor | Ordering | Khôi |  |  |  | GQM1875C2E120GB12D
26 | 399-C0603C121F5GACTUCT-ND | C0603C121F5GACTU | CAP CER 120PF 50V C0G/NP0 0603 | https://www.digikey.com/en/products/detail/kemet/c0603c121f5gactu/2199842 | 10 | $1.0100 | $10.1000 | 264519 ₫ | 120P | Farad (F) | 1.00% | 0603 | Capacitor | Ordering | Khôi |  |  |  | C0603C121F5GACTU
27 | 311-3906-1-ND | CC0603FRNPO9BN820 | CAP CER 82PF 50V C0G/NPO 0603 | https://www.digikey.com/en/products/detail/yageo/CC0603FRNPO9BN820/5883518 | 10 | $0.0860 | $0.8600 | 22523.4 ₫ | 82P | Farad (F) | 1.00% | 0603 | Capacitor | Ordering | Khôi |  |  |  | CC0603FRNPO9BN820
28 | 478-KGM15ACG1H221FTCT-ND | KGM15ACG1H221FT | CAP CER 220PF 50V C0G/NP0 0603 | https://www.digikey.sg/en/products/detail/kyocera-avx/KGM15ACG1H221FT/1116245 | 10 | $0.3220 | $3.2200 | 84331.8 ₫ | 220P | Farad (F) | 1.00% | 0603 | Capacitor | Ordering | Khôi |  |  |  | KGM15ACG1H221FT
29 | 399-C0805C473J3GACTUCT-ND | C0805C473J3GACTU | CAP CER 0.047UF 25V C0G/NP0 0805 | https://www.digikey.com/en/products/detail/kemet/C0805C473J3GACTU/2212853 | 10 | $0.7700 | $7.7000 | 201663 ₫ | 0.047U | Farad (F) | 1.00% | 0805 | Capacitor | Ordering | Khôi |  |  |  | C0805C473J3GACTU
30 | RNCF0603TKY100RCT-ND | RNCF0603TKY100R | RES SMD 100 OHM 0.01% 1/10W 0603 | https://www.digikey.com/en/products/detail/stackpole-electronics-inc/RNCF0603TKY100R/2269696 | 10 | $1.3340 | $13.3400 | 349374.6 ₫ | 100 | Ohm (Ω) | 0.01% | 0603 | Resistor | Ordering | Khôi |  |  |  | RNCF0603TKY100R
31 | 712-QSCP251Q1R0A1GV001TCT-ND | QSCP251Q1R0A1GV001T | CAP CER 1PF 250V NP0 0603 | https://www.digikey.com/en/products/detail/johanson-technology-inc/QSCP251Q1R0A1GV001T/1919340 | 25 | $0.2220 | $5.5500 | 145354.5 ₫ | 1P | Farad (F) | 0.05% | 0603 | Capacitor | Ordering | Khôi |  |  |  | QSCP251Q1R0A1GV001T
32 | 490-GRT1885C1E103FA02DCT-ND | GRT1885C1E103FA02D | CAP CER 10000PF 25V C0G/NP0 0603 | https://www.digikey.com/en/products/detail/murata-electronics/GRT1885C1E103FA02D/16033576 | 10 | $0.1270 | $1.2700 | 33261.3 ₫ | 10000P | Farad (F) | 1% | 0603 | Capacitor | Ordering | Khôi |  |  |  | GRT1885C1E103FA02D
33 | P2.0KBECT-ND | ERA-3ARW202V | RES SMD 2K OHM 0.05% 1/10W 0603 | https://www.digikey.com/en/products/detail/panasonic-industry/ERA-3ARW202V/3073698 | 10 | $0.3892 | $3.8920 | 101931.48 ₫ | 2K | Ohm (Ω) | 0.05% | 0603 | Resistor | Ordering | Khôi |  |  |  | ERA-3ARW202V
34 | 10-ERA-3AEB52R3VCT-ND | ERA-3AEB52R3V | RES SMD 52.3 OHM 0.1% 1/10W 0603 | https://www.digikey.sg/en/products/detail/panasonic-industry/ERA-3AEB52R3V/2026633 | 25 | $0.0888 | $2.2200 | 58141.8 ₫ | 52.3 | Ohm (Ω) | 0.1% | 0603 | Resistor | Ordering | Khôi |  |  |  | ERA-3AEB52R3V
35 | 490-GCM31C5C1H104FA16LCT-ND | GCM31C5C1H104FA16L | CAP CER 0.1UF 50V C0G/NP0 1206 | https://www.digikey.com/en/products/detail/murata-electronics/GCM31C5C1H104FA16L/11618865 | 10 | $0.6700 | $6.7000 | 175473 ₫ | 0.1U | Farad (F) | 1% | 1206 | Capacitor | Ordering | Khôi |  |  |  | GCM31C5C1H104FA16L
36 | RMCF0805FT60K4CT-ND | RMCF0805FT60K4 | RES 60.4K OHM 1% 1/8W 0805 | https://www.digikey.com/en/products/detail/texas-instruments/TLV75533PDBVR/9356541 | 10 | $0.2580 | $2.5800 | 67570.2 ₫ | 60.4K | Ohm (Ω) | 1% | 0805 | Resistor | Ordering | Khôi |  |  |  | RMCF0805FT60K4
37 | 311-24.3KCRCT-ND | RC0805FR-0724K3L | RES 24.3K OHM 1% 1/8W 0805 | https://www.digikey.sg/en/products/detail/yageo/RC0805FR-0724K3L/727758 | 25 | $0.0440 | $1.1000 | 28809 ₫ | 24.3K | Ohm (Ω) | 1% | 0805 | Resistor | Ordering | Khôi |  |  |  | RC0805FR-0724K3L
38 | RMCF0805FT150KCT-ND | RMCF0805FT150K | RES 150K OHM 1% 1/8W 0805 | https://www.digikey.sg/en/products/detail/stackpole-electronics-inc/RMCF0805FT150K/1760472 | 25 | $0.0370 | $0.9250 | 24225.75 ₫ | 150K | Ohm (Ω) | 1% | 0805 | Resistor | Ordering | Khôi |  |  |  | RMCF0805FT150K
39 | 1276-1040-1-ND | CL10A225KO8NNNC | CAP CER 2.2UF 16V X5R 0603 | https://www.digikey.sg/en/products/detail/samsung-electro-mechanics/CL10A225KO8NNNC/3886698 | 20 | $0.0660 | $1.3200 | 34570.8 ₫ | 2.2U | Farad (F) | 10% | 0603 | Capacitor | Ordering | Khôi |  |  |  | CL10A225KO8NNNC
40 | 490-3886-1-ND | GRM21BR61C106KE15L | CAP CER 10UF 16V X5R 0805 | https://www.digikey.sg/en/products/detail/murata-electronics/GRM21BR61C106KE15L/965900 | 15 | $0.1200 | $1.8000 | 47142 ₫ | 10U | Farad (F) |  | 0805 | Capacitor | Ordering | Khôi |  |  |  | GRM21BR61C106KE15L
41 | 399-C0603C223K5RACTUCT-ND | 399-C0603C223K5RACTUCT-ND | CAP CER 0.022UF 50V X7R 0603 | https://www.digikey.com/en/products/detail/kemet/C0603C223K5RACTU/416043 | 15 | $0.0470 | $0.7050 | 18463.95 ₫ | 0.022U | Farad (F) |  | 0603 | Capacitor | Ordering | Khôi |  |  |  | 399-C0603C223K5RACTUCT-ND
42 | 490-6508-1-ND | GRM31CR60J476KE19L | CAP CER 47UF 6.3V X5R 1206 | https://www.digikey.sg/en/products/detail/murata-electronics/GRM31CR60J476KE19L/2548176 | 10 | $0.2940 | $2.9400 | 76998.6 ₫ | 47U | Farad (F) | 20% | 1206 | Capacitor | Ordering | Khôi |  |  |  | GRM31CR60J476KE19L
43 | SMBJ12A-E3/52GICT-ND | SMBJ12A-E3/52 | TVS DIODE 12VWM 19.9VC DO214AA | https://www.digikey.com/en/products/detail/vishay-general-semiconductor-diodes-division/smbj12a-e3-52/1091513 | 4 | $0.5000 | $2.0000 | 52380 ₫ | NaN | N/A | NaN | DO-214AA | Diode | Ordering | Khôi |  |  |  | SMBJ12A-E3/52
44 | SMBJ8.5ALFCT-ND | SMBJ8.5A | TVS DIODE 8.5VWM 14.4V DO214AA | https://www.digikey.com/en/products/detail/littelfuse-inc/smbj8-5a/688268 | 4 | $0.4900 | $1.9600 | 51332.4 ₫ | NaN | N/A | NaN | DO-214AA | Diode | Ordering | Khôi |  |  |  | SMBJ8.5A
45 | SK54A-LTPMSCT-ND | SK54A-LTP | DIODE SCHOTTKY 40V 5A DO214AC | https://www.digikey.com/en/products/detail/mcc-micro-commercial-components/SK54A-LTP/5114132 | 4 | $0.5700 | $2.2800 | 59713.2 ₫ | NaN | N/A | NaN | DO-214AC | Diode | Ordering | Khôi |  |  |  | SK54A-LTP
46 | SK34A-LTPMSCT-ND | SK34A-LTP | DIODE SCHOTTKY 40V 3A DO214AC | https://www.digikey.com/en/products/detail/mcc-micro-commercial-components/SK34A-LTP/2642021 | 4 | $0.4300 | $1.7200 | 45046.8 ₫ | NaN | N/A | NaN | DO-214AC | Diode | Ordering | Khôi |  |  |  | SK34A-LTP
47 | SRR1260-4R7YCT-ND | SRR1260-4R7Y | FIXED IND 4.7UH 6.8A 15.5 MOHM | https://www.digikey.com/en/products/detail/bourns-inc/SRR1260-4R7Y/2352901 | 4 | $1.0500 | $4.2000 | 109998 ₫ | NaN | N/A | NaN | SMD | Inductor | Ordering | Khôi |  |  |  | SRR1260-4R7Y
48 | 490-18407-1-ND | DFE322520FD-4R7M=P2 | FIXED IND 4.7UH 2A 98 MOHM SMD | https://www.digikey.com/en/products/detail/murata-electronics/DFE322520FD-4R7M-P2/10135198 | 4 | $0.7400 | $2.9600 | 77522.4 ₫ | NaN | N/A | NaN | 1210 | Inductor | Ordering | Khôi |  |  |  | DFE322520FD-4R7M=P2
49 | 587-3462-1-ND | NRS5030T6R8MMGJ | FIXED IND 6.8UH 2.3A 52 MOHM SMD | https://www.digikey.com/en/products/detail/taiyo-yuden/NRS5030T6R8MMGJ/4157850 | 10 | $0.2040 | $2.0400 | 53427.6 ₫ | NaN | N/A | NaN |  | Inductor | Ordering | Khôi |  |  |  | NRS5030T6R8MMGJ
50 | AD8130ARMZ-REEL7CT-ND | AD8130ARMZ-REEL7 | IC OPAMP DIFF 1 CIRCUIT 8MSOP | https://www.digikey.com/en/products/detail/analog-devices-inc/AD8130ARMZ-REEL/994072 | 2 | $5.1800 | $10.3600 | 271328.4 ₫ | NaN | N/A | NaN | 8-TSSOP | IC | Out Of Stock | Khôi |  |  |  | AD8130ARMZ-REEL7
51 | 475-SFH4253-RCT-ND | SFH 4253-R | TOPLED |  | 12 | 0.506 | 6.07 | 158973.3 ₫ |  |  |  |  |  | Ordering |  | Biên |  |  | SFH 4253-R
52 | 732-150283FS73103CT-ND | 150283FS73103 | LED IR 730NM 3528 |  | 12 | 1.148 | 13.78 | 360898.2 ₫ |  |  |  |  |  | Ordering |  | Biên |  |  | 150283FS73103
53 | 535-9542-1-ND | ABS07-32.768KHZ-T | CRYSTAL 32.7680KHZ 12.5PF SMD |  | 6 | 0.61 | 3.66 | 95855.4 ₫ |  |  |  |  |  | Ordering |  | Biên |  |  | ABS07-32.768KHZ-T
54 | 535-10630-1-ND | ABM3-8.000MHZ-D2Y-T | CRYSTAL 8.0000MHZ 18PF SMD |  | 6 | 0.67 | 4.02 | 105283.8 ₫ |  |  |  |  |  | Ordering |  | Biên |  |  | ABM3-8.000MHZ-D2Y-T
55 | 296-14273-1-ND | CD4052BPWR | IC SWITCH SP4TX2 240OHM 16TSSOP |  | 6 | 0.46 | 2.76 | 72284.4 ₫ |  |  |  |  |  | Ordering |  | Biên |  |  | CD4052BPWR
56 | 296-11993-1-ND | CD4051BPWR | IC MUX 8:1 240OHM 16TSSOP |  | 6 | 0.46 | 2.76 | 72284.4 ₫ |  |  |  |  |  | Ordering |  | Biên |  |  | CD4051BPWR
57 | 296-19547-1-ND | OPA333AIDCKR | IC OPAMP ZERO-DRIFT 1CIRC SC70-5 |  | 15 | 1.2624 | 37.87 | 991815.3 ₫ |  |  |  |  |  | Ordering |  | Biên |  |  | OPA333AIDCKR
58 | 296-16859-5-ND | OPA380AID | IC TRANSIMPEDANCE 1 CIRC 8SOIC |  | 15 | 4.768 | 71.52 | 1873108.8 ₫ |  |  |  |  |  | Ordering |  | Biên |  |  | OPA380AID
59 | 5399-AMS1117-3.3SOT-223CT-ND | AMS1117-3.3 SOT-223 | IC REG LINEAR 3.3V 1A SOT-223 |  | 10 | 0.054 | 0.54 | 14142.6 ₫ |  |  |  |  |  | Ordering |  | Biên |  |  | AMS1117-3.3 SOT-223
60 | 1276-2867-1-ND | CL10A226KQ8NRNE | CAP CER 22UF 6.3V X5R 0603 |  | 20 | 0.276 | 5.52 | 144568.8 ₫ |  |  |  |  |  | Ordering |  | Biên |  |  | CL10A226KQ8NRNE
61 | CR0603-FX-1002ELFCT-ND | CR0603-FX-1002ELF | RES SMD 10K OHM 1% 1/10W 0603 |  | 50 | 0.016 | 0.8 | 20952 ₫ |  |  |  |  |  | Ordering |  | Biên |  |  | CR0603-FX-1002ELF
62 | 13-RC0603FR-0733RLCT-ND | RC0603FR-0733RL | RES 33 OHM 1% 1/10W 0603 |  | 50 | 0.0138 | 0.69 | 18071.1 ₫ |  |  |  |  |  | Ordering |  | Biên |  |  | RC0603FR-0733RL
63 | RMCF0603FT10R0CT-ND | RMCF0603FT10R0 | RES 10 OHM 1% 1/10W 0603 |  | 50 | 0.012 | 0.6 | 15714 ₫ |  |  |  |  |  | Ordering |  | Biên |  |  | RMCF0603FT10R0
64 | RMCF0603FT4K70CT-ND | RMCF0603FT4K70 | RES 4.7K OHM 1% 1/10W 0603 |  | 50 | 0.012 | 0.6 | 15714 ₫ |  |  |  |  |  | Ordering |  | Biên |  |  | RMCF0603FT4K70
65 | RMCF0603FT1K00CT-ND | RMCF0603FT1K00 | RES 1K OHM 1% 1/10W 0603 |  | 50 | 0.012 | 0.6 | 15714 ₫ |  |  |  |  |  | Ordering |  | Biên |  |  | RMCF0603FT1K00
66 | 311-10.0KHRCT-ND | RC0603FR-0710KL | RES 10K OHM 1% 1/10W 0603 |  | 50 | 0.0138 | 0.69 | 18071.1 ₫ |  |  |  |  |  | Ordering |  | Biên |  |  | RC0603FR-0710KL
67 | 13-RC0603FR-0733RLCT-ND | RC0603FR-0733RL | RES 33 OHM 1% 1/10W 0603 |  | 50 | 0.0138 | 0.69 | 18071.1 ₫ |  |  |  |  |  | Ordering |  | Biên |  |  | RC0603FR-0733RL
68 | 13-CC0603FRNPO9BN200CT-ND | CC0603FRNPO9BN200 | CAP CER 20PF 50V C0G/NPO 0603 |  | 50 | 0.0778 | 3.89 | 101879.1 ₫ |  |  |  |  |  | Ordering |  | Biên |  |  | CC0603FRNPO9BN200
69 | 1276-1033-1-ND | CL10B104JB8NNNC | CAP CER 0.1UF 50V X7R 0603 |  | 50 | 0.0234 | 1.17 | 30642.3 ₫ |  |  |  |  |  | Ordering |  | Biên |  |  | CL10B104JB8NNNC
70 | 490-3886-1-ND | GRM21BR61C106KE15L | CAP CER 10UF 16V X5R 0805 |  | 50 | 0.047 | 2.35 | 61546.5 ₫ |  |  |  |  |  | Ordering |  | Biên |  |  | GRM21BR61C106KE15L
71 | 311-3485-1-ND | CC0603JRX7R7BB105 | CAP CER 1UF 16V X7R 0603 |  | 50 | 0.0866 | 4.33 | 113402.7 ₫ |  |  |  |  |  | Ordering |  | Biên |  |  | CC0603JRX7R7BB105
72 | 13-PA0603FRP070R001LCT-ND | PA0603FRP070R001L | RES 0.001 OHM 1% 1/10W 0603 |  | 30 | 0.482 | 14.46 | 378707.4 ₫ |  |  |  |  |  | Ordering |  | Biên |  |  | PA0603FRP070R001L
73 | 1276-2867-1-ND | CL10A226KQ8NRNE | CAP CER 22UF 6.3V X5R 0603 |  | 20 | 0.276 | 5.52 | 144568.8 ₫ |  |  |  |  |  | Ordering |  | Biên |  |  | CL10A226KQ8NRNE
74 | 5407-ESP32-S3-WROOM-1-N8R2CT-ND | ESP32-S3-WROOM-1-N8R2 | SMD MODULE, ESP32-S3R2 WITH 2 MB |  | 5 | 5.88 | 17.64 | 461991.6 ₫ |  |  |  |  |  | Ordering |  | Biên |  |  | ESP32-S3-WROOM-1-N8R2
75 | TMK212AB7475KG-T | TMK212AB7475KG-T | CAP CER 4.7UF 25V X7R 0805 | https://www.digikey.tw/en/products/detail/taiyo-yuden/TMK212AB7475KG-T/2714168 | 10 | 0.143 | $1.4300 | 37451.7 ₫ | 4.7u | F | ±10% | 0805 | Ceramic Capacitors |  | Nga |  |  |  | TMK212AB7475KG-T
76 | 1276-1184-2-ND | CL10B105KA8NNNC | CAP CER 1UF 25V X7R 0603 | https://www.digikey.tw/en/products/detail/samsung-electro-mechanics/CL10B105KA8NNNC/3886842 | 10 | 0.1 | $1.0000 | 26190 ₫ | 1u | F | ±10% | 0603 | Ceramic Capacitors |  | Nga |  |  |  | CL10B105KA8NNNC
77 | 478-KAM32LR72A475KUTR-ND | 12101C475K4T2A | CAP CER 4.7UF 100V X7R 1210 | https://www.digikey.tw/en/products/detail/kyocera-avx/12101C475K4T2A/9374708 | 10 | 0.59 | $5.9000 | 154521 ₫ | 4.7u | F | ±10% | 1210 | Ceramic Capacitors |  | Nga |  |  |  | 12101C475K4T2A
78 | 1763-1206B104J101N-ND | 1206B104J101N | MLCC 1206 100V 100NF X7R | https://www.digikey.tw/en/products/detail/knowles-novacap/1206B104J101N/22208472 | 10 | 1.37 | $13.7000 | 358803 ₫ | 100n | F | ±5% | 1206 | Ceramic Capacitors |  | Nga |  |  |  | 1206B104J101N
79 | 1276-1184-2-ND | CL10B105KA8NNNC | CAP CER 1UF 25V X7R 0603 | https://www.digikey.tw/en/products/detail/samsung-electro-mechanics/CL10B105KA8NNNC/3886842 | 10 | 0.04 | $0.4000 | 10476 ₫ | 1u | F |  | 0603 | Ceramic Capacitors |  | Nga |  |  |  | CL10B105KA8NNNC
80 | 490-GRM21BZ71E106KE15LTR-ND | GRM21BZ71E106KE15L | CAP CER 10UF 25V X7R 0805 | https://www.digikey.tw/en/products/detail/murata-electronics/GRM21BZ71E106KE15L/13904911 | 10 | 0.2 | $2.0000 | 52380 ₫ | 10u | F |  | 0805 | Ceramic Capacitors |  | Nga |  |  |  | GRM21BZ71E106KE15L
81 | GRM21BZ71A226ME15L | GRM21BZ71A226ME15L | CAP CER 22UF 10V X7R 0805 | https://www.digikey.tw/en/products/detail/murata-electronics/GRM21BZ71A226ME15L/13904953 | 10 | 0.2 | $2.0000 | 52380 ₫ | 22u | F |  | 0805 | Ceramic Capacitors |  | Nga |  |  |  | GRM21BZ71A226ME15L
82 | GRM1885C1H103JA01D | GRM1885C1H103JA01D | Cap 10nF 50V C0G 0603 | https://www.digikey.tw/en/products/detail/murata-electronics/GRM1885C1H103JA01D/4421555 | 10 | 0.07 | $0.7000 | 18333 ₫ | 10n | F |  | 0805 | Ceramic Capacitors |  | Nga |  |  |  | GRM1885C1H103JA01D
83 | GRM1885C1H100JA01D | GRM1885C1H100JA01D | Cap 10pF 50V C0G 0603 | https://www.digikey.tw/en/products/detail/murata-electronics/GRM1885C1H100JA01D/586930 | 10 | 0.07 | $0.7000 | 18333 ₫ | 10p | F |  | 0805 | Ceramic Capacitors |  | Nga |  |  |  | GRM1885C1H100JA01D
84 | GRM188R71E104KA01D | C0603C104K3RACTU | CAP CER 0.1UF 25V X7R 0603 | https://www.digikey.tw/en/products/detail/kemet/C0603C104K3RACTU/416044 | 10 | 0.1 | $1.0000 | 26190 ₫ | 0.1u | F |  | 0603 | Ceramic Capacitors |  | Nga |  |  |  | C0603C104K3RACTU
85 | TYS6045220M-10 | TYS6045220M-10 | FIXED IND 22UH 1.8A 89 MOHM SMD | https://www.digikey.tw/en/products/detail/laird-signal-integrity-products/TYS6045220M-10/4733498 | 10 | 0.43 | $4.3000 | 112617 ₫ | 22u | H | ±20% |  | Fixed Inductors | OOS | Nga |  |  |  | TYS6045220M-10
86 | 505-LT8300IS5#TRMPBFCT-ND | LT8300IS5#TRMPBF | IC REG FLYBACK 260MA TSOT23-5 | https://www.digikey.tw/zh/products/detail/analog-devices-inc/lt8300is5-trmpbf/3676957 | 3 | 10.39 | $31.1700 | 816342.3 ₫ | NaN | N/A | NaN | TSOT23-5 | IC | Ordering | Nga |  |  |  | LT8300IS5#TRMPBF
87 | 1727-PMEG100T10ELRXTR-ND | PMEG100T10ELRX | DIODE SCHOTTKY 100V 1A SOD123W | https://www.digikey.tw/en/products/detail/nexperia-usa-inc/PMEG100T10ELRX/15777950 | 10 | 0.46 | $4.6000 | 120474 ₫ | NaN | N/A | NaN | DO-214AC, SMA | Diode |  | Nga |  |  |  | PMEG100T10ELRX
88 | 2019-RK73G2ATTD1004FCT-ND | RK73G2ATTD1004F | 1 MOhms ±1% 0.125W, 1/8W Chip Resistor 0805 | https://www.digikey.tw/zh/products/detail/koa-speer-electronics-inc/RK73G2ATTD1004F/13576138 | 10 | 0.22 | $2.2000 | 57618 ₫ | 1M | Ohm | 1% | 0805 | Resistor | Ordering | Nga |  |  |  | RK73G2ATTD1004F
89 | RT0603BRD072K32L | RT0603BRD072K32L | RES SMD 2.32KOHM 0.1% 1/10W 0603 | https://www.digikey.tw/en/products/detail/yageo/RT0603BRD072K32L/1072431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 | 10 | 0.07 | $0.7000 | 18333 ₫ | 2.32 | Ohm | 0.1% | 0603 | Resistor |  | Nga |  |  |  | RT0603BRD072K32L
90 | RT0603BRD071KL | RT0603BRD071KL | RES SMD 1K OHM 0.1% 1/10W 0603 | https://www.digikey.tw/en/products/detail/yageo/RT0603BRD071KL/1072344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 | 10 | 0.07 | $0.7000 | 18333 ₫ | 1K | Ohm | 0.1% | 0603 | Resistor |  | Nga |  |  |  | RT0603BRD071KL
91 | ERA-3AEB4990V | ERA-3AEB4990V | Resistor 499R 0.1% 0603 | https://www.digikey.tw/en/products/detail/panasonic-industry/ERA-3AEB4990V/2026721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 | 10 | 0.1 | $1.0000 | 26190 ₫ | 499 | Ohm | 0.1% | 0805 | Resistor |  | Nga |  |  |  | ERA-3AEB4990V
92 | ERA-3AEB104V | ERA-3AEB104V | Resistor 100k 0.5% 0603 | https://www.digikey.tw/en/products/detail/panasonic-industry/ERA-3AEB104V/1465902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 | 10 | 0.1 | $1.0000 | 26190 ₫ | 100k | Ohm | 0.5% | 0603 | Resistor |  | Nga |  |  |  | ERA-3AEB104V
93 | ERA-3AEB103V | ERA-3AEB103V | Resistor 10k 0.5% 0603 | https://www.digikey.tw/en/products/detail/panasonic-industry/ERA-3AEB103V/1465878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 | 10 | 0.1 | $1.0000 | 26190 ₫ | 10k | Ohm | 0.5% | 0603 | Resistor |  | Nga |  |  |  | ERA-3AEB103V
94 | ERA-3AEB472V | ERA-3AEB472V | RES SMD 4.7K OHM 0.1% 1/10W 0603 | https://www.digikey.tw/en/products/detail/panasonic-industry/ERA-3AEB472V/1465870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 | 10 | 0.1 | $1.0000 | 26190 ₫ | 4.7k | Ohm | 0.1% | 0603 | Resistor |  | Nga |  |  |  | ERA-3AEB472V
95 | ERJ-8ENF1001V | ERJ-8ENF1001V | Resistor 1k 1% 1/4W 1206 | https://www.digikey.tw/en/products/detail/panasonic-industry/ERJ-8ENF1001V/86206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 | 10 | 0.2 | $2.0000 | 52380 ₫ | 1k | Ohm | 1% | 1206 | Resistor |  | Nga |  |  |  | ERJ-8ENF1001V
96 | ERA-3AEB101V | ERA-3AEB101V | RES SMD 100 OHM 0.1% 1/10W 0603 | https://www.digikey.tw/en/products/detail/panasonic-industry/ERA-3AEB101V/1465830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 | 10 | 0.1 | $1.0000 | 26190 ₫ | 100 | Ohm | 0.1% | 0603 | Resistor |  | Nga |  |  |  | ERA-3AEB101V
97 | P20.5KDBCT-ND | ERA-3AEB2052V | RES SMD 20.5KOHM 0.1% 1/10W 0603 | https://www.digikey.tw/zh/products/detail/panasonic-industry/ERA-3AEB2052V/2026864 | 10 | 0.1 | $1.0000 | 26190 ₫ | 20.5k | Ohm | 0.1% | 0603 | Resistor |  | Nga |  |  |  | ERA-3AEB2052V
98 | 296-30203-2-ND | C0603C104K3RACTU | IC REG LIN POS ADJ 100MA 8HVSSOP | https://www.digikey.tw/en/products/detail/texas-instruments/TPS7A1601DGNR/2811171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 | 10 | 2.86 | $28.6000 | 749034 ₫ |  |  |  |  |  |  | Nga |  |  |  | C0603C104K3RACTU
99 | AMS1117-3.3 | AMS1117-3.3 | IC REG LINEAR 3.3V 1A SOT-223-3L | https://www.digikey.tw/en/products/detail/evvo/AMS1117-3-3/22482148 | 10 | 0.3 | $3.0000 | 78570 ₫ |  |  |  |  |  |  | Nga |  |  |  | AMS1117-3.3
100 | LT6375AHMS#PBF | LT6375AHMS#PBF | Precision diff amp (Howland core) | https://www.digikey.tw/en/products/detail/analog-devices-inc/LT6375AHMS-PBF/5825341 | 3 | 15.25 | $45.7500 | 1198192.5 ₫ |  |  |  |  |  |  | Nga |  |  |  | LT6375AHMS#PBF
101 | LTC6090CS8E-5#PBF | LTC6090CS8E-5#PBF | High-voltage op-amp 140V | https://www.digikey.tw/en/products/detail/analog-devices-inc/LTC6090CS8E-5-PBF/4864140 | 3 | 10.7 | $32.1000 | 840699 ₫ |  |  |  |  |  |  | Nga |  |  |  | LTC6090CS8E-5#PBF
102 | HIP4081AIBZ | HIP4081AIBZ | Full-bridge gate driver 80V | https://www.digikey.tw/en/products/detail/renesas-electronics-corporation/HIP4081AIBZ/821444 | 5 | 8.14 | $40.7000 | 1065933 ₫ |  |  |  |  |  |  | Nga |  |  |  | HIP4081AIBZ
103 | DMN6040SSD-13 | DMN6040SSD-13 | MOSFET 2N-CH 60V 5A 8SO | https://www.digikey.tw/en/products/detail/diodes-incorporated/DMN6040SSD-13/3481129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 | 10 | 1 | $10.0000 | 261900 ₫ |  |  |  |  |  |  | Nga |  |  |  | DMN6040SSD-13
104 | ERFSM050162RZ | ERFSM050162RZ | PTC polyfuse 500mA hold | https://www.digikey.tw/en/products/detail/excel-cell-electronic-co-ltd/ERFSM050162RZ/25813160 | 5 | 0.2 | $1.0000 | 26190 ₫ |  |  |  |  |  |  | Nga |  |  |  | ERFSM050162RZ
105 | SMAJ15CA | SMAJ15CA | TVS bidirectional 15V | https://www.digikey.tw/en/products/detail/littelfuse-inc/SMAJ15CA/762277 | 10 | 0.46 | $4.6000 | 120474 ₫ |  |  |  |  |  |  | Nga |  |  |  | SMAJ15CA
106 | RMCF0603FT27K4 | RMCF0603FT27K4 | RES 27.4K OHM 1% 1/10W 0603 | https://www.digikey.tw/en/products/detail/stackpole-electronics-inc/RMCF0603FT27K4/1760994 | 10 | 0.46 | $4.6000 | 120474 ₫ | 27.4k | Ohm | 0.1% | 0603 | Resistor |  | Nga |  |  |  | RMCF0603FT27K4
