vtmkhoi/Muscular-Atrophy-Measurement-System/hardware/simulation/EIM_ver01.asc

C1: cap; 180pF
C2: cap; 300pF
C3: cap; 330pF
C4: cap; 270pF
C5: cap; 150pF
C6: cap; 15p
C7: cap; 100pF
C8: cap; 33pF
L1: ind; 470n; Rser=1m
L2: ind; 270n; Rser=1m
L3: ind; 390n; Rser=1m
R1: res; 49.9
R2: res; 49.9
R3: res; 22
R4: res; 51
R5: res; 51
R6: res; 0.1
R7: res; {RSET}
R8: res; 3.1k
R9: res; {RTERM}
R10: res; {RTERM}
R11: res; 10.2k
R12: res; 10k
R13: res; 10k
R14: res; 10k
R15: res; 10k
R16: res; 10k
R17: res; 10.2k
R18: res; 10k
R19: res; 200
R20: res; 200
Rf: res; 499
Rg: res; 499
Rsource: res; 51
U1: UniversalOpAmp2
U2: AD8130
U3: AD8014
U5: AD9834; TYPE=0 COMP=1 PHASE0={P0} PHASE1={P1}
U6: UniversalOpAmp2
V1: voltage; 3.3
V2: voltage; 5
V3: voltage; 5
V4: voltage; PULSE(0 3.3 0 2n 2n {0.5/fMCLK-1n} {1/fMCLK})
V5: voltage; PULSE(0 3.3 {2.2/FREQ0} 2n 2n {4/FREQ1} 1m)
V6: voltage; PULSE(0 3.3 {6.2/FREQ0} 2n 2n {2/FREQ0} 1m)
Z_load: res; {RL}
Named nets: 0, V_cc, V_ee, IOUT, IOUTB, SBO, MCLK, FSEL, PSEL, AVDD, IOut, IOutB, VOut_SinEnd, VOut_Buff, VOut_Filtered, V_L+, V_L-
Power supply
.param RTERM=200
.param RSET=6.8k
.param fMCLK=75Meg
.param FREQ0=10Meg
.param FREQ1=1Meg
.param PHASE0=0
.param PHASE1=180
; ===== User parameters =====
.param N=2**28
.param M=2**12
.param F0=int(FREQ0*N/fMCLK)
.param F1=int(FREQ1*N/fMCLK)
.param P0=int(PHASE0*N/360)
.param P1=int(PHASE1*N/360)
Register encoding (Do not change)
Frequency resolution
Phase resolution
Value for register FREQ0
Value for register FREQ1
Value for register PHASE0
Value for register PHASE1
.tran 0 2u 1n
DDS
.include ad8130.cir
.include Ad8014.cir
Differential Amplifier
R1, R2 should be consider to 10 or 22 Ohm
.ac dec 200 100k 200Meg
Buffer
Eliptic 7th-Order LPF
MEHCS
.param RL=1k
