vtmkhoi/Muscular-Atrophy-Measurement-System/hardware/simulation/Filter.asc

C1: cap; 33p
C2: cap; 33p
C3: cap; 10µ
C4: cap; 33p
C5: cap; 10µ
C6: cap; 15p
R1: res; 820
R2: res; 820
R3: res; 2.2Meg
R4: res; 1.1Meg
R5: res; 1000
R6: res; 1000
R7: res; {RSET}
R8: res; 3.1k
R9: res; {RTERM}
R10: res; {RTERM}
U1: LT1363
U2: LT1363
U3: LT1363
U4: LT1363
U5: AD9834; TYPE=0 COMP=1 PHASE0=PHASE0={P0} PHASE1=PHASE1={P1}
V1: voltage; 3.3
V2: voltage; 5
V3: voltage; 5
V4: voltage; PULSE(0 3.3 0 2n 2n {0.5/fMCLK-1n} {1/fMCLK})
V5: voltage; PULSE(0 3.3 {2.2/FREQ0) 2n 2n {4/FREQ1} 1m)
V6: voltage; PULSE(0 3.3 {6.2/FREQ0} 2n 2n {2/FREQ0} 1m)
Named nets: 0, V_cc, V_ee, Vout_LPF, Vout_HPF, Vin_VCCS, Vp, Vn, IOUT, IOUTB, SBO, MCLK, FSEL, PSEL, AVDD
Lowpass Filter
Highpass Filter
Power supply
.param RTERM=200
.param RSET=6.8k
.param fMCLK=75Meg
.param FREQ0=10Meg
.param FREQ1=1Meg
.param PHASE0=0
.param PHASE1=180
; ===== User parameters =====
.param N=2**28
.param M=2**12
.param F0=int(FREQ0*N/fMCLK)
.param F1=int(FREQ1*N/fMCLK)
.param P0=int(PHASE0*N/360)
.param P1=int(PHASE1*N/360)
Register encoding (Do not change)
Frequency resolution
Phase resolution
Value for register FREQ0
Value for register FREQ1
Value for register PHASE0
Value for register PHASE1
