vtmkhoi/Muscular-Atrophy-Measurement-System/hardware/PCB/EIM/EIM.kicad_sch

## KiCad design hardware/PCB/EIM/EIM.kicad_sch (2026-03-28)

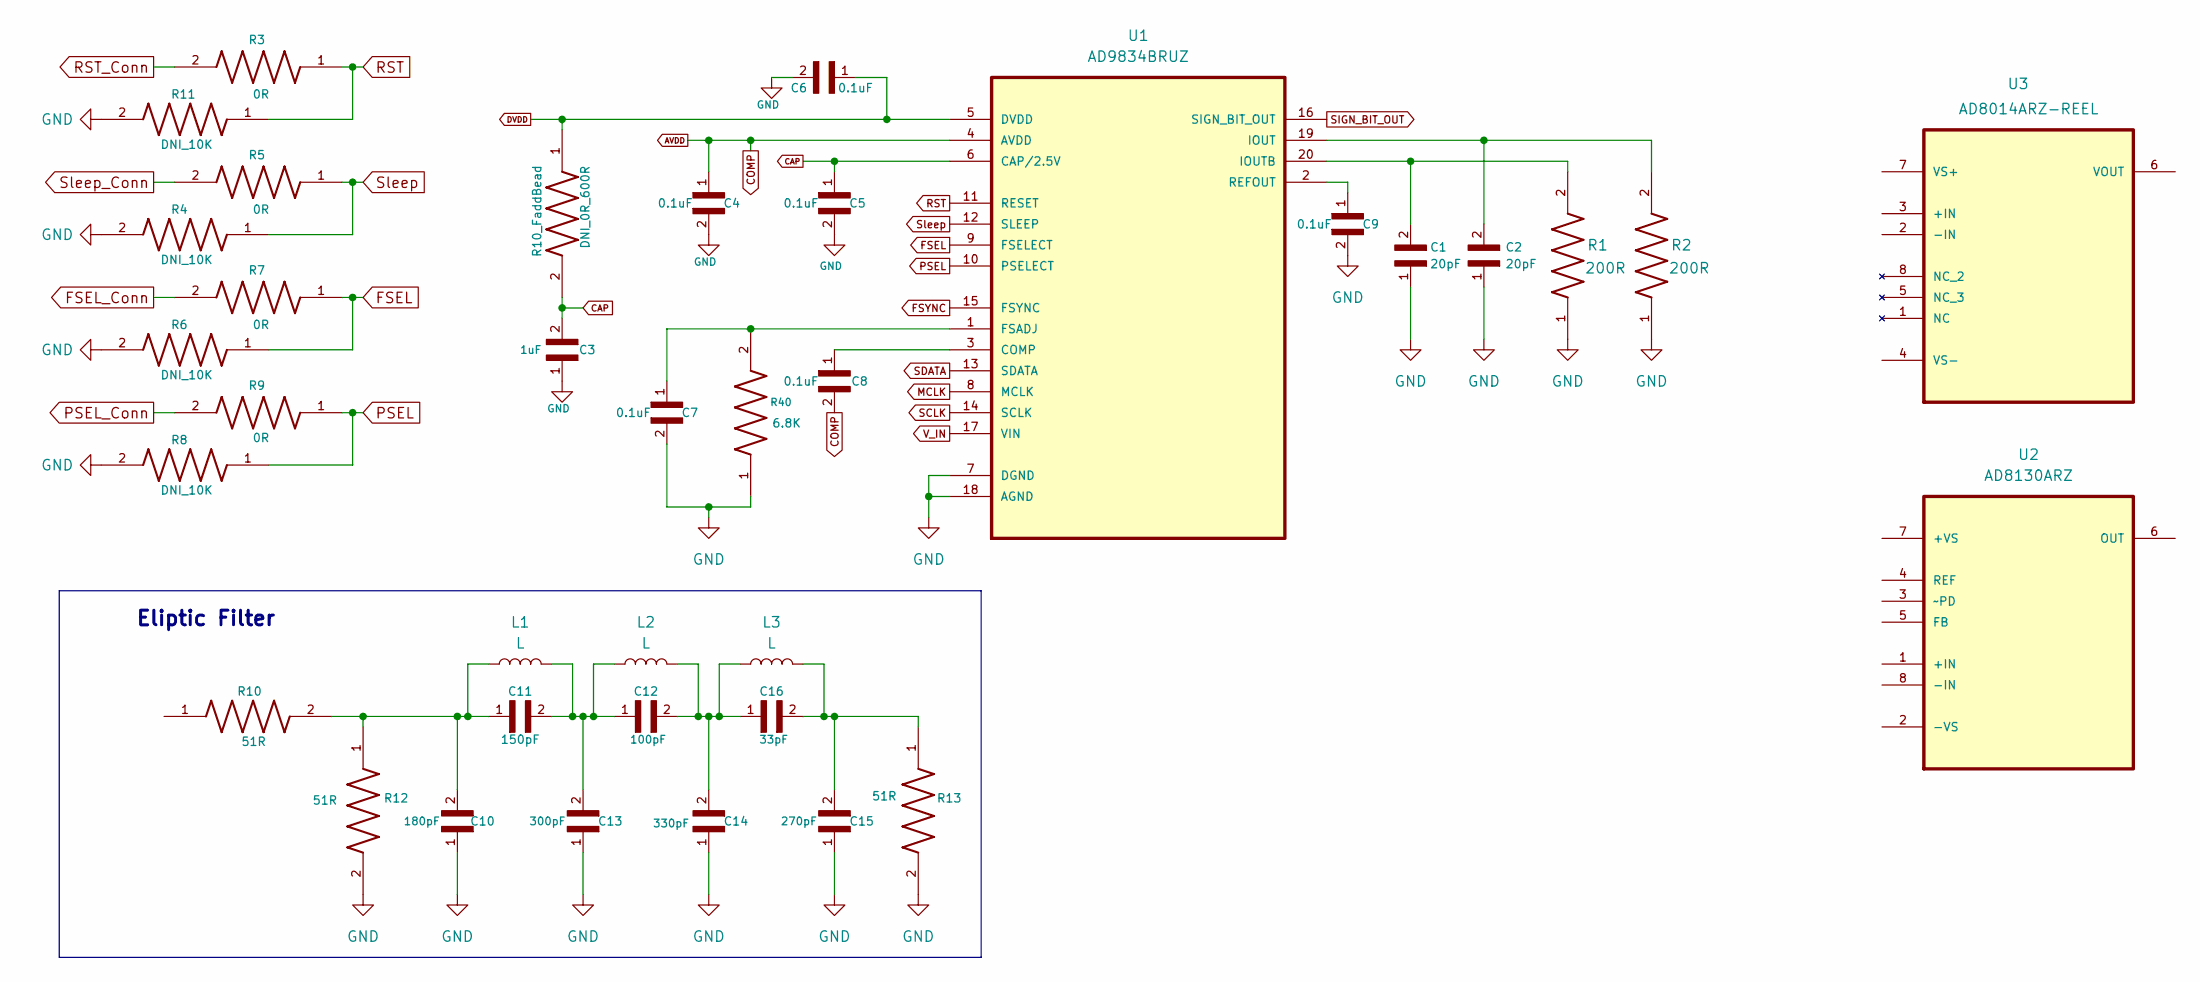
[picture p18: schematic EIM.kicad_sch]

Parts:
C1, C2: 20pF; CAPC1608X94N
C3: 1uF; CAPC1608X94N
C4, C5, C6, C7, C8, C9: 0.1uF; CAPC1005X61N
C10: 180pF; CAPC1608X94N
C11: 150pF; CAPC1005X61N
C12: 100pF; CAPC1608X94N
C13: 300pF; CAPC1608X94N
C14: 330pF; CAPC1608X94N
C15: 270pF; CAPC1608X94N
C16: 33pF; CAPC1608X94N
L1, L2, L3: L
R1, R2: 200R; RES_ERA3AED203V; PARTREV 3/1/2020
R3, R5, R7, R9: 0R; RES_ERA3AED203V; PARTREV 3/1/2020
R4, R6, R8, R11: DNI_10K; RES_ERA3AED203V; PARTREV 3/1/2020
R10, R12, R13: 51R; RES_ERA3AED203V; PARTREV 3/1/2020
R10_FaddBead: DNI_0R_600R; RES_ERA3AED203V; PARTREV 3/1/2020
R40: 6.8K; RES_ERA3AED203V; PARTREV 3/1/2020
U1: AD9834BRUZ; SOP65P640X120-20N; MPN AD9834BRUZ
U2: AD8130ARZ; SOIC127P600X175-8N; MPN AD8130ARZ
U3: AD8014ARZ-REEL; SOIC127P600X175-8N; MPN AD8014ARZ-REEL

Connections:
AVDD: C4.1, C8.2, U1.4 (AVDD)
CAP: C3.2, C5.1, R10_FaddBead.2, U1.6 (CAP/2.5V)
DVDD: C6.1, R10_FaddBead.1, U1.5 (DVDD)
FSEL: R6.1, R7.1, U1.9 (FSELECT)
FSEL_Conn: R7.2
FSYNC: U1.15 (FSYNC)
GND: C1.1, C2.1, C3.1, C4.2, C5.2, C6.2, C7.2, C9.2, C10.1, C13.1, C14.1, C15.1, R1.1, R2.1, R4.2, R6.2, R8.2, R11.2, R12.2, R13.2, R40.1, U1.7 (DGND), U1.18 (AGND)
MCLK: U1.8 (MCLK)
unnamed: C1.2, R1.2, U1.20 (IOUTB)
unnamed: C2.2, R2.2, U1.19 (IOUT)
unnamed: C7.1, R40.2, U1.1 (FSADJ)
unnamed: C8.1, U1.3 (COMP)
unnamed: C9.1, U1.2 (REFOUT)
unnamed: C10.2, C11.1, L1.1, R10.2, R12.1
unnamed: C11.2, C12.1, C13.2, L1.2, L2.1
unnamed: C12.2, C14.2, C16.1, L2.2, L3.1
unnamed: C15.2, C16.2, L3.2, R13.1
PSEL: R8.1, R9.1, U1.10 (PSELECT)
PSEL_Conn: R9.2
RST: R3.1, R11.1, U1.11 (RESET)
RST_Conn: R3.2
SCLK: U1.14 (SCLK)
SDATA: U1.13 (SDATA)
SIGN_BIT_OUT: U1.16 (SIGN_BIT_OUT)
Sleep: R4.1, R5.1, U1.12 (SLEEP)
Sleep_Conn: R5.2
V_IN: U1.17 (VIN)

Notes on the sheet:
Eliptic Filter
