vtmkhoi/Muscular-Atrophy-Measurement-System/hardware/PCB/EIM_Module/dds_signal_generator.kicad_sch

## KiCad design hardware/PCB/EIM_Module/dds_signal_generator.kicad_sch (2026-06-16)

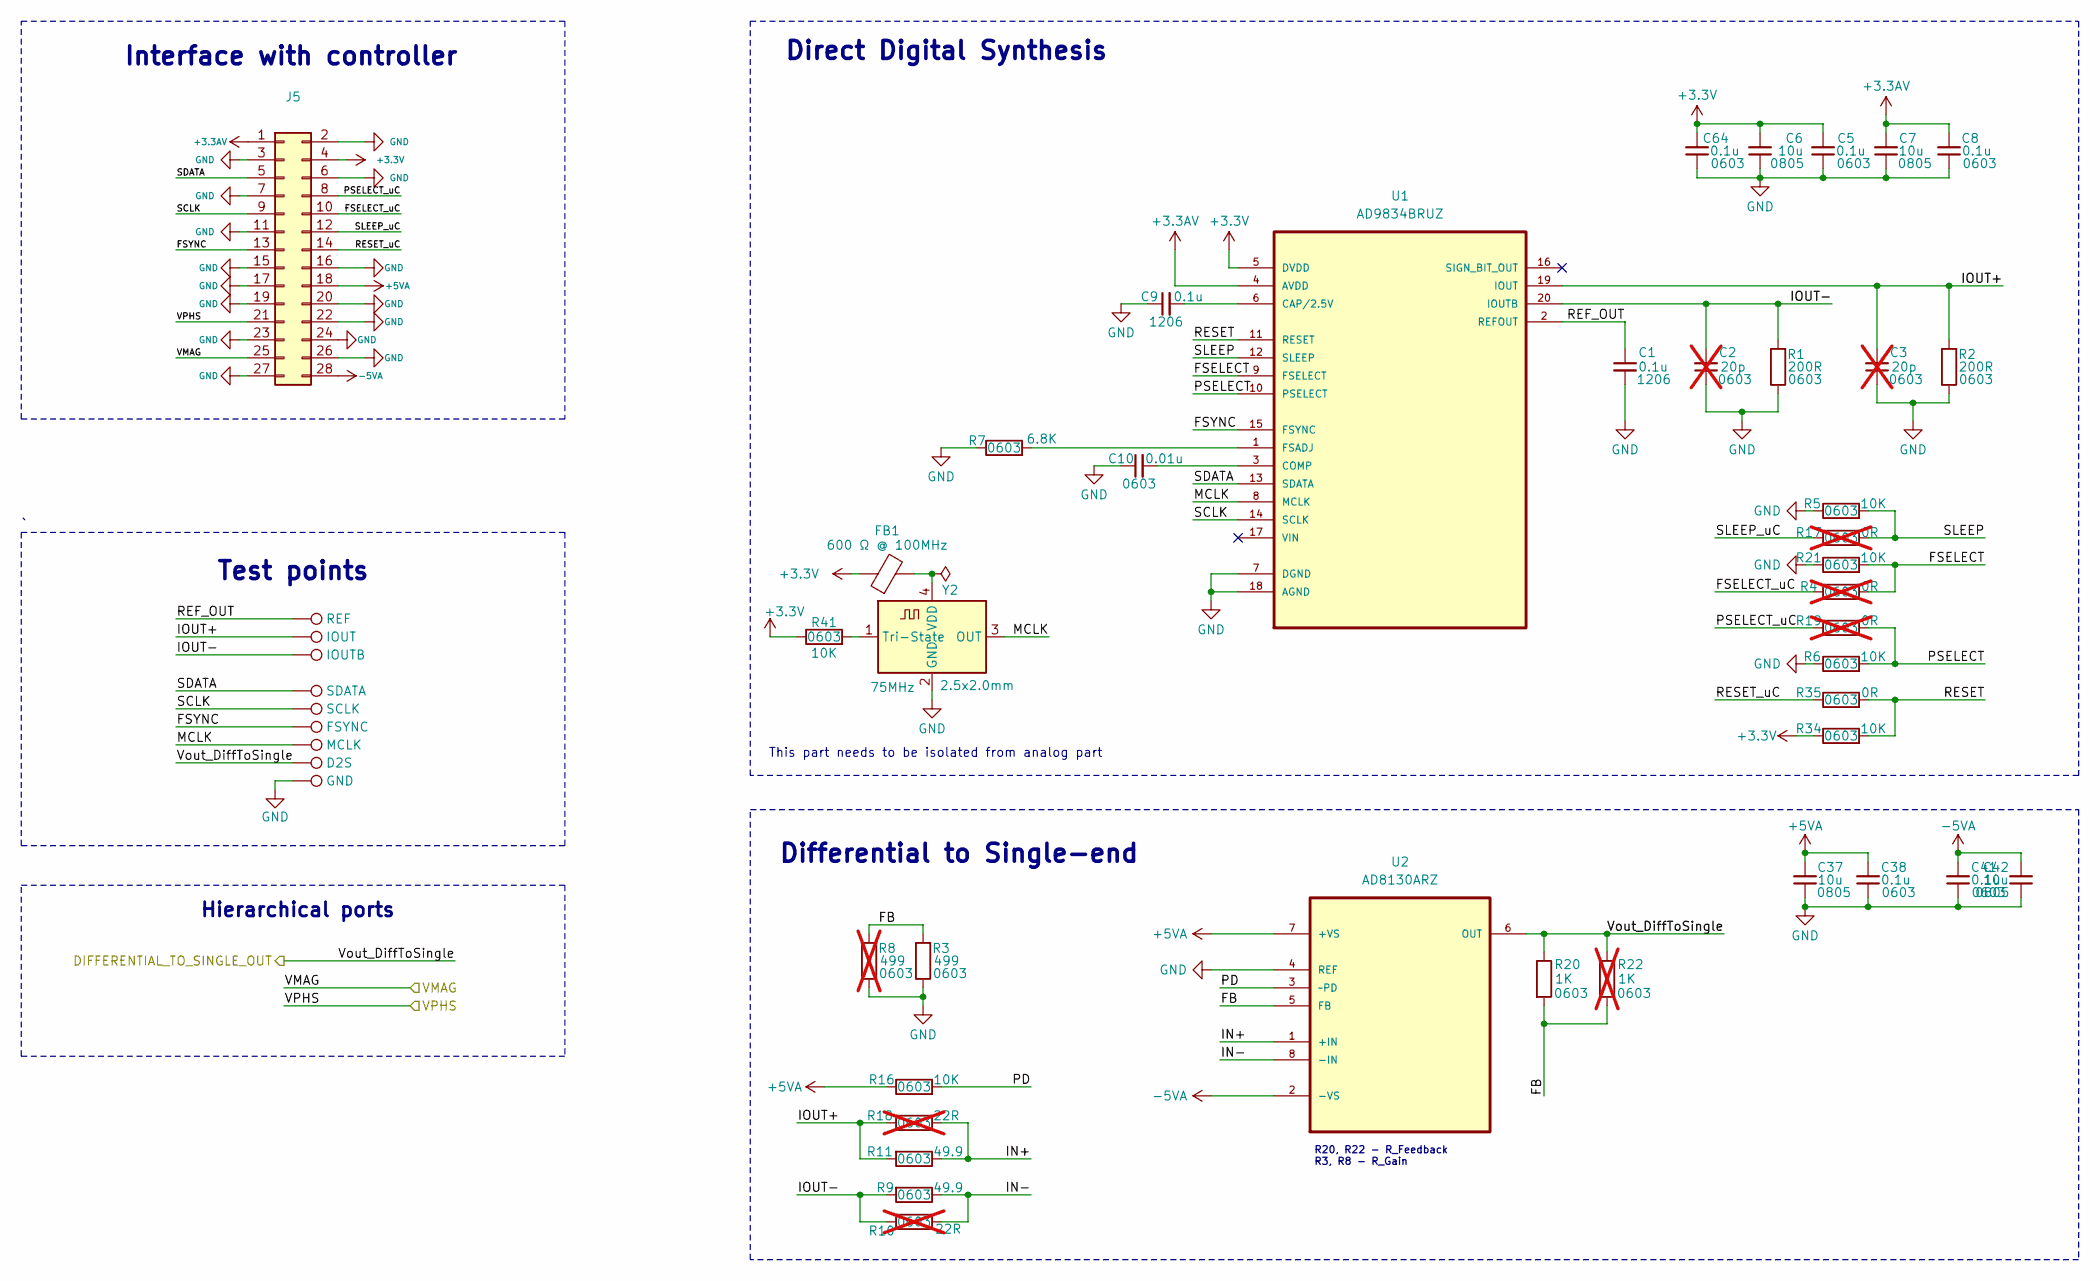
[picture p19: schematic dds_signal_generator.kicad_sch]

Parts:
C1, C9: 0.1u; C_1206_3216Metric
C2, C3: 20p; C_0603_1608Metric; not fitted
C5, C8, C38, C41, C64: 0.1u; C_0603_1608Metric
C6, C7, C37, C42: 10u; C_0805_2012Metric
C10: 0.01u; C_0603_1608Metric
FB1: 600 Ω @ 100MHz; L_0603_1608Metric
J5: Interface with controller; PinSocket_2x14_P2.00mm_Vertical
R1, R2: 200R; R_0603_1608Metric
R3: 499; R_0603_1608Metric
R4, R17, R19: 0R; R_0603_1608Metric; not fitted
R5, R6, R16, R21, R34, R41: 10K; R_0603_1608Metric
R7: 6.8K; R_0603_1608Metric
R8: 499; R_0603_1608Metric; not fitted
R9, R11: 49.9; R_0603_1608Metric
R10, R18: 22R; R_0603_1608Metric; not fitted
R20: 1K; R_0603_1608Metric
R22: 1K; R_0603_1608Metric; not fitted
R35: 0R; R_0603_1608Metric
TP1: REF; TestPoint_Pad_D1.0mm
TP2: IOUT; TestPoint_Pad_D1.0mm
TP3: IOUTB; TestPoint_Pad_D1.0mm
TP5: SDATA; TestPoint_Pad_D1.0mm
TP6: SCLK; TestPoint_Pad_D1.0mm
TP7: FSYNC; TestPoint_Pad_D1.0mm
TP8: MCLK; TestPoint_Pad_D1.0mm
TP9: GND; TestPoint_Pad_D1.0mm
TP10: D2S; TestPoint_Pad_D1.0mm
U1: AD9834BRUZ; SOP65P640X120-20N; MPN AD9834BRUZ
U2: AD8130ARZ; SOIC127P600X175-8N; MPN AD8130ARZ
Y2: 75MHz; Oscillator_SMD_SeikoEpson_SG210-4Pin_2.5x2.0mm

Connections:
+3.3AV: C7.2, C8.2, J5.1, U1.4 (AVDD)
+3.3V: C5.2, C6.2, C64.2, FB1.1, J5.4, R34.1, R41.1, U1.5 (DVDD)
+5VA: C37.2, C38.2, J5.18, R16.1, U2.7 (+VS)
-5VA: C41.2, C42.2, J5.28, U2.2 (-VS)
DIFFERENTIAL_TO_SINGLE_OUT: R20.1, R22.1, TP10.1, U2.6 (OUT)
FB: R3.2, R8.2, R20.2, R22.2, U2.5 (FB)
FSELECT: R4.2, R21.2, U1.9 (FSELECT)
FSELECT_uC: J5.10, R4.1
FSYNC: J5.13, TP7.1, U1.15 (FSYNC)
GND: C1.2, C2.1, C3.1, C5.1, C6.1, C7.1, C8.1, C9.1, C10.1, C37.1, C38.1, C41.1, C42.1, C64.1, J5.2, J5.3, J5.6, J5.7, J5.11, J5.15, J5.16, J5.17, J5.19, J5.20, J5.22, J5.23, J5.24, J5.26, J5.27, R1.1, R2.1, R3.1, R5.1, R6.1, R7.1, R8.1, R21.1, TP9.1, U1.7 (DGND), U1.18 (AGND), U2.4 (REF), Y2.2 (GND)
IN+: R11.1, R18.1, U2.1 (+IN)
IN-: R9.1, R10.1, U2.8 (-IN)
IOUT+: C3.2, R2.2, R11.2, R18.2, TP2.1, U1.19 (IOUT)
IOUT-: C2.2, R1.2, R9.2, R10.2, TP3.1, U1.20 (IOUTB)
MCLK: TP8.1, U1.8 (MCLK), Y2.3 (OUT)
unnamed: C9.2, U1.6 (CAP/2.5V)
unnamed: C10.2, U1.3 (COMP)
unnamed: FB1.2, Y2.4 (VDD)
unnamed: R7.2, U1.1 (FSADJ)
unnamed: R41.2, Y2.1 (Tri-State)
PD: R16.2, U2.3 (~PD)
PSELECT: R6.2, R19.2, U1.10 (PSELECT)
PSELECT_uC: J5.8, R19.1
REF_OUT: C1.1, TP1.1, U1.2 (REFOUT)
RESET: R34.2, R35.2, U1.11 (RESET)
RESET_uC: J5.14, R35.1
SCLK: J5.9, TP6.1, U1.14 (SCLK)
SDATA: J5.5, TP5.1, U1.13 (SDATA)
SLEEP: R5.2, R17.2, U1.12 (SLEEP)
SLEEP_uC: J5.12, R17.1
VMAG: J5.25
VPHS: J5.21

Notes on the sheet:
This part needs to be isolated from analog part
Interface with controller
Direct Digital Synthesis
Differential to Single-end
R20, R22 - R_Feedback R3, R8 - R_Gain
Test points
Hierarchical ports
