vtmkhoi/Muscular-Atrophy-Measurement-System/hardware/PCB/EIM_Module/vccs_load.kicad_sch

## KiCad design hardware/PCB/EIM_Module/vccs_load.kicad_sch (2026-06-16)

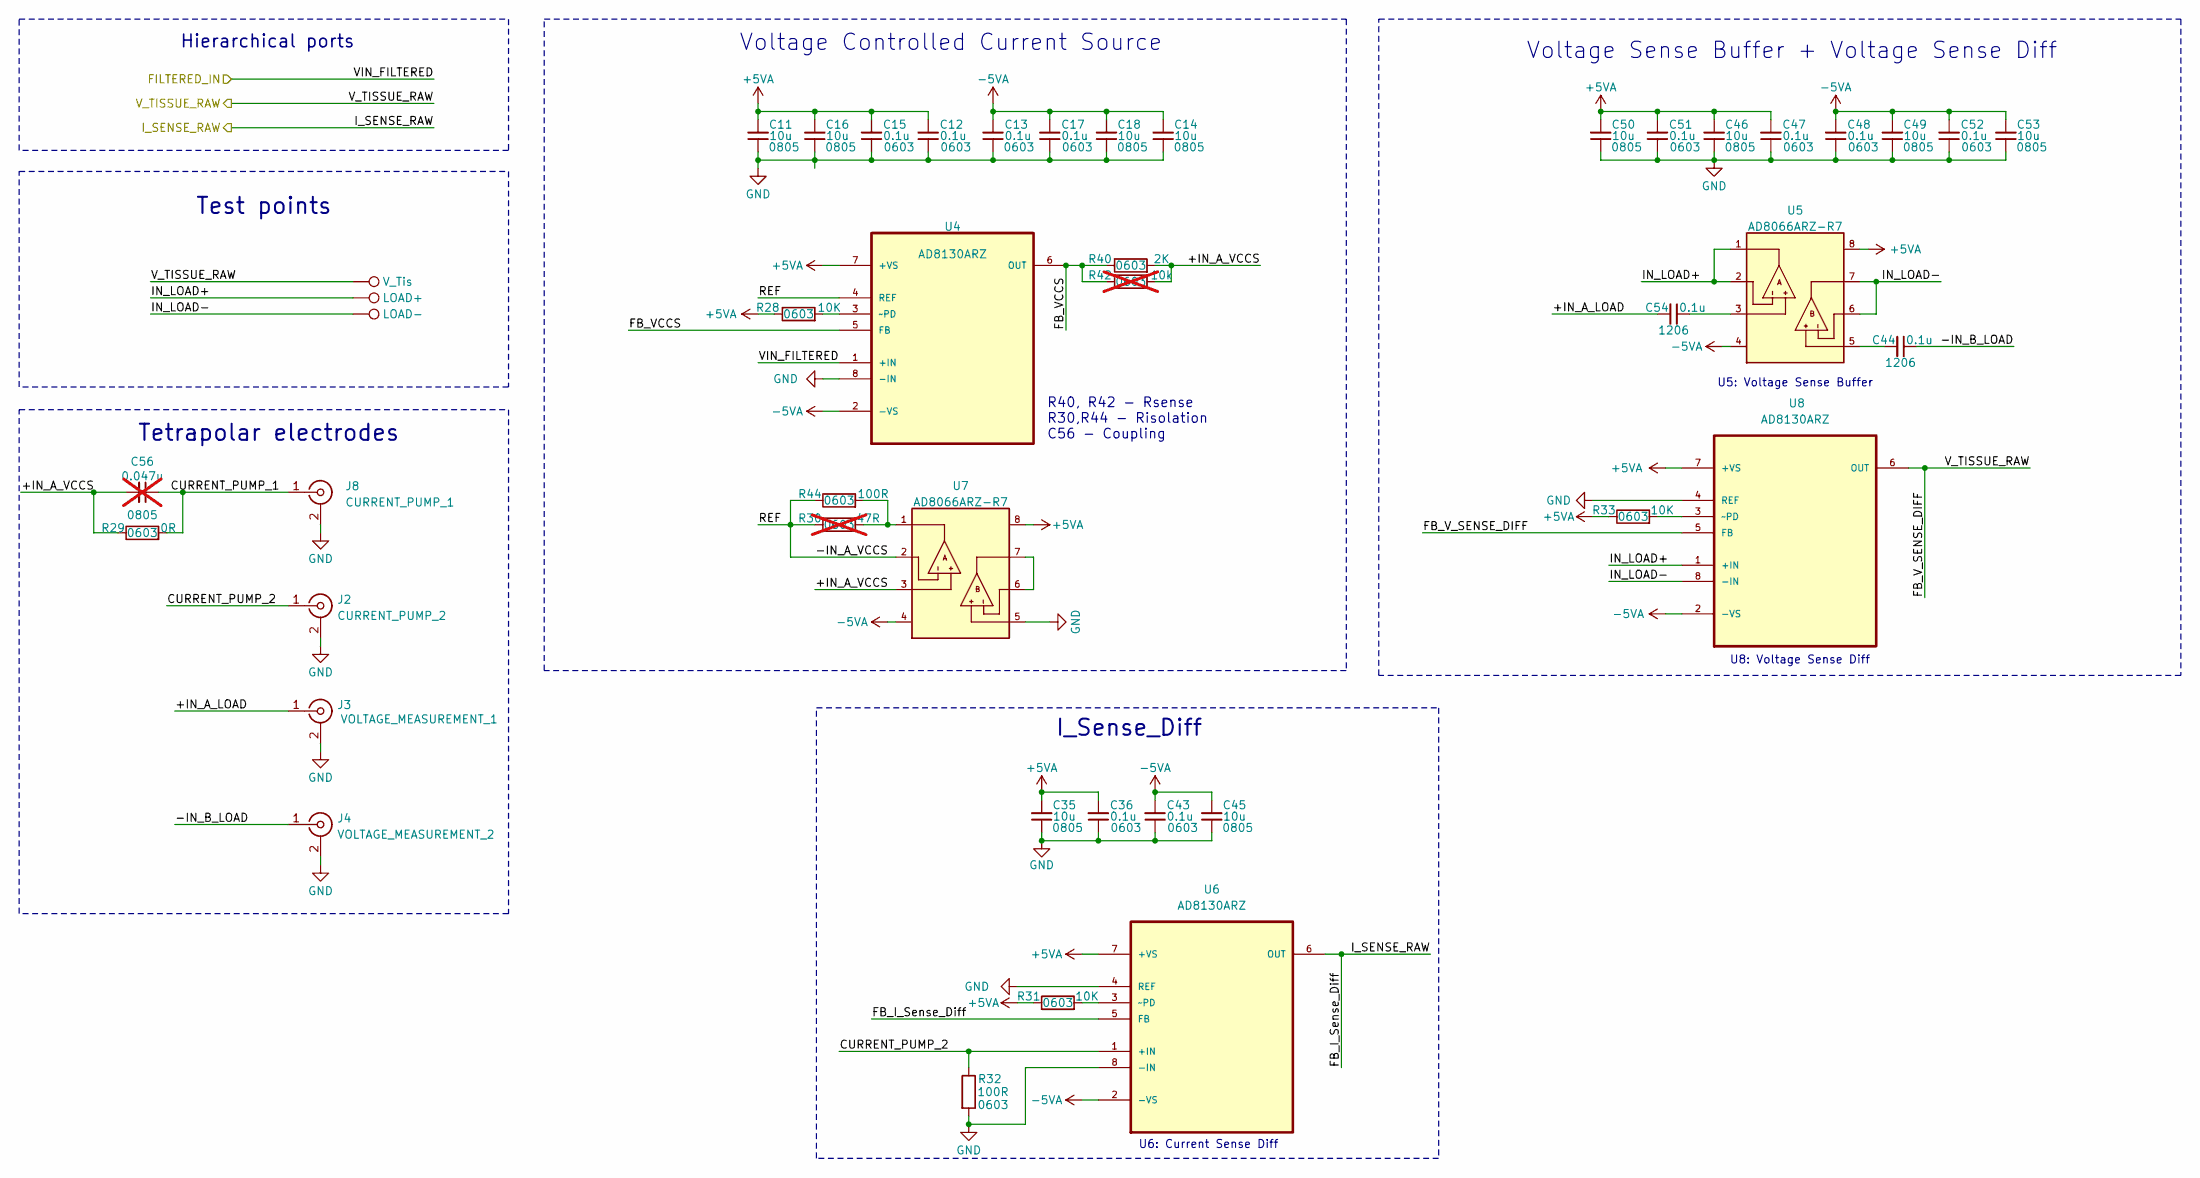
[picture p20: schematic vccs_load.kicad_sch]

Parts:
C11, C14, C16, C18, C35, C45, C46, C49, C50, C53: 10u; C_0805_2012Metric
C12, C13, C15, C17, C36, C43, C47, C48, C51, C52: 0.1u; C_0603_1608Metric
C44, C54: 0.1u; C_1206_3216Metric
C56: 0.047u; C_0805_2012Metric; not fitted
J2: CURRENT_PUMP_2; SMA_Molex_73251-2200_Horizontal
J3: VOLTAGE_MEASUREMENT_1; SMA_Molex_73251-2200_Horizontal
J4: VOLTAGE_MEASUREMENT_2; SMA_Molex_73251-2200_Horizontal
J8: CURRENT_PUMP_1; SMA_Molex_73251-2200_Horizontal
R28, R31, R33: 10K; R_0603_1608Metric
R29: 0R; R_0603_1608Metric
R30: 47R; R_0603_1608Metric; not fitted
R32, R44: 100R; R_0603_1608Metric
R40: 2K; R_0603_1608Metric
R42: 10k; R_0603_1608Metric; not fitted
TP17: V_Tis; TestPoint_Pad_D1.0mm
TP19: LOAD+; TestPoint_Pad_D1.0mm
TP20: LOAD-; TestPoint_Pad_D1.0mm
U4, U6, U8: AD8130ARZ; SOIC127P600X175-8N; MPN AD8130ARZ
U5, U7: AD8066ARZ-R7; SOIC127P600X175-8N

Connections:
+5VA: C11.2, C12.2, C15.2, C16.2, C35.2, C36.2, C46.2, C47.2, C50.2, C51.2, R28.1, R31.1, R33.1, U4.7 (+VS), U5.8, U6.7 (+VS), U7.8, U8.7 (+VS)
+IN_A_LOAD: C54.2, J3.1 (In)
+IN_A_VCCS: C56.2, R29.1, R40.2, R42.2, U7.3
-5VA: C13.2, C14.2, C17.2, C18.2, C43.2, C45.2, C48.2, C49.2, C52.2, C53.2, U4.2 (-VS), U5.4, U6.2 (-VS), U7.4, U8.2 (-VS)
-IN_A_VCCS: R30.1, R44.1, U4.4 (REF), U7.2
-IN_B_LOAD: C44.1, J4.1 (In)
CURRENT_PUMP_1: C56.1, J8.1 (In), R29.2
CURRENT_PUMP_2: J2.1 (In), R32.1, U6.1 (+IN)
FB_I_Sense_Diff: U6.5 (FB), U6.6 (OUT)
FB_VCCS: R40.1, R42.1, U4.5 (FB), U4.6 (OUT)
FB_V_SENSE_DIFF: TP17.1, U8.5 (FB), U8.6 (OUT)
FILTERED_IN: U4.1 (+IN)
GND: C11.1, C12.1, C13.1, C14.1, C15.1, C16.1, C17.1, C18.1, C35.1, C36.1, C43.1, C45.1, C46.1, C47.1, C48.1, C49.1, C50.1, C51.1, C52.1, C53.1, J2.2 (Ext), J3.2 (Ext), J4.2 (Ext), J8.2 (Ext), R32.2, U4.8 (-IN), U6.4 (REF), U6.8 (-IN), U7.5, U8.4 (REF)
IN_LOAD+: TP19.1, U5.1, U5.2, U8.1 (+IN)
IN_LOAD-: TP20.1, U5.6, U5.7, U8.8 (-IN)
unnamed: C44.2, U5.5
unnamed: C54.1, U5.3
unnamed: R28.2, U4.3 (~PD)
unnamed: R30.2, R44.2, U7.1
unnamed: R31.2, U6.3 (~PD)
unnamed: R33.2, U8.3 (~PD)
unnamed: U7.6, U7.7

Notes on the sheet:
Test points
Voltage Controlled Current Source
R40, R42 - Rsense R30,R44 - Risolation C56 - Coupling
U8: Voltage Sense Diff
Voltage Sense Buffer + Voltage Sense Diff
Tetrapolar electrodes
U5: Voltage Sense Buffer
Hierarchical ports
I_Sense_Diff
U6: Current Sense Diff
