vtmkhoi/Muscular-Atrophy-Measurement-System/(commit log)

2026-03-08 main/updated category inside BOM
    [BOM.xlsx, BOM_MAMS.xlsx]
2026-03-08 main/initialize submodule folder for project
    [Electrical_Impedance_Myography-EIM.kicad_pcb, Electrical_Impedance_Myography-EIM.kicad_sch, Near_Infrared_Spectroscopy-NIRS.kicad_pcb, Near_Infrared_Spectroscopy-NIRS.kicad_sch]
2026-03-08 Rename submodule for EIM
    [Electrical_Impedance_Myography-EIM.kicad_pcb, Electrical_Impedance_Myography-EIM.kicad_sch]
2026-03-18 Updated simulation for EIM and removed PCB for restruct folder
    [BOM_MAMS.xlsx, Electrical_Impedance_Myography-EIM.kicad_pcb, Electrical_Impedance_Myography-EIM.kicad_sch, Near_Infrared_Spectroscopy-NIRS.kicad_pcb, Near_Infrared_Spectroscopy-NIRS.kicad_sch]
2026-03-18 software/Test board working
2026-03-27 MAMS-9 update comment for c file, adding VS Code workspace and pinout configuration file
    [pins-configuration.xlsx]
2026-03-27 MAMS-10 Update schematic for DDS and Filter, BOM list and meeting docs
    [BOM_MAMS.xlsx, EIM.kicad_pcb, EIM.kicad_sch]
2026-03-28 MAMS-10 update meeting note
    [BOM_MAMS.xlsx]
2026-04-05 MAMS-33 Update schematic for AD9834 and AD8130
    [BOM_MAMS.xlsx, EIM.kicad_sch, schematics_details.xlsx]
2026-04-06 MAMS-33 updated second order for LOAD and Power block part 1
    [BOM_MAMS.xlsx]
2026-04-08 MAMS-33 updated schematic for DDS, Diff to Single and Buffer blocks, updated lib for AD8014 used in KiCad
    [EIM.kicad_sch]
2026-04-08 MAMS-33 updated BOM with new components in EIM
    [BOM_MAMS.xlsx]
2026-04-09 MAMS-33 updated new bom for filter block
    [BOM_MAMS.xlsx]
2026-04-09 MAMS-33 updated schematic for filter block
    [EIM.kicad_sch]
2026-04-12 MAMS-33 Fixed footprint lib for DDS, Buffer, Diff-2-Single and Filter block
    [EIM.kicad_sch]
2026-04-12 MAMS-33 removed some unused components for BOM
    [BOM_MAMS.xlsx]
2026-04-12 MAMS-33 updated new value for filter block
2026-04-18 MAMS-33: Updated BOM
    [BOM_MAMS.xlsx]
2026-04-18 MAMS-33: Update schematic for load block and library
    [EIM.kicad_sch]
2026-04-19 MAMS-33 updated BOM list
    [BOM_MAMS.xlsx]
2026-04-19 MAMS-33 changed folder logo footprint
2026-04-19 MAMS-33 updated hyerachical schematic and corrected the load block
    [EIM.kicad_pcb, EIM.kicad_sch, EIM_Module.kicad_pcb, EIM_Module.kicad_sch, buffer_filter_blocks.kicad_sch, dds_signal_generator.kicad_sch, gain_phase_detect.kicad_sch, vccs_load.kicad_sch]
2026-05-09 MAMS-33 Updated simulation final and update schematic and PCB
    [EIM_Module.kicad_pcb, EIM_Module_BOM.csv, buffer_filter_blocks.kicad_sch, dds_signal_generator.kicad_sch, gain_phase_detect.kicad_sch, pins-configuration.xlsx, vccs_load.kicad_sch]
2026-05-09 MAMS-33 Re-structure document folder and update new BOMS either 2nd order list
    [BOM_MAMS.xlsx, order_2.xlsx]
2026-05-16 MAMS-38 updated PCB layout for EIM with version using connector
    [BOM_MAMS.xlsx, EIM_Module.kicad_pcb, buffer_filter_blocks.kicad_sch, dds_signal_generator.kicad_sch, gain_phase_detect.kicad_sch, order_2.xlsx, vccs_load.kicad_sch]
2026-05-25 MAMS-40 Updated PCB upto LPF
    [EIM_Module.kicad_pcb, buffer_filter_blocks.kicad_sch, dds_signal_generator.kicad_sch, gain_phase_detect.kicad_sch, vccs_load.kicad_sch]
2026-06-03 MAMS-40 PCB updated for EIM rev 0.0.1
2026-06-06 MAMS-40 PCB for module EIM updated latest
2026-06-07 MAMS-40 Restructed PCB Layout after reviewed
2026-06-07 MAMS-40 Filled power zones
2026-06-14 MAMS-40 updated PCB final version
2026-06-16 MAMS-40 updated PCB EIM latest
