vtmkhoi/Muscular-Atrophy-Measurement-System/(notices)

Notices in the files:
software/00_AD9833/Core/Inc/main.h:
Copyright (c) 2026 STMicroelectronics.
All rights reserved.
This software is licensed under terms that can be found in the LICENSE file
